JHPHELAN/stingray/README.md

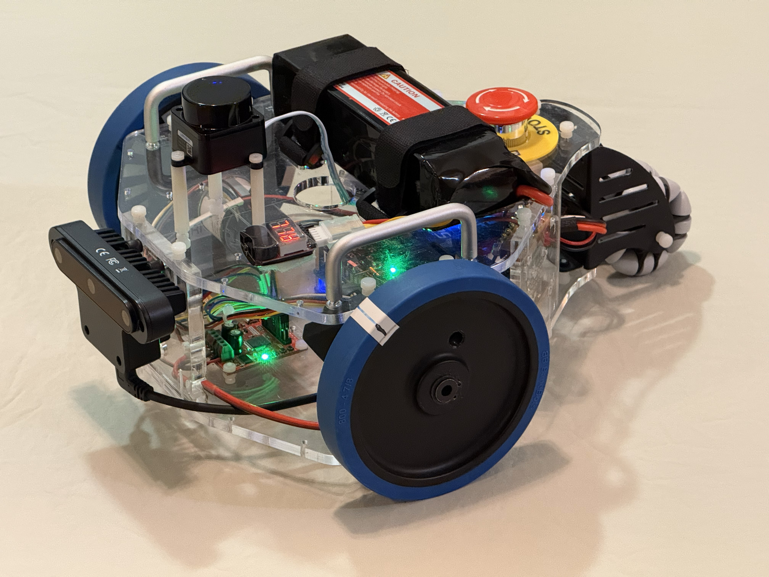
[picture p1: images/Stormy Portrait angle.jpg]


## Stormy full schematic (KiCad 10.0, 2026-10-14)

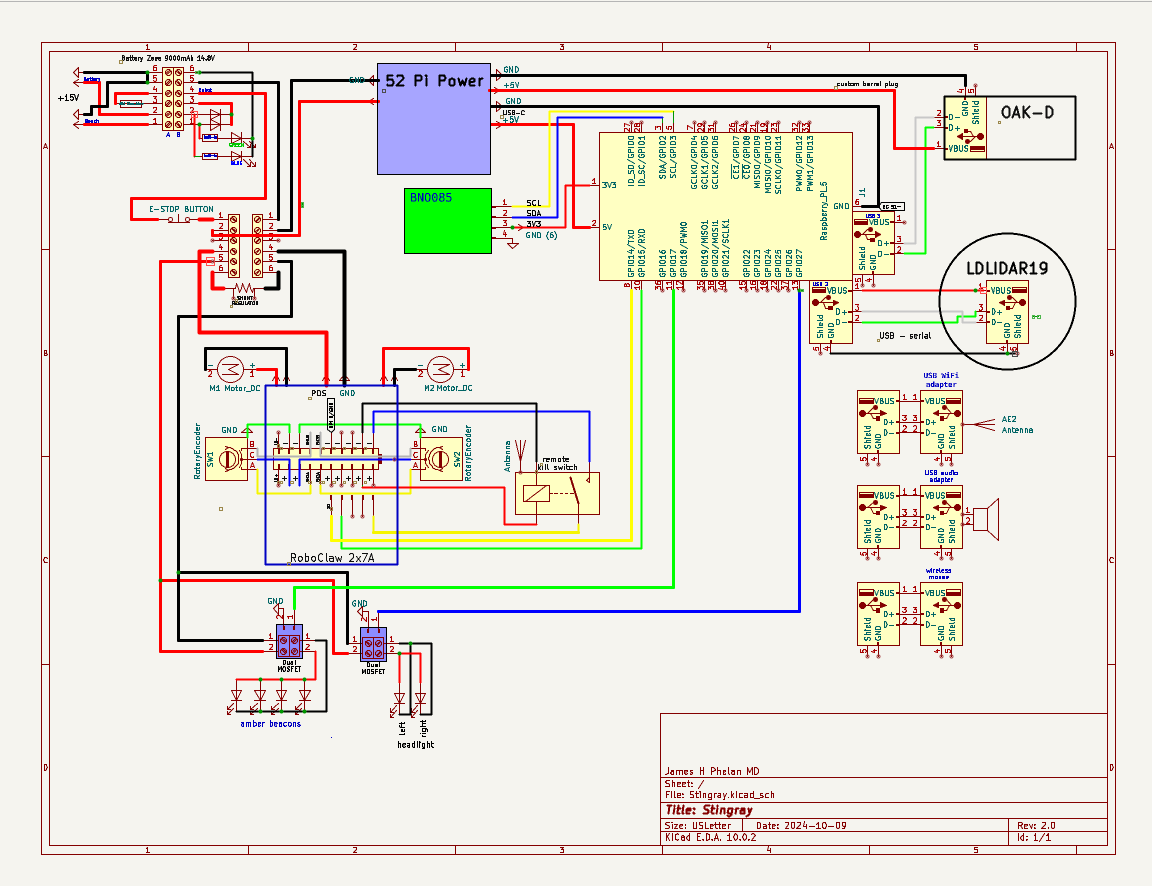
[picture p2: images/Schematic Full 20261026.png]


### Download the editable KiCad 10.0 project

[`CAD/KiCAD/`](CAD/KiCAD) — open [`Stingray.kicad_pro`](CAD/KiCAD/Stingray.kicad_pro) in KiCad 10.0. To grab the whole project, [download the repo as a ZIP](https://github.com/JHPHELAN/stingray/archive/refs/heads/main.zip) and open the `CAD/KiCAD/` folder.

<table>
<tr>
<td width="50%">
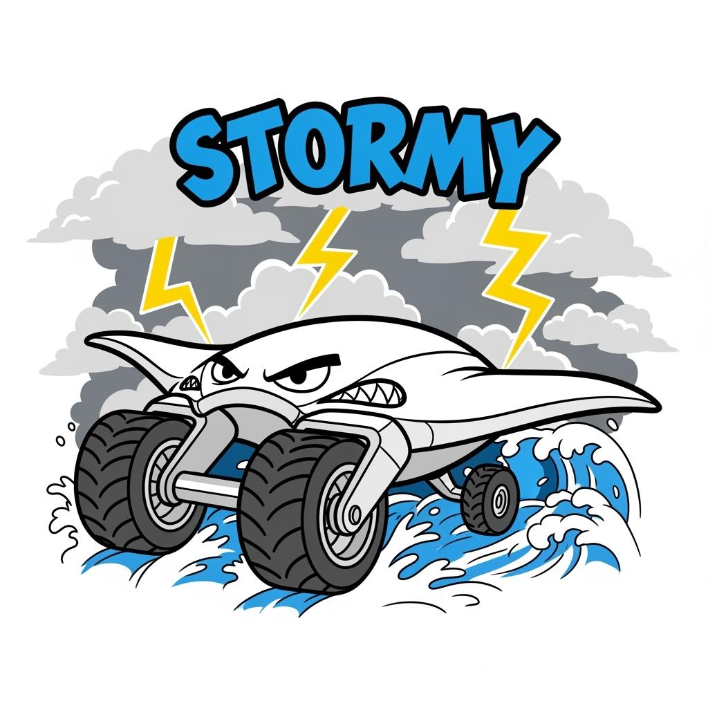
[picture p3: images/Stormy Logo.jpg]

Stormy logo created by LogoDesignGen
</td>
<td width="50%">
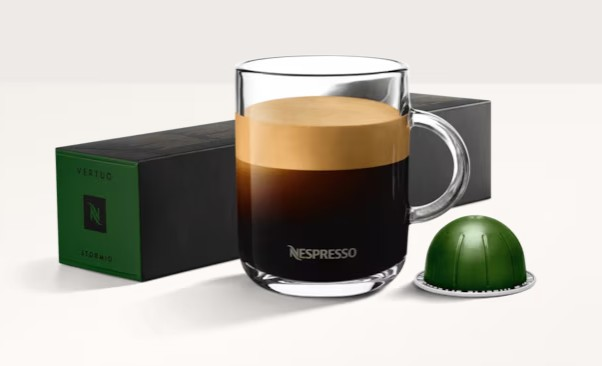
[picture p4: images/Nespresso Stormio.jpg]

Stormio the 'official' coffee of Stormy the Stingray Robot
<br>
<a href="https://www.nespresso.com/us/en/order/capsules/vertuo/stormio-vertuo-coffee-pods">Product Link (Nespresso)</a>
</td>
<tr>
<td width="50%">
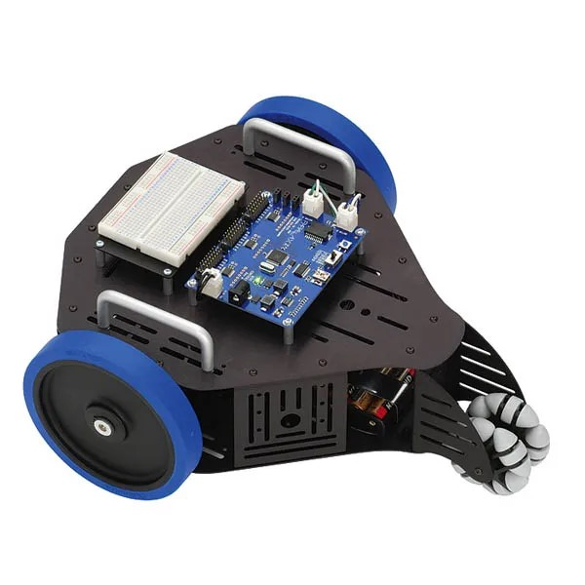
[picture p5: images/stingray3.jpg]

Original Parallax Stingray robot, no longer in production
</td>
<td width="50%">
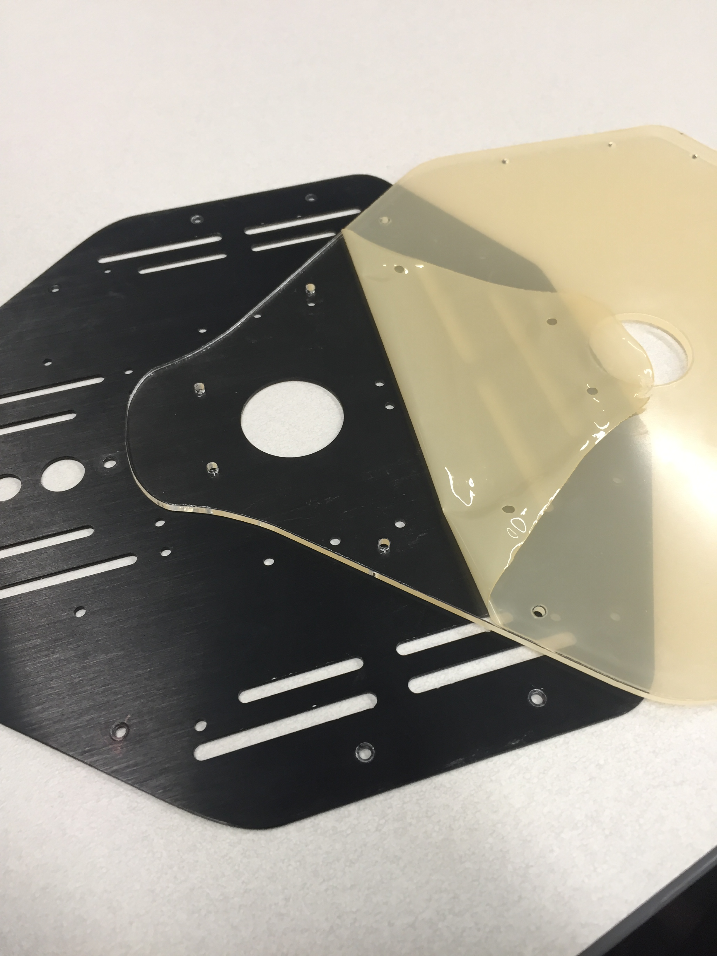
[picture p6: images/Original to Acrylic.JPG]

Recreating Stingray top/bottom plates in 1/4" acrylic
</td>
</tr>
</table>
**Assembled Stormy the Stingray robot**

<table>
<tr>
<td width="50%">
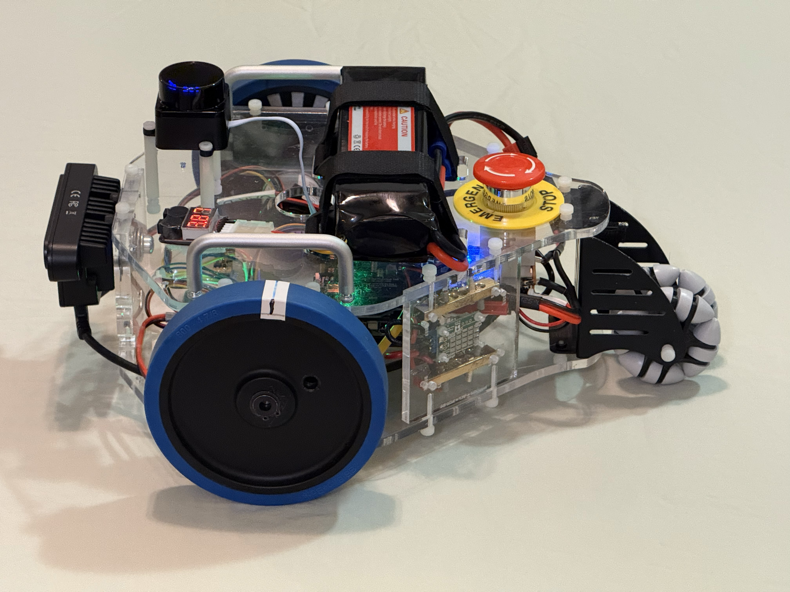
[picture p7: images/Stormy Portrait Left.jpg]

</td>
<td width="50%">
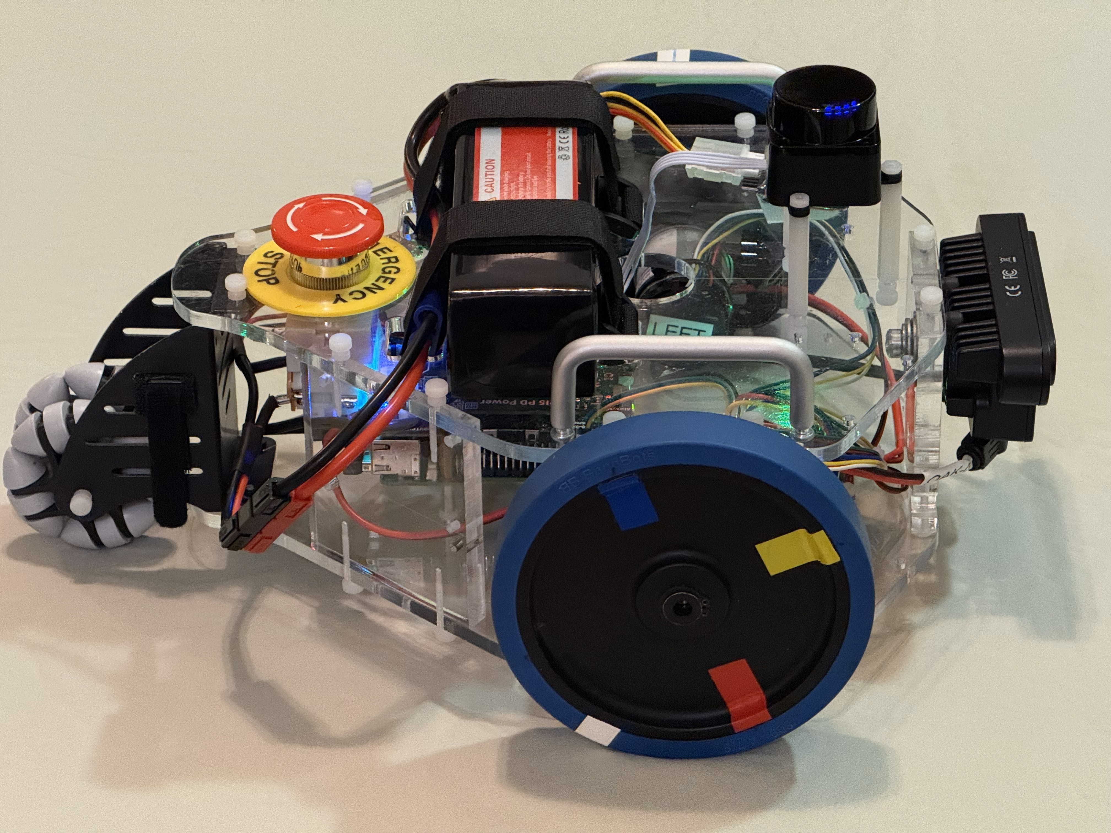
[picture p8: images/Stormy Portrait Right.jpg]

</td>
</tr>
<tr>
<td width="50%">
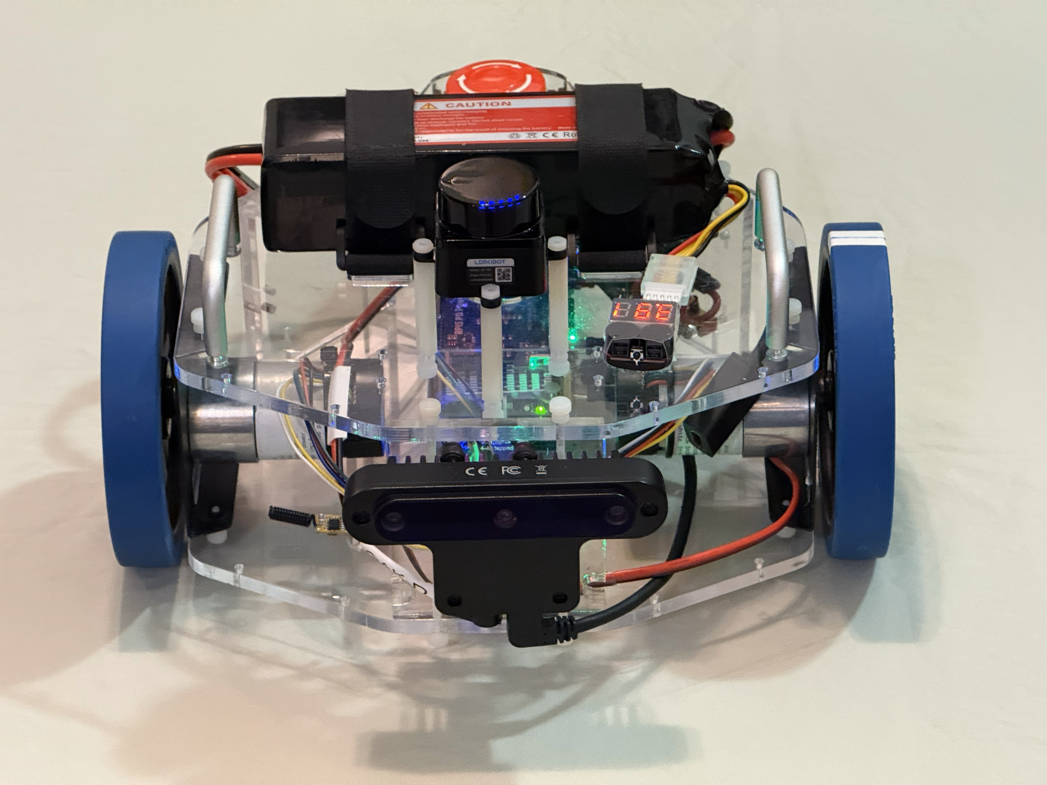
[picture p9: images/Stormy Portrait Front.jpg]

</td>
<td width="50%">
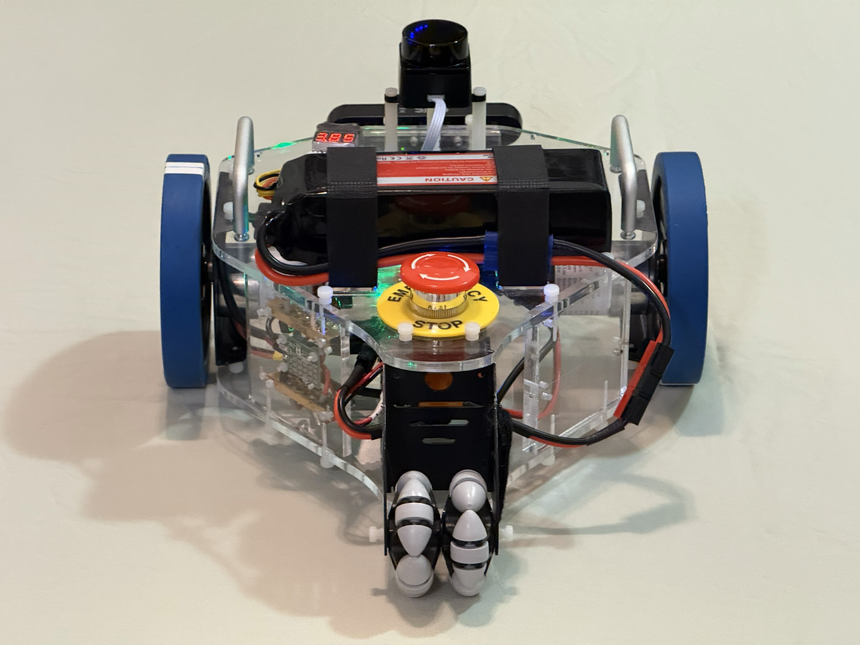
[picture p10: images/Stormy Portrait Rear.jpg]

</td>
</tr>
<tr>
<td width="50%">
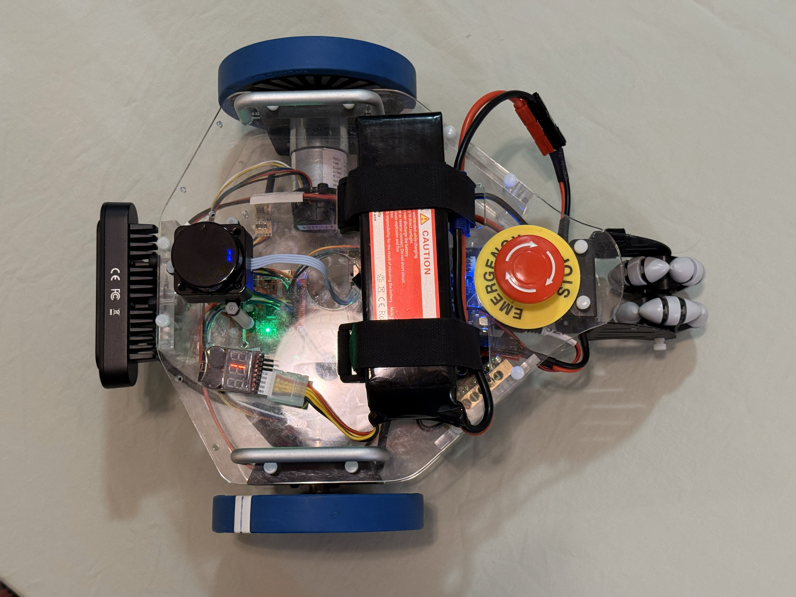
[picture p11: images/Stormy Portrait Top.jpg]

</td>
<td width="50%">

</td>
</tr>
</table>

## Documentation

Full build and rebuild procedures for Stormy - subsystem chapters,
wiring, RoboClaw configuration, ROS 2 setup, Nav2 / SLAM tuning, and
diagnostics - live in a separate companion repository:

- **[stingray-builders-manual](https://github.com/JHPHELAN/stingray-builders-manual)**
  (private) - contains the Builder's Manual (22 chapters + 7
  appendices, plain text), the Field Notes (103 numbered
  field-tested lessons), and the Curation Notes (stardated
  distillate of the source log).

This `README` is the hardware **photo + sourcing catalog** - "what does
it look like and where do I buy it".  The Manual is the build guide -
"how do I put it together, configure it, and rebuild it after
disaster".

**Software** (ROS 2 drivers, launch files, URDF, Nav2 params) lives in
a separate repo:

- https://github.com/JHPHELAN/articubot_one - branch `exploration` is
  the current work.

---

## HARDWARE

> [!WARNING]
> **Two Parallax originals no longer available**
>
> ---
>
> **1. Rear caster**
>
> The original Parallax omni-wheel rear caster and its bracket are
> both out of production and there is no drop-in substitute today.
> If you intend to build this robot, you will have to solve the rear-
> caster problem yourself: source or 3D-print a small omni-wheel and
> design a bracket that holds it at the correct height to keep the
> chassis level with the drive wheels.
>
> Closest similar omni on Amazon as of 2026-08 is
> [B0DDVJS42J](https://www.amazon.com/dp/B0DDVJS42J), but it will
> require a custom bracket.
>
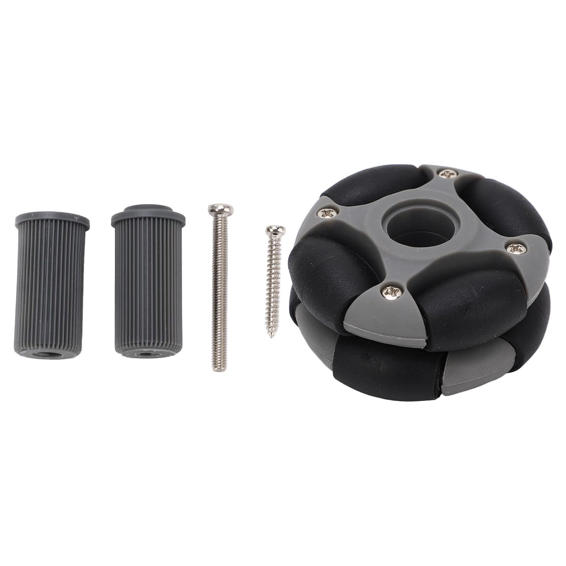
[picture p13: images/Omniwheel Caster replacement.jpg]
> 
>
> **Alternative under consideration — Pololu 3/4" metal ball caster**
>
> Mounted directly under the rear bottom plate.  Load rating ~10 lb
> (well within Stormy's measured 0.549 kg / 1.21 lb rear-caster load;
> total robot mass 3.269 kg).  Height 0.83" would tip the nose down;
> two candidate compensations:
>
> 1. **Rotate each drive motor 180°** so the asymmetric shaft sits at
>    the lower position, dropping the wheel ~1 cm, and lower the side-
>    plate motor hole to match.  With the existing ~1 cm clearance
>    below the motors that gives ~2 cm of adjustment to work with.
> 2. **Acrylic riser mount** — a short piece of laser-cut 1/4" acrylic
>    rounded to complement the caster, with spacers as needed, placed
>    on top of the lower plate to raise the ball caster to the correct
>    height without touching the drive wheels.
>
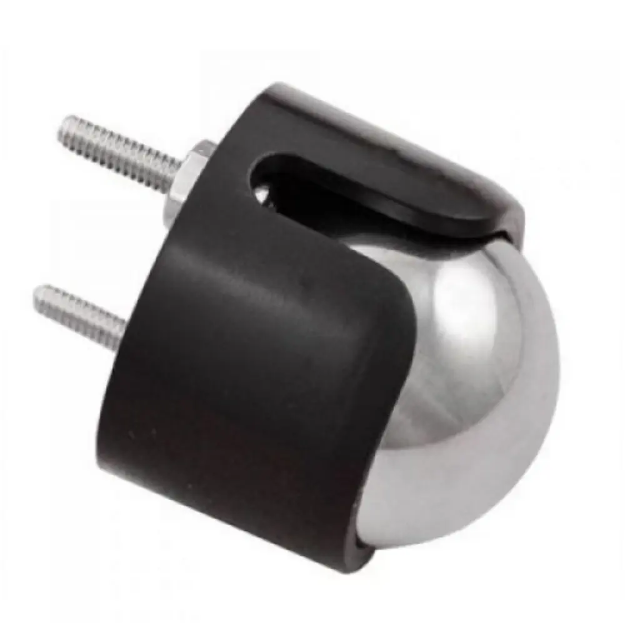
[picture p14: images/Pololu ball caster 3-4in.png]
> 
>
> [Product Link (Robotshop)](https://www.robotshop.com/products/pololu-ball-caster-3-4-in-metal-ball)
>
> Reference material for the bracket design:
>
> Original Parallax exploded diagram:
>
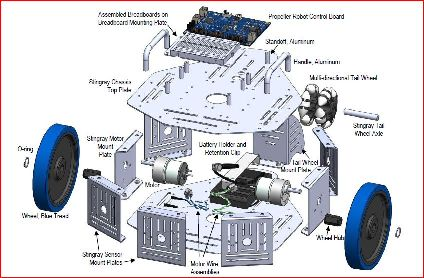
[picture p15: images/Parallax-StingRay-Robot-exploded.JPG]
> 
>
> Current Stormy bottom view:
>
> 
>
> Current bracket, measured with ruler:
>
> 
> 
> 
>
> ---
>
> **2. Motor / wheel side support brackets**
>
> The two side brackets that hold the drive-motor / wheel assemblies
> are also Parallax originals and out of production.  They are NOT
> reproducible in 1/4" cast acrylic - the tolerances are too tight -
> so they must be fabricated in sheet metal.  The originals have
> captive nuts pressed into the flap, which is very convenient;
> replacements with plain bolt-and-nut hardware work but are less
> handy.  A local maker space with a sheet-metal brake can probably
> make these to order.
>
> Dimensions (measured off the originals):
> - Side panel: 3" wide x 3" high, center-drilled for the 1/4"
>   motor output shaft.
> - Top and bottom right-angle flaps: 5/8" wide.
> - Inset captive nuts: 1 3/4" apart, 3/8" from the outer edge.
>
> *TODO: add photo of an original bracket + a dimensioned drawing.*

### Structural stock

Top plate, side plates, and bottom plate are all laser-cut from 1/4"
cast acrylic sheet.  One 12" x 12" sheet is enough for a full set.

<table>
<tr>
<td width="33%" align="center">
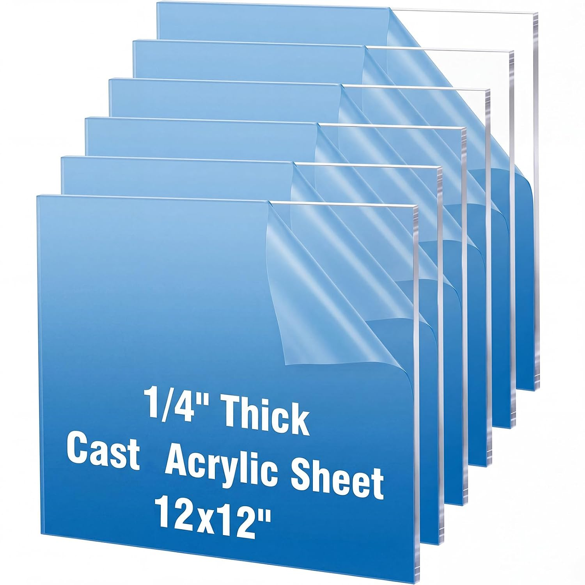
[picture p16: images/acrylic sheet 0.25x12x12 cast clear.png]

<br>
<b>Novabright clear cast acrylic, 1/4" x 12" x 12"</b>
<br>
<a href="https://www.amazon.com/dp/B0GSVXQC45">Product Link</a>
</td>
</tr>
</table>

#### CorelDRAW 2018 CAD drawings for laser cutting

<table>
<tr>
<td width="33%" align="center">
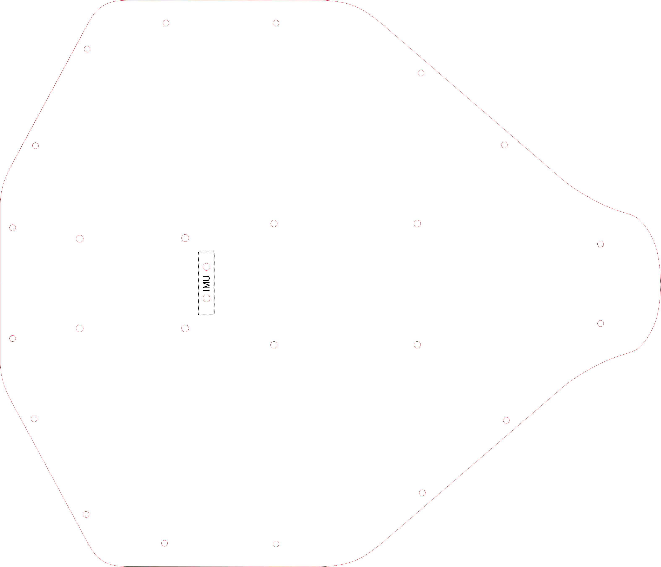
[picture p17: images/Stingray Bottom Plate.jpg]

<br>
<a href="CAD/CorelDraw/Stingray%20Bottom%20Plate.cdr">Bottom plate (.cdr)</a>
</td>
<td width="33%" align="center">
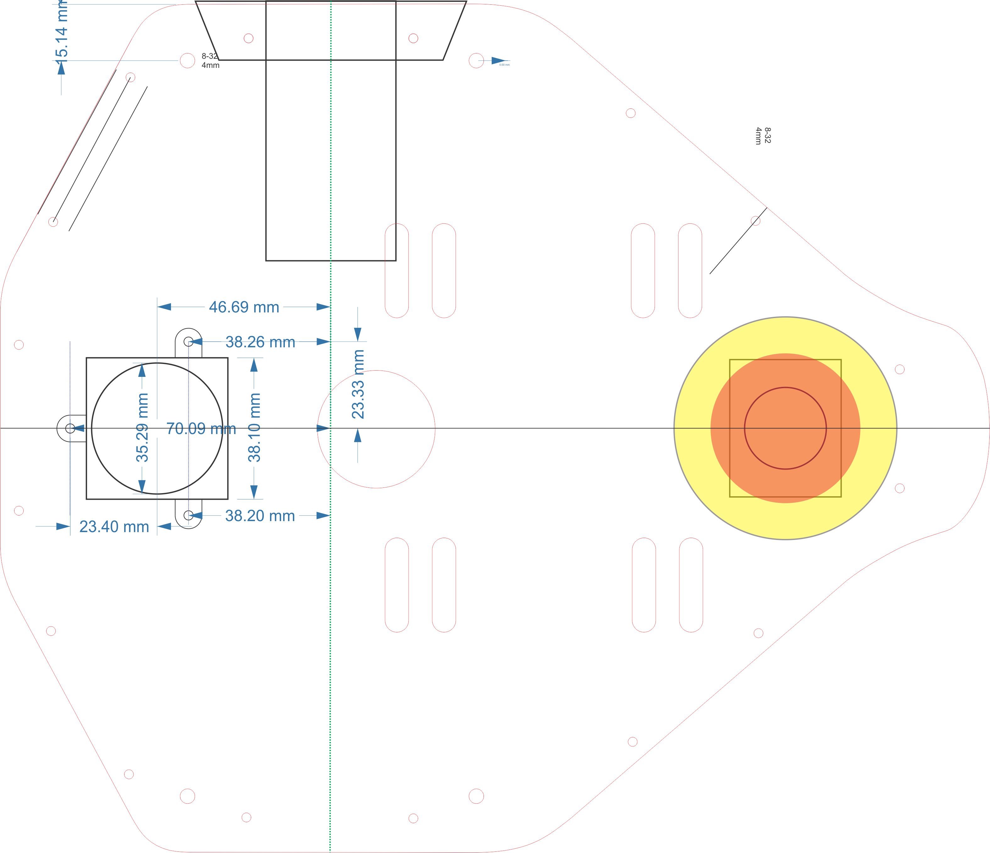
[picture p18: images/Stingray Top Plate.jpg]

<br>
<a href="CAD/CorelDraw/Stingray%20Top%20Plate.cdr">Top plate (.cdr)</a>
</td>
<td width="33%" align="center">
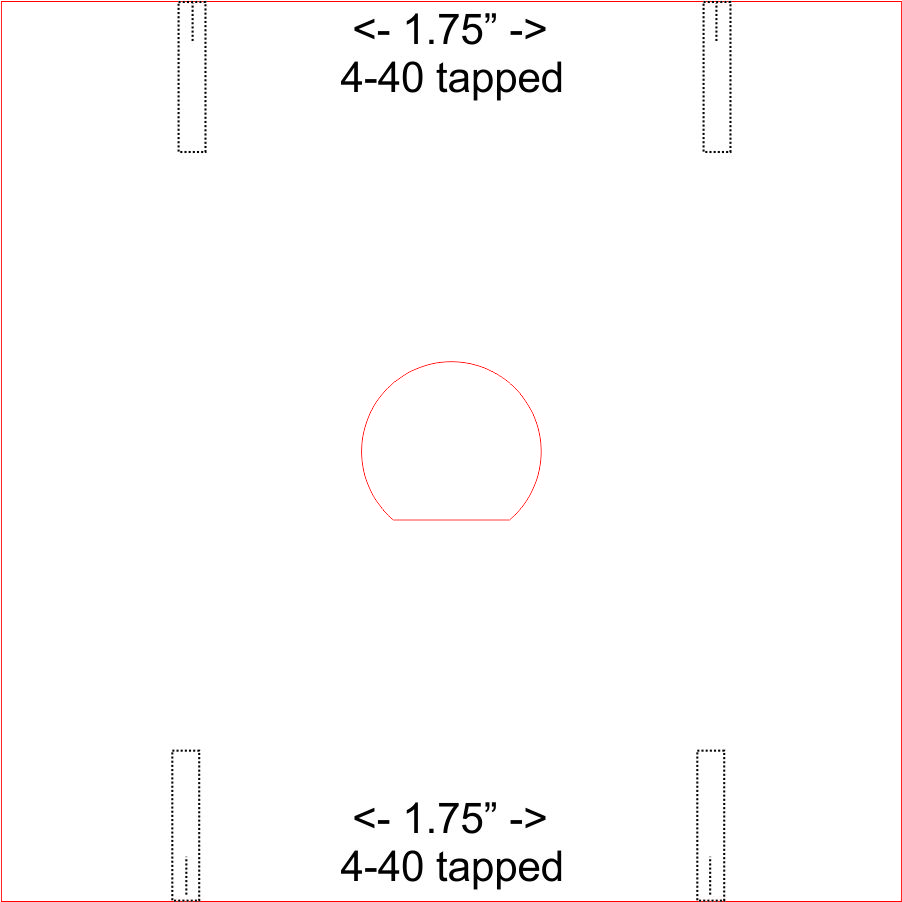
[picture p19: images/Stingray Side Panel Blank.jpg]

<br>
<a href="CAD/CorelDraw/Stingray%20Side%20Panel%20Blank.cdr">Side panel (.cdr)</a>
<br>
<i>Blank example showing the fuse-holder hole</i>
</td>
</tr>
</table>

<table>
<tr>
<td width="33%" align="center">
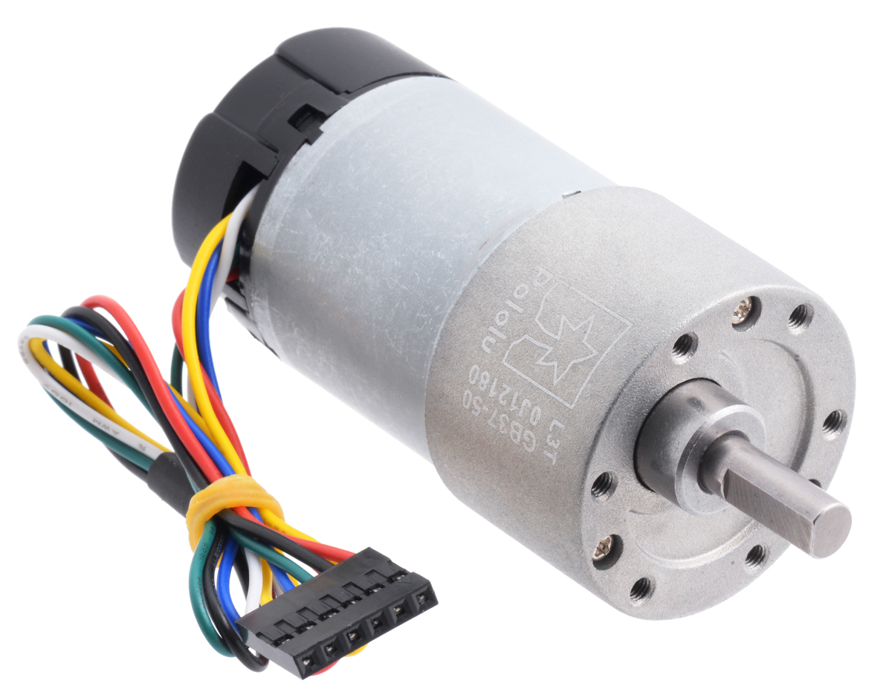
[picture p20: images/Pololu 37D 70mm 12V 50-1 64 CPR gearmotor.jpg]

<br>
2 motors: Pololu 50:1 37Dx70L mm 12V 64 CPR Encoder 6mm D output shaft
<br>
50 x 64 = 3200 counts / revolution
<br>
<a href="https://www.pololu.com/product/4753">Product Link</a>
</td>
<td width="33%" align="center">
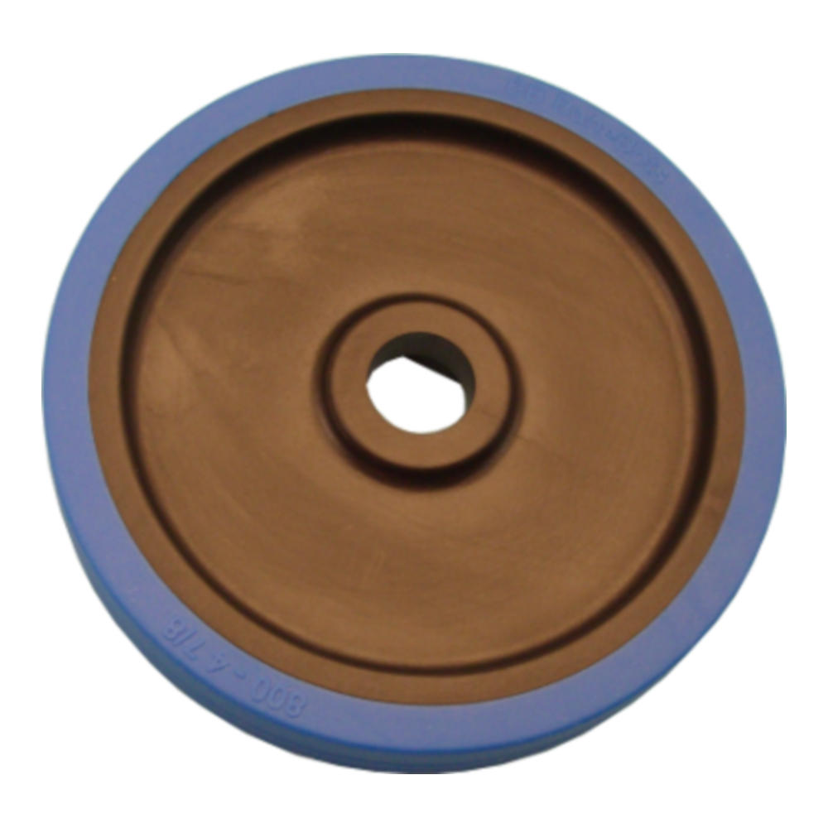
[picture p21: images/Stingray Wheel.jpg]

<br>
2 BaneBots 4 7/8" T81 hex hub wheels (no longer available from Parallax)
<br>
<a href="https://banebots.com/banebots-wheel-4-7-8-x-0-8-hub-mount-50a-blue/">Product Link</a>
</td>
<td width="33%" align="center">
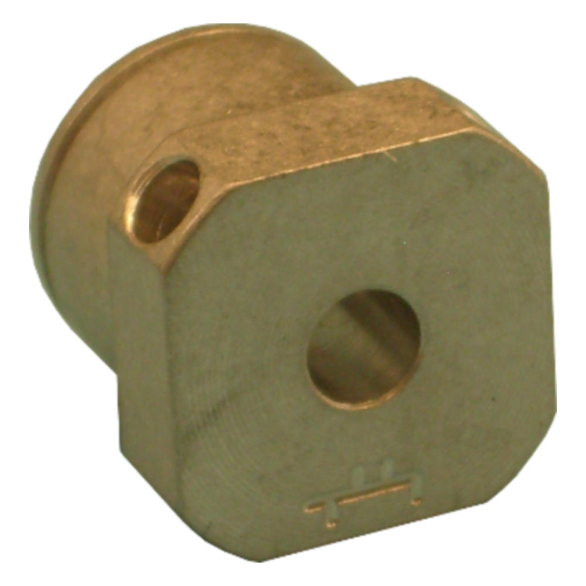
[picture p22: images/Stingray Wheel Hub Adapter.jpg]

<br>
6mm D to 12mm Hex snap ring hub adapter. 3D CAD file on source web site.
<br>
<a href="https://banebots.com/t81-hub-6mm-shaft/">Product Link</a>
</td>
</tr>
</table>

**Wheel Specifications:**

4 7/8" dia = 0.123825m dia

wheel radius = 0.123825m dia / 2 = 0.0619125 = 0.062m

wheel circumference = 0.123825m dia x Pi = 0.3890m circ = m/rev

confirmed by tape measurement of circumference

revolutions / meter = 1m / 0.39 m/R = 2.57 R/m

counts / meter = 2.57 R/m x 3200 C/R = 8226 C/m

## CPU

<table>
<tr>
<td width="50%" align="center">
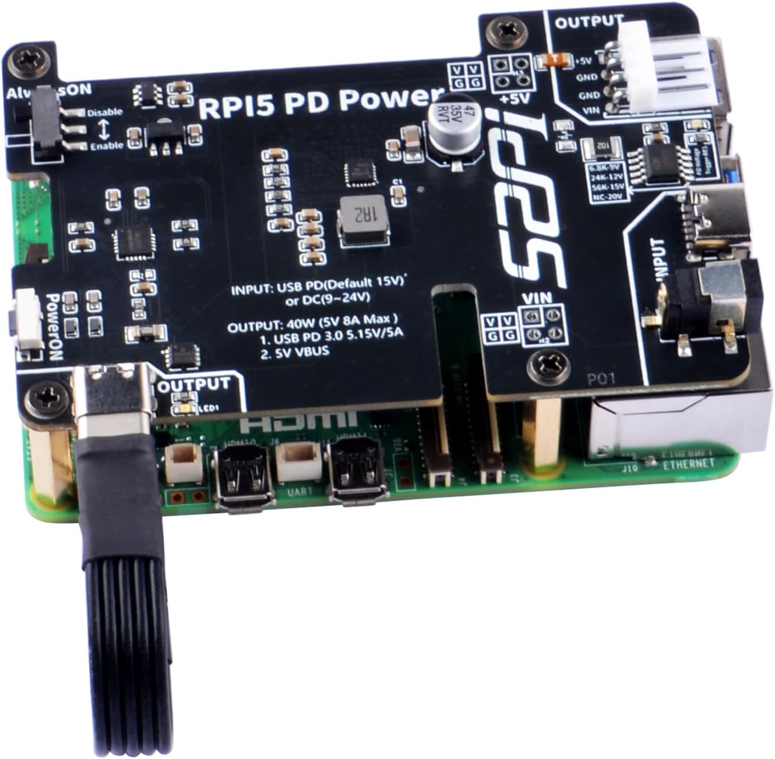
[picture p23: images/52Pi PD Power Expansion Board.jpg]

<br>
<b>GeeekPi PD Power Expansion Board</b>
<br>
<a href="https://52pi.com/collections/raspberry-pi-1/products/52pi-pd-power-extension-adapter-board-for-raspberry-pi-5">Product Link</a>
</td>
<td width="50%" align="center">
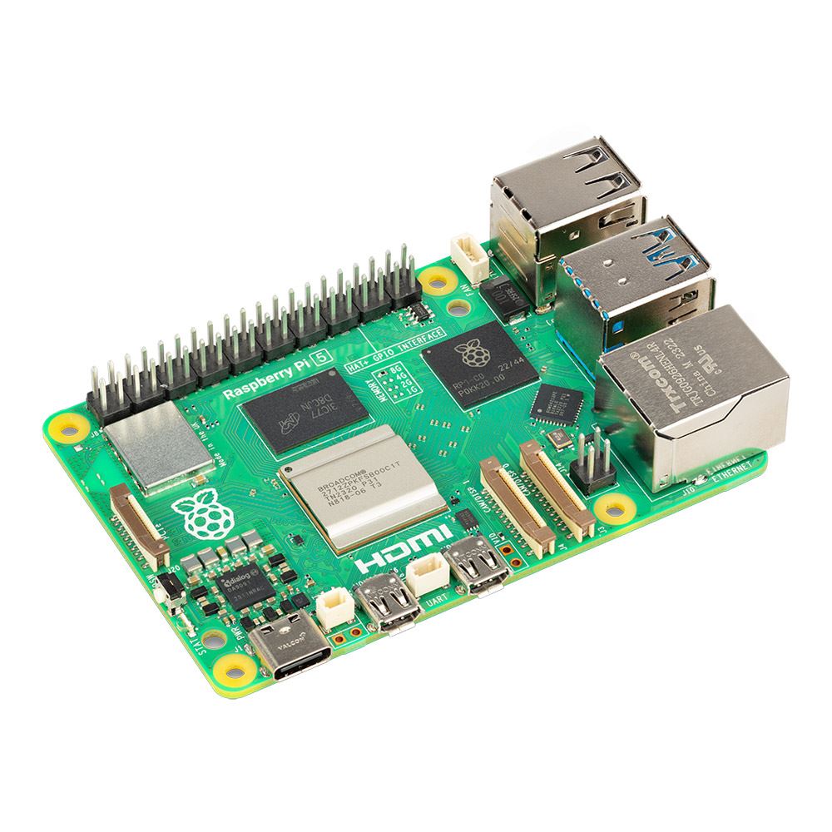
[picture p24: images/Raspberry Pi 5 8GB.jpg]

<br>
<b>Raspberry Pi 5 8GB</b>
<br>
<a href="https://www.raspberrypi.com/products/raspberry-pi-5/">Product Link</a>
</td>
</tr>
<tr>
<td width="50%" align="center">
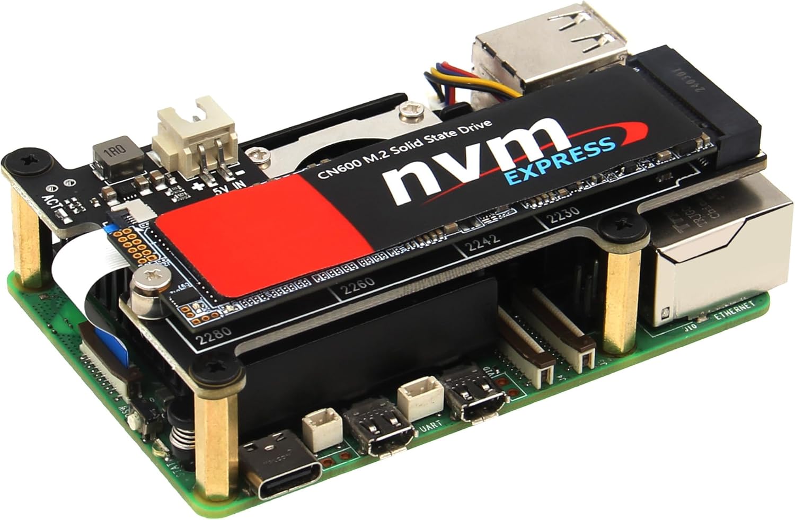
[picture p25: images/PCIe to NVME SSD memory hat.jpg]

<br>
<b>PCIe Hat</b>
<br>
<a href="https://www.amazon.com/dp/B0CPPGGDQT">Product Link</a>
</td>
<td width="50%" align="center">
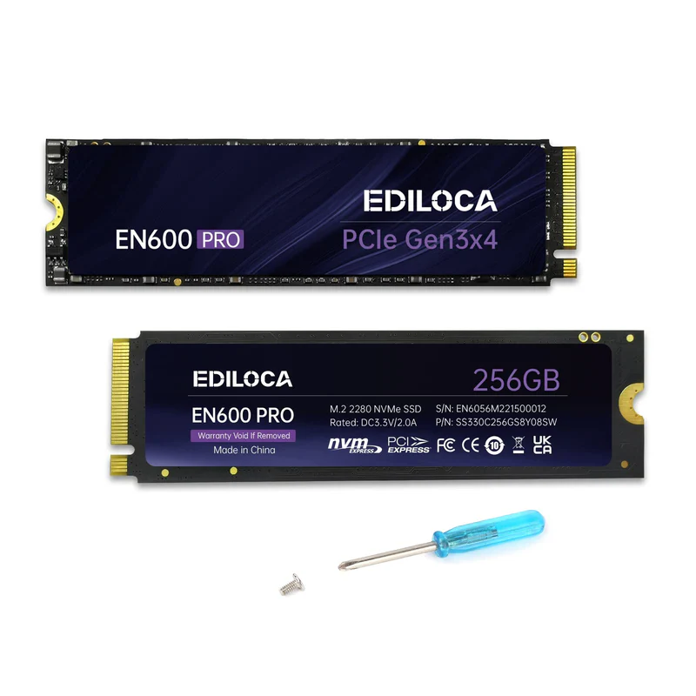
[picture p26: images/Ediloca EN600 PRO M.2 SSD PCle 3.0x4.png]

<br>
<b>PCIe Memory</b>
<br>
<a href="https://www.amazon.com/dp/B0C5D6C1YQ">Product Link</a>
</td>
</tr>
</table>

## Power

<table>
<tr>
<td width="33%" align="center">
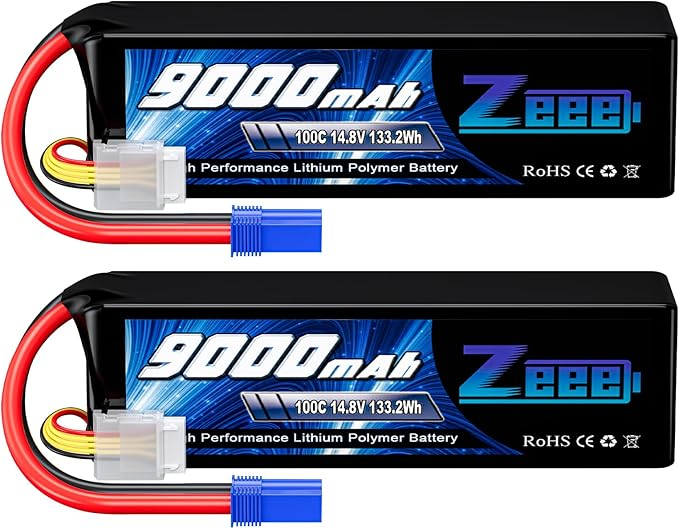
[picture p27: images/Zeee9000LiPoBattery.jpg]

<br>
<b>LiPo 14.8V 9000mAh 100C Zeee battery</b>
<br>
<a href="https://www.amazon.com/dp/B09NKCKWV3">Product Link</a>
</td>
<td width="33%" align="center">
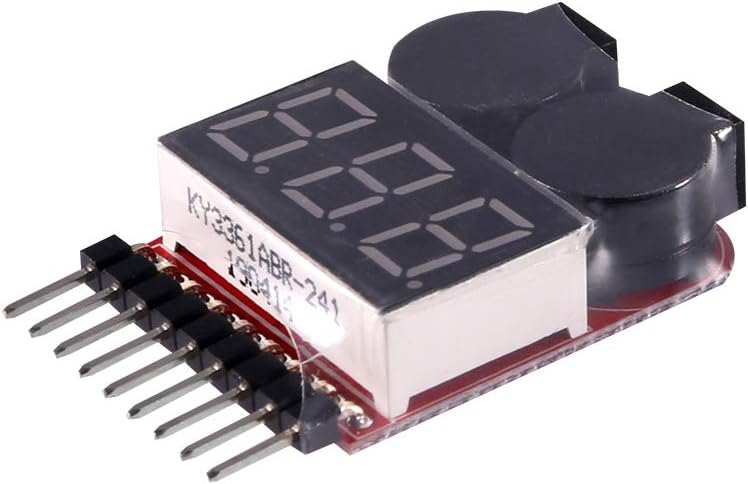
[picture p28: images/LiPo battery screamer.jpg]

<br>
<b>LiPo battery low voltage 'screamer'</b>
<br>
<a href="https://www.amazon.com/dp/B08YY5ZL93">Product Link</a>
</td>
<td width="33%" align="center">
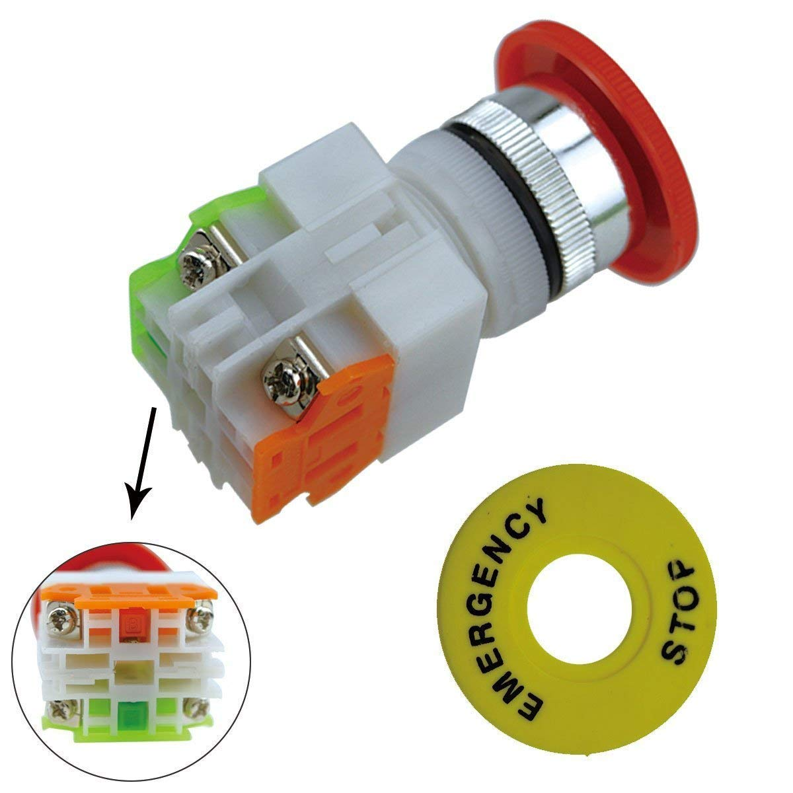
[picture p29: images/Emergency Stop Button.jpg]

<br>
<b>Emergency stop button</b>
<br>
<i>Breaks the LiPo &rarr; bus.<br>See Manual &sect;3.2.</i>
<br>
<a href="https://www.amazon.com/dp/B07BCY7HGN">Product Link</a>
</td>
</tr>
<tr>
<td width="33%" align="center">
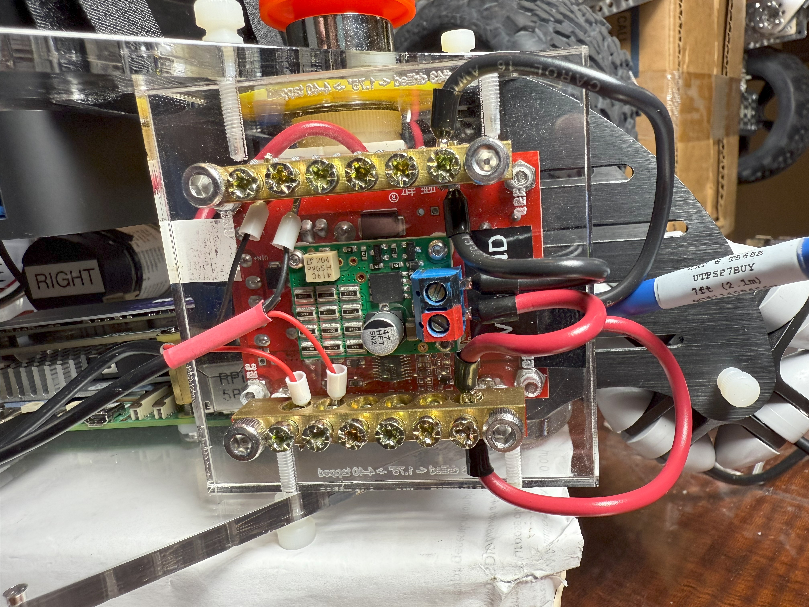
[picture p30: images/PowerBusShuntReg.jpg]

<br>
<b>12V power bus</b>
<br>
<a href="https://www.amazon.com/dp/B097R5J66D">Product Link (bus bar)</a>
<br>
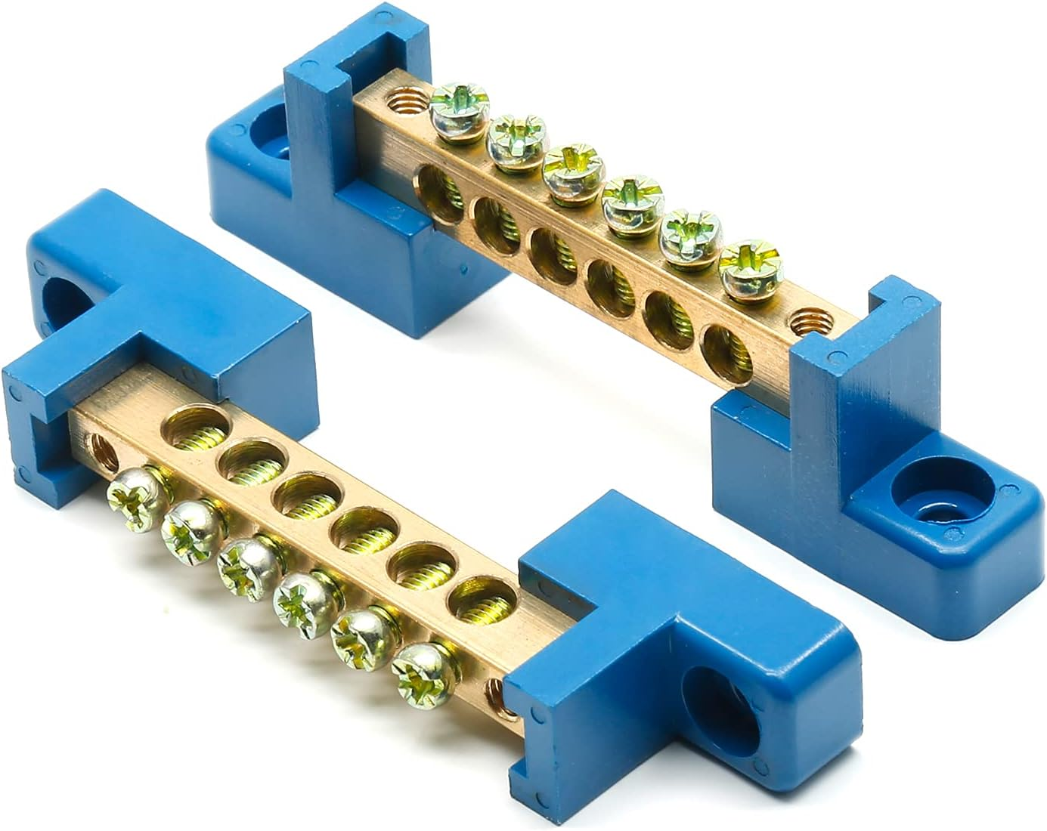
[picture p31: images/bus bar.png]

</td>
<td width="33%" align="center">
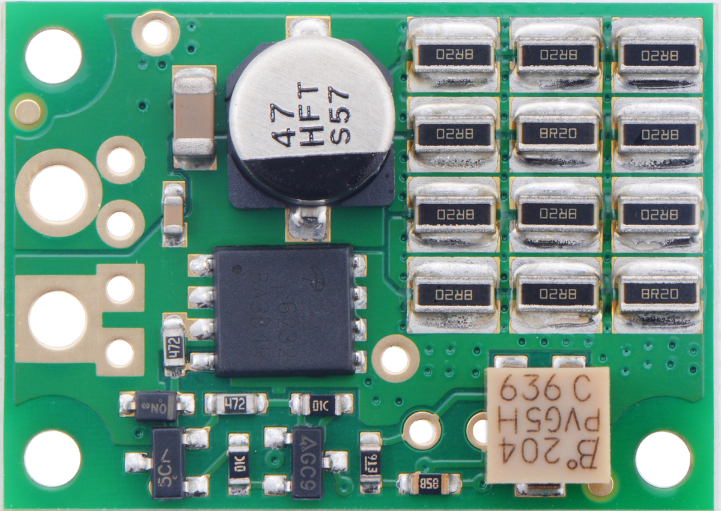
[picture p32: images/Pololu 3779 Shunt Regulator.jpg]

<br>
<b>Shunt Regulator</b>
<br>
<a href="https://www.pololu.com/product/3779">Product Link</a>
</td>
<td width="33%" align="center">
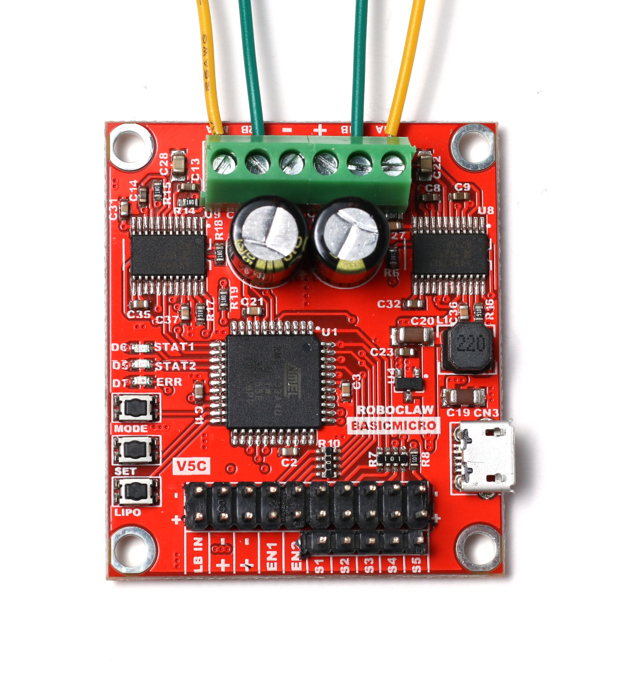
[picture p33: images/RoboClaw2x7A.jpg]

<br>
<b>Roboclaw 2x7A</b>
<br>
<a href="https://www.basicmicro.com/Roboclaw-2x7A-Motor-Controller_p_55.html">Product Link</a>
</td>
</tr>
<tr>
<td width="33%" align="center">
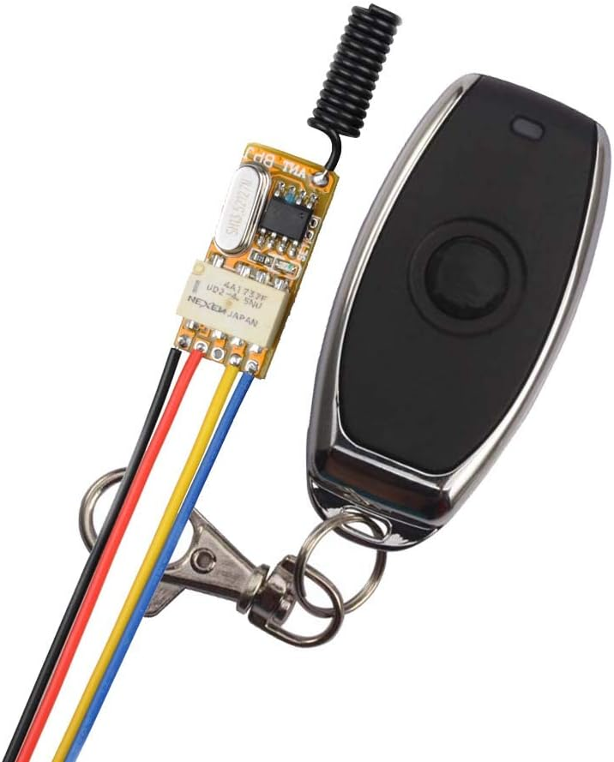
[picture p34: images/MiniRemoteRelay1.jpg]

<br>
<b>Remote kill switch</b>
<br>
<i>Kills RoboClaw power to motors only.<br>Bus remains live.<br>See Manual &sect;3.2.</i>
<br>
<a href="https://www.amazon.com/dp/B08D39XWS5">Product Link</a>
</td>
<td width="33%" align="center">
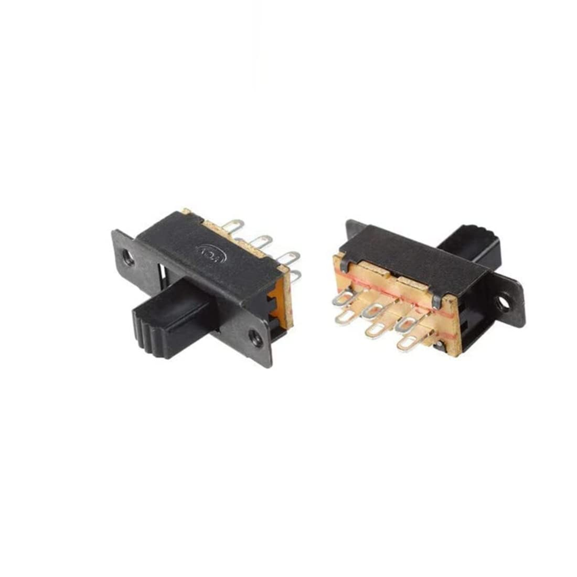
[picture p35: images/Switch DPDT slide panel mount.jpg]

<br>
<b>Slide switch DPDT to control headlights and RoboClaw reset</b>
<br>
<a href="https://www.amazon.com/dp/B09V77VCF7">Product Link</a>
</td>
<td width="33%" align="center"></td>
</tr>
</table>

### Power Input Panel permits crossover of power to/from Battery and Bench supplies

<table>
  <tr>
    <td width="33%" align="center">
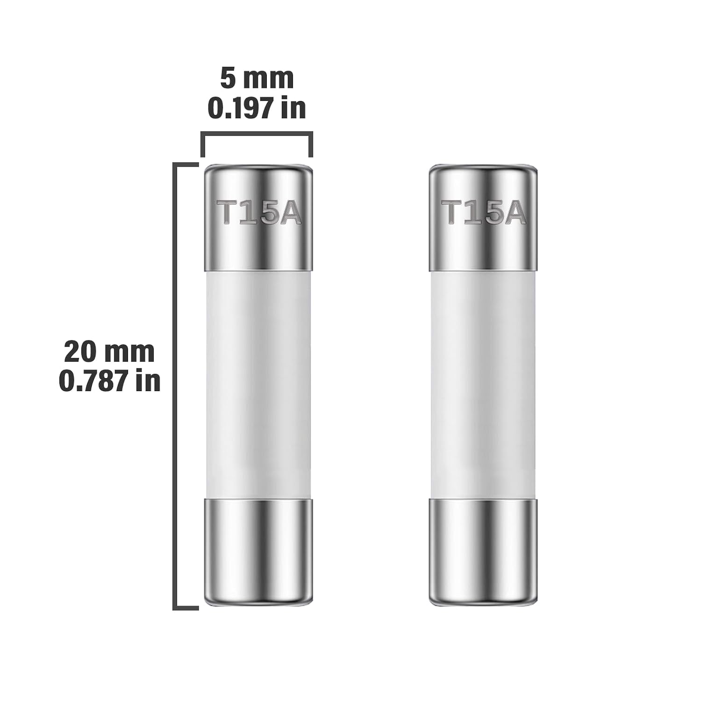
[picture p36: images/fuse 15A slow blow 5x20mm.png]
      
      <br>
      <b>15 A slow-blow 5x20 mm ceramic fuse</b>
      <br>    
      <a href="https://www.amazon.com/dp/B0CRVLV5LY">Product Link</a>
    </td>
    <td width="33%" align="center">
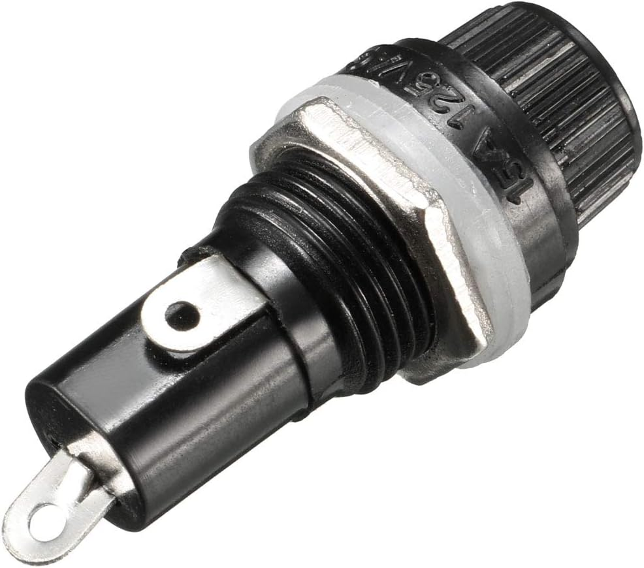
[picture p37: images/fuse holder.jpg]
      
      <br>
      <b>Panel-mount fuse holder, 5x20 mm</b>
      <br>
      <a href="https://www.jameco.com/webapp/wcs/stores/servlet/ProductDisplay?productId=18703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">Product Link (Jameco 18703)       </a>
    </td>
    <td width="33%" align="center">
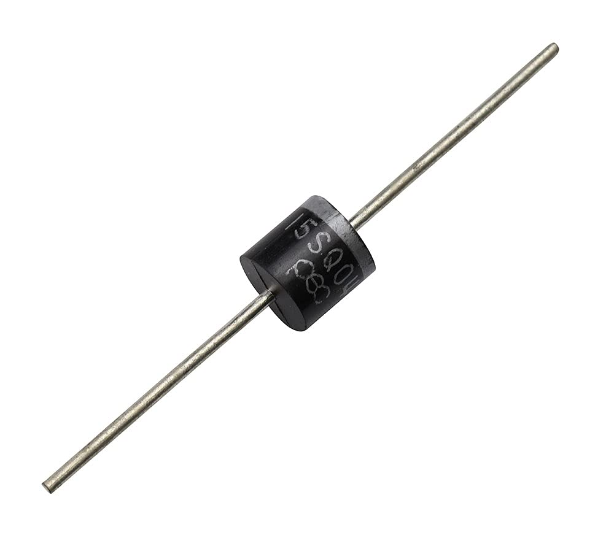
[picture p38: images/Schottky Diode 15SQ045.jpg]
      
      <br>
      <b>Schottky diode 15SQ045</b>
      <br>
      <i>ORing circuit blocks reverse current during power crossover</i>
      <br>
      <a href="https://www.amazon.com/dp/B0DQGSDM6K">Product Link (Amazon)</a>
    </td>
  </tr>
  <tr>
    <td width="33%" align="center">
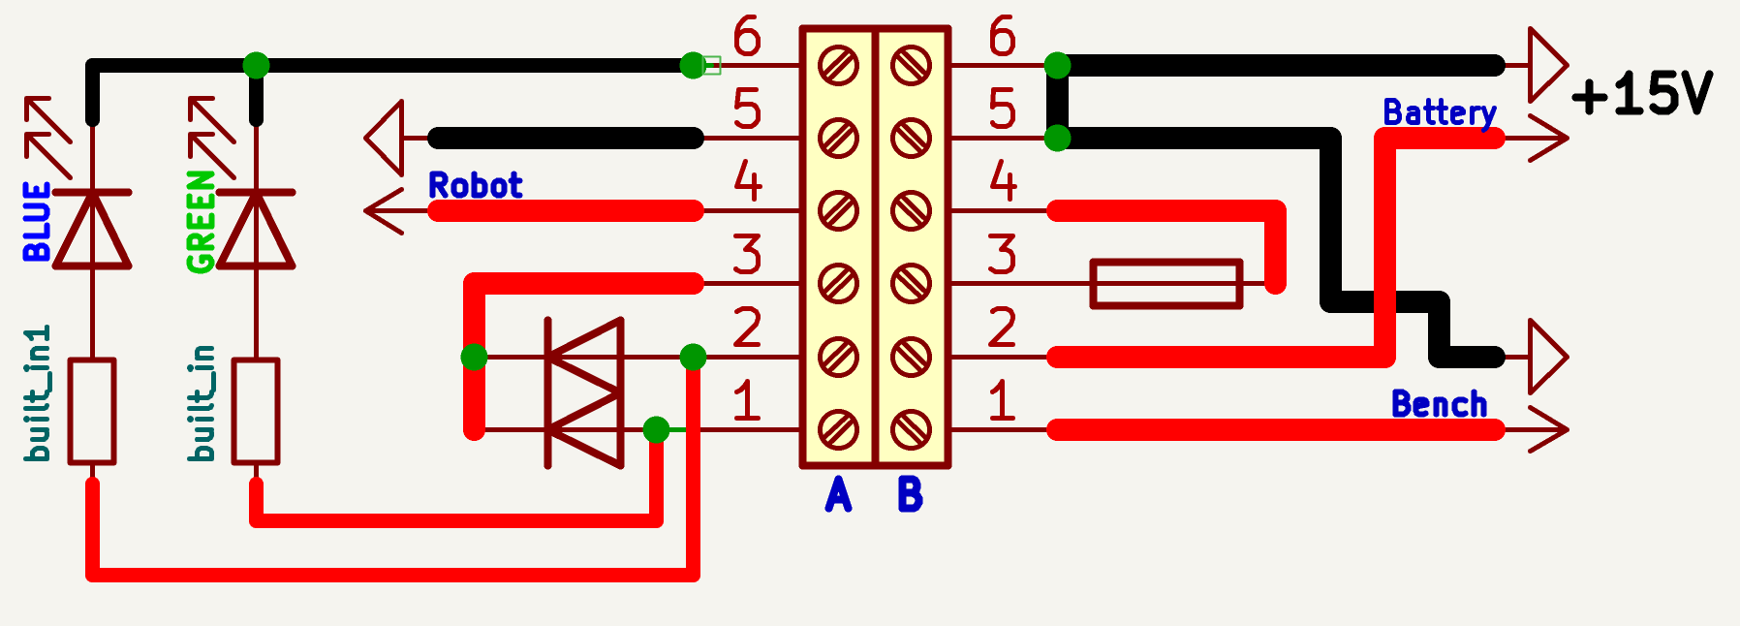
[picture p39: images/Power Input Panel 2 LEDs.png]
      
      <br>
    </td>
    <td width="33%" align="center">
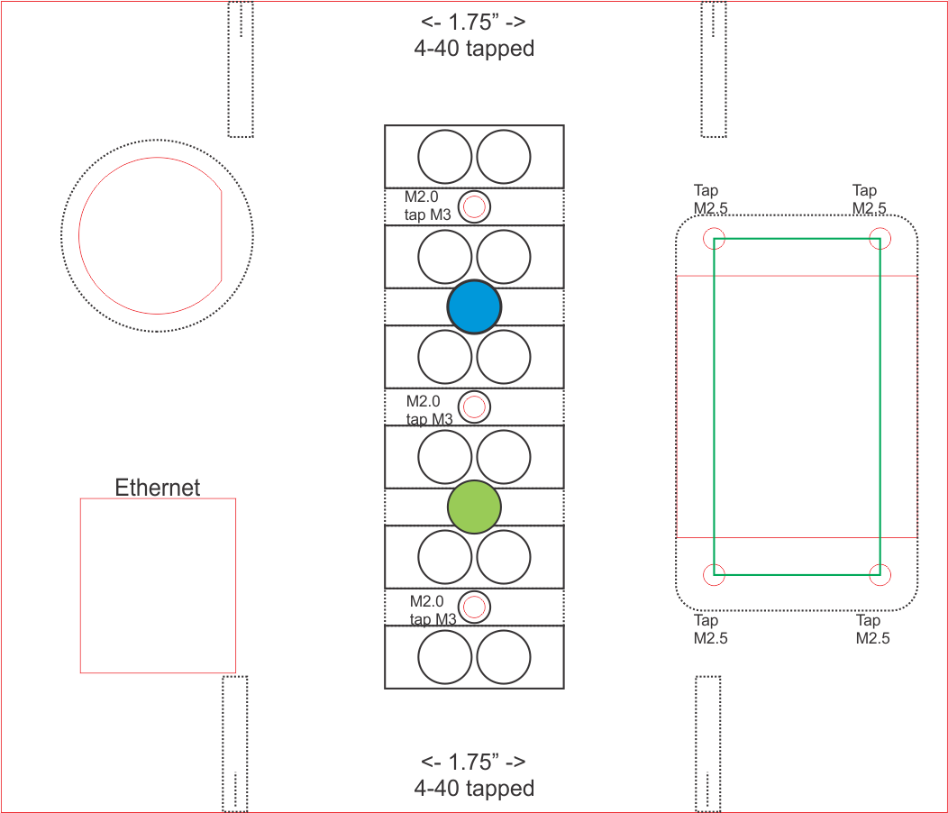
[picture p40: images/Side Panel Wide Right Rear Fuse PowerPole Terminal Ethernet 2 LEDs.png]
      
      <br>
    </td>
    <td width="33%" align="center">
    </td>
  </tr>
  <tr>
    <td width="33%" align="center">
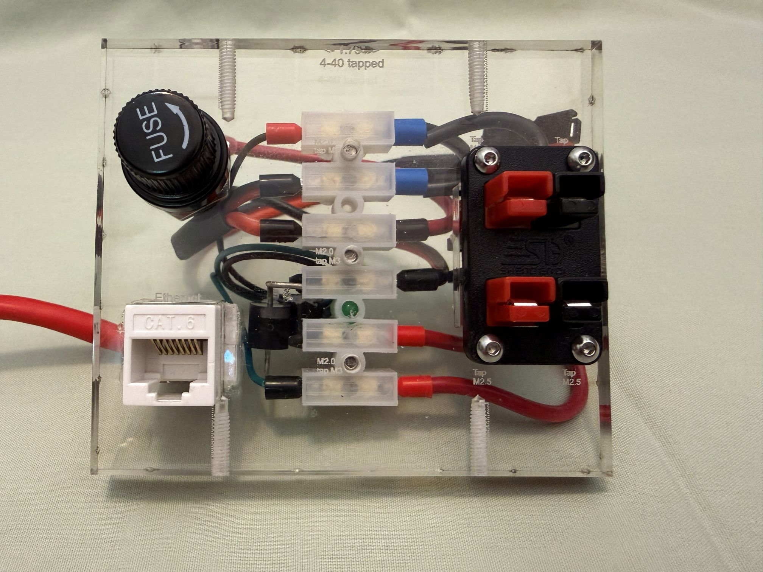
[picture p41: images/Power Input Panel LED front.jpg]
      
      <br>
    </td>
    <td width="33%" align="center">
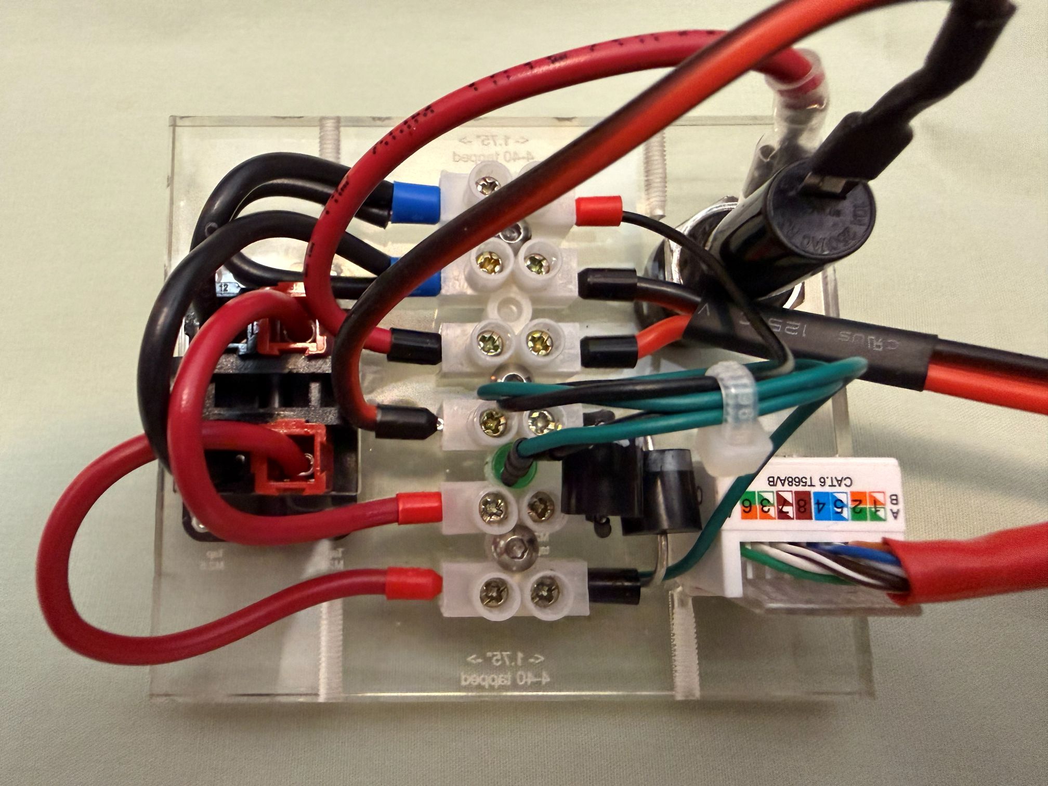
[picture p42: images/Power Input Panel LED back.jpg]
      
      <br>
    </td>
    <td width="33%" align="center">
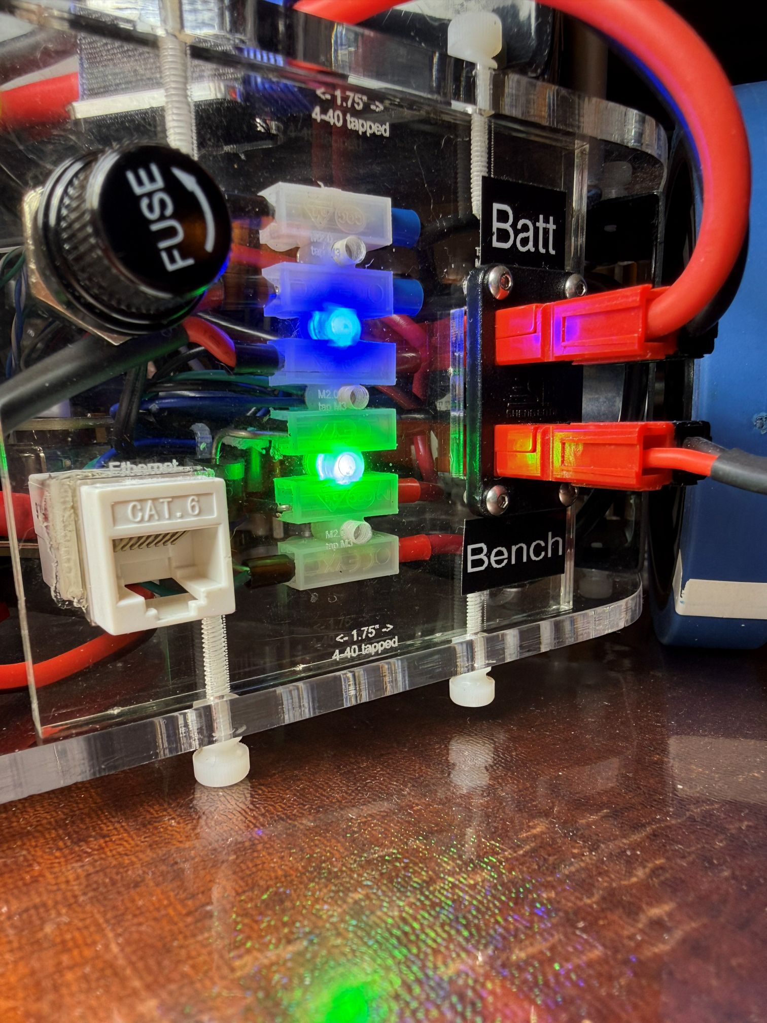
[picture p43: images/Power Input Panel Battery Blue LED 50pct.jpg]
      
      <br>
    </td>
  </tr>
  <tr>
    <td width="33%" align="center">
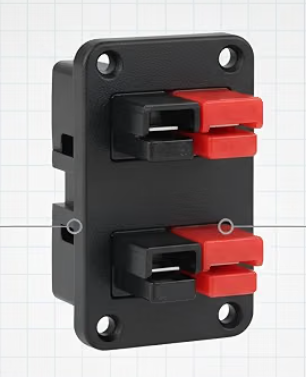
[picture p44: images/PowerPolePanelMount.png]
      
      <br>
      <a href="https://www.amazon.com/dp/B0CCXSY3KD">Product Link (Amazon)</a>
      <br>
    </td>
    <td width="33%" align="center">
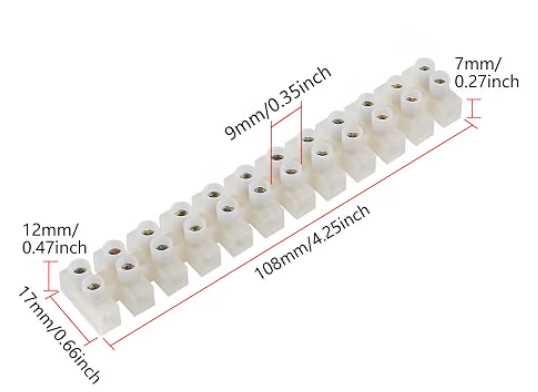
[picture p45: images/TerminalStrip12PosHoriz.png]
      
      <br>
      <a href="https://www.amazon.com/dp/B0D4DFFWBF">Product Link (Amazon)</a>
      <br>
    </td>
    <td width="33%" align="center">
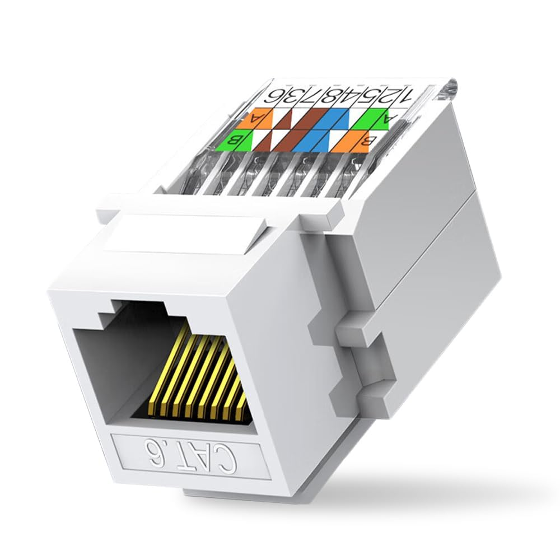
[picture p46: images/RJ45 Keystone Jack.png]
      
      <br>
      <a href="https://www.amazon.com/dp/B0CLV27V79">Product Link (Amazon)</a>
      <br>
    </td>
  </tr>
</table>

### Battery maintenance

<table>
<tr>
<td width="33%" align="center">
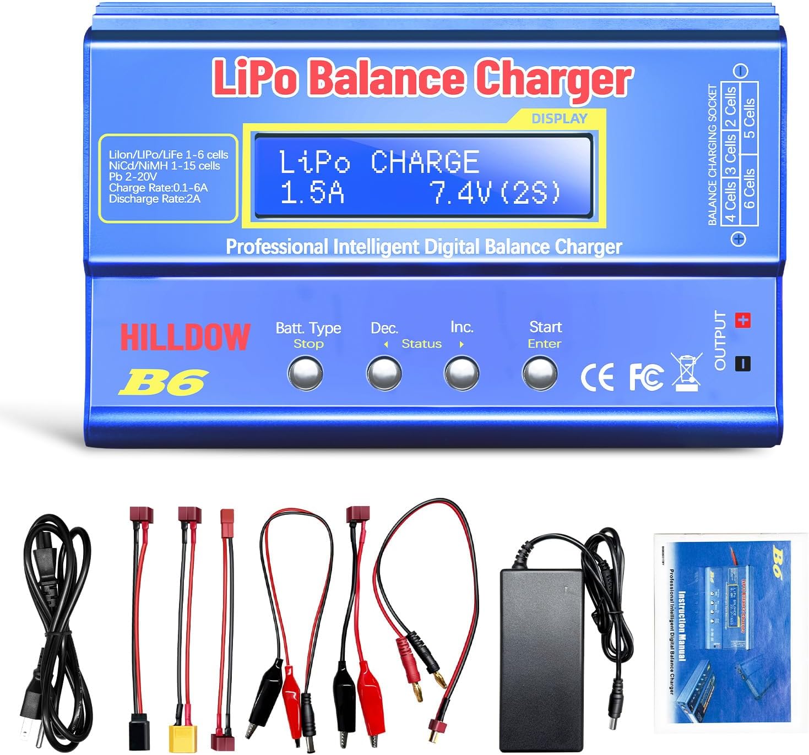
[picture p47: images/LiPo balance charger.jpg]

<br>
<b>LiPo balance charger / discharger</b>
<br>
<a href="https://www.amazon.com/dp/B0GSKJYK1B">Product Link</a>
</td>
</tr>
</table>

**FHL-LD19 LIDAR** - replaced the belt-driven YDLIDAR X2.  See Manual
Chapter 7 for the udev symlink rule, the ldlidar_ros2 driver build fix
(pthread include), and the SLAM Toolbox tuning that goes with it.

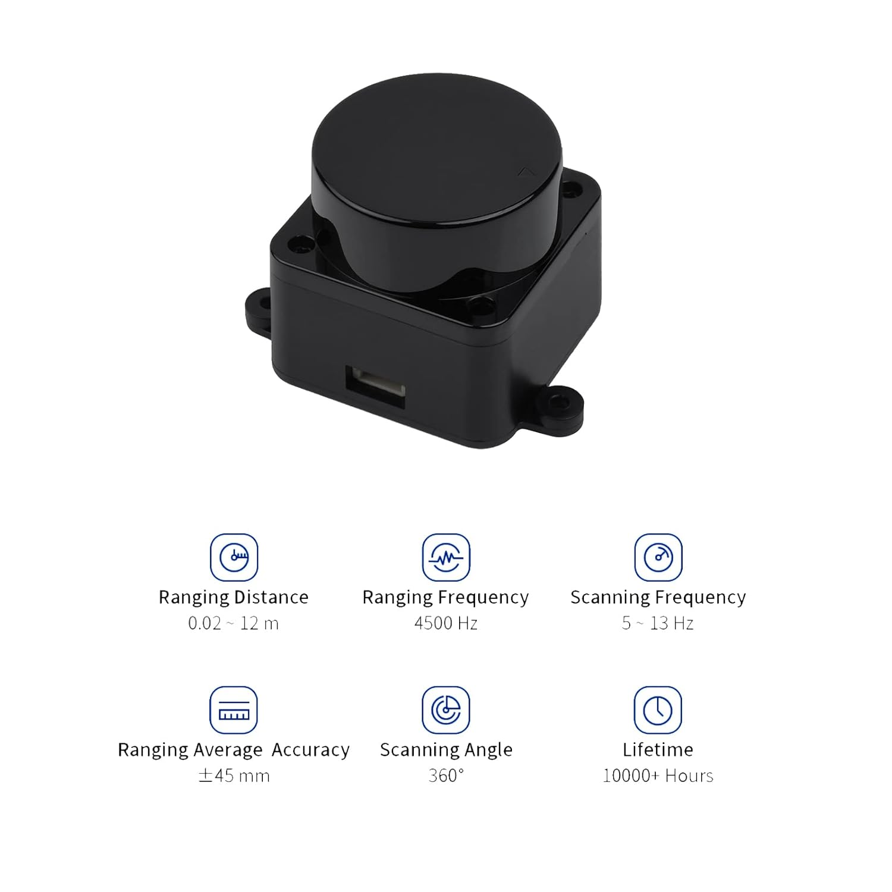
[picture p48: images/FHL-LD19 Lidar youyeetoo.jpg]


Amazon: https://www.amazon.com/dp/B0B1QCV4XR

Youyeetoo direct: https://www.youyeetoo.com

## IMU

Adafruit BNO085 breakout, mounted at base_link, wired to the Pi's
I2C bus 1 at address 0x4A.  Uses game-rotation-vector mode
(magnetometer disabled) for indoor stability.  See Manual Chapter 6
for the driver, EKF integration, and verification recipes.

<table>
<tr>
<td width="33%" align="center">
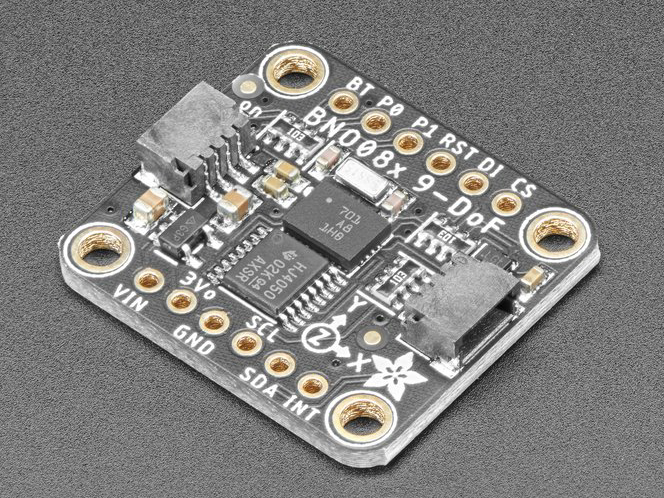
[picture p49: images/BNO085 Adafruit breakout.png]

<br>
<b>BNO085 STEMMA QT breakout</b>
<br>
<a href="https://www.adafruit.com/product/4754">Product Link (Adafruit)</a>
</td>
<td width="33%" align="center">
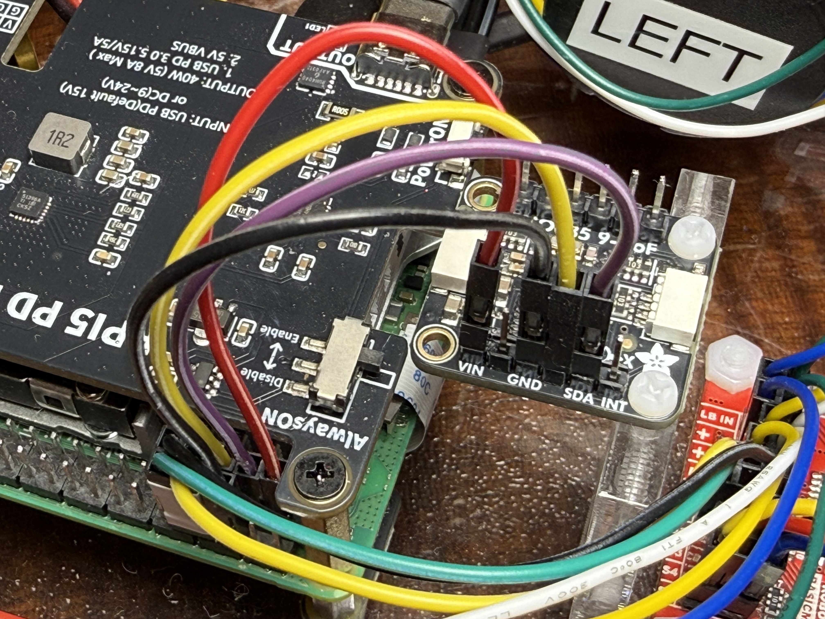
[picture p50: images/BNO085 wiring.jpg]

<br>
<b>Wiring</b>
<br>
<i>Pi pin 3 SDA (blue), pin 5 SCL (yellow), pin 4 3V3 (red), pin 6 GND (black).  If i2cdetect shows nothing, try swapping SDA / SCL - some breakouts' silk-screens are reversed.</i>
</td>
<td width="33%" align="center">
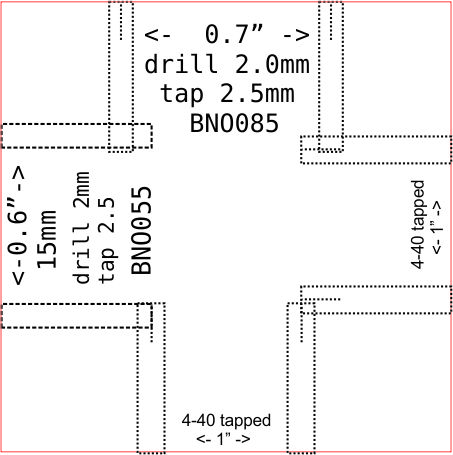
[picture p51: images/IMU mount.jpg]

<br>
<b>IMU mount</b>
<br>
<i>1/4" cast acrylic sheet, laser-cut to size with markers and text laser-etched, edges drill-pressed and hand-tapped.  Front (+x) edge of the breakout attached with M2.5 nylon screws.  Mount fastened to the bottom plate with nylon thumbscrews to place the IMU at base_link.</i>
</td>
</tr>
</table>

## Camera

Currently installed on Stormy: **OAK-D**.  The fisheye and Intel
RealSense D455 shown below are historical alternates evaluated during
development and left in this README for reference.

<table>
<tr>
<td width="33%" align="center">
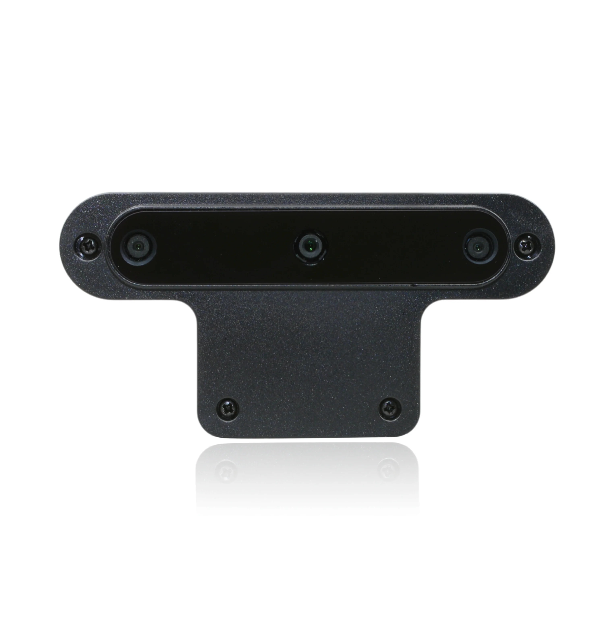
[picture p52: images/OAK-D.jpg]

<br>
OAK-D (currently installed)
<br>
<a href="https://shop.luxonis.com/products/oak-d">Product Link</a>
</td>
<td width="33%" align="center">
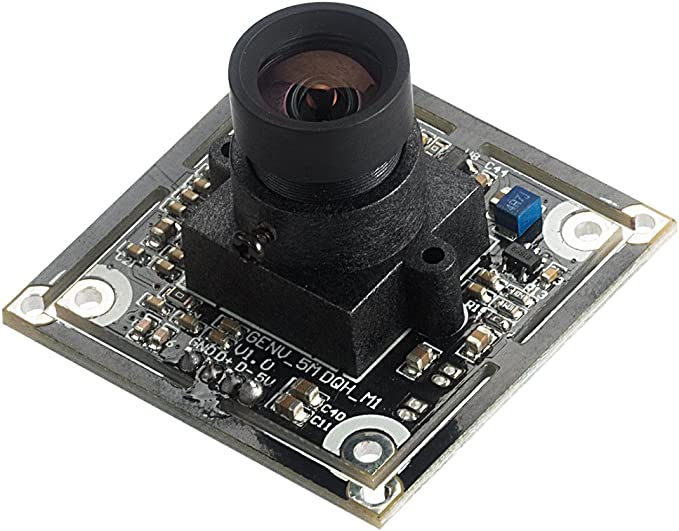
[picture p53: images/Spinel USB WDR 5MP camera.jpg]

<br>
Fisheye camera (historical alternate)
<br>
<a href="https://www.spinelelectronics.com/product/uc50mpb/">Product Link</a>
</td>
<td width="33%" align="center">
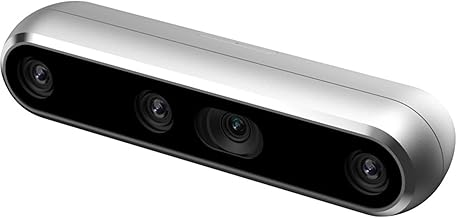
[picture p54: images/Intel_RealSense_D455_Amazon.jpg]

<br>
Intel RealSense 455 (historical alternate)
<br>
<a href="https://www.amazon.com/dp/B08KJCRCGG">Product Link</a>
</td>
</tr>
</table>

### OAK-D mount — flat (a 25° tilt wedge was tried, then removed)

The OAK-D is bolted **flat** to the chassis front plate.  Before settling
on that, a 3D-printed 25° tilt wedge was built and tested: the idea was to
lift the lower edge of the stereo-depth vertical FOV off the floor (wedge
angle = ½ the ~50° depth V-FOV) to cut ground clutter.  It cut the clutter
but over-tilted the camera — the RGB stream's bottom edge ended up ~14°
*above* horizontal, so the camera could no longer see the near floor,
losing the low obstacles and floor landmarks the depth camera was added to
catch.

The flat mount turned out to already be the sweet spot.  The OAK-D depth
can't range closer than ~0.20 m, and with the 50° depth V-FOV its bottom
edge sits 25° below the (now level) optical axis; 0.20·sin 25° ≈ 8.5 cm of
drop ≈ the 9 cm lens height, so the floor falls right at the camera's
minimum range with no wedge at all.  The wedge was removed from the robot
and from the URDF on 2026-11-01.

<table>
<tr>
<td width="50%" align="center">
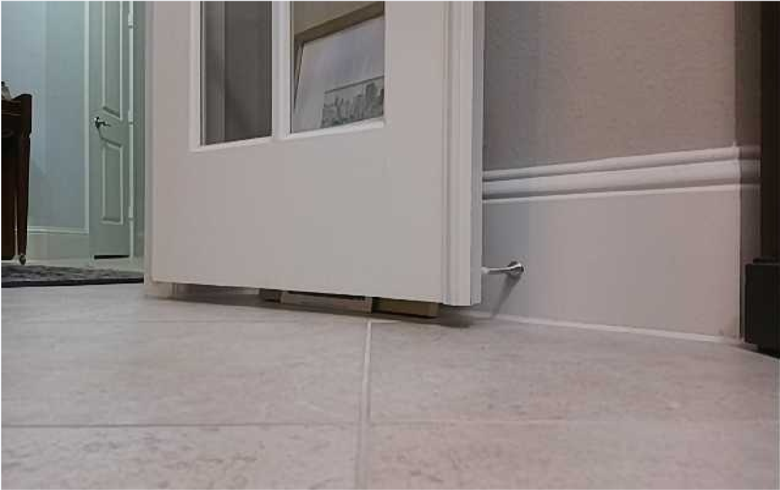
[picture p55: images/OAK-D view from dock straight.png]

<br>
Floor view from the dock — OAK-D flat (final mount)
</td>
<td width="50%" align="center">
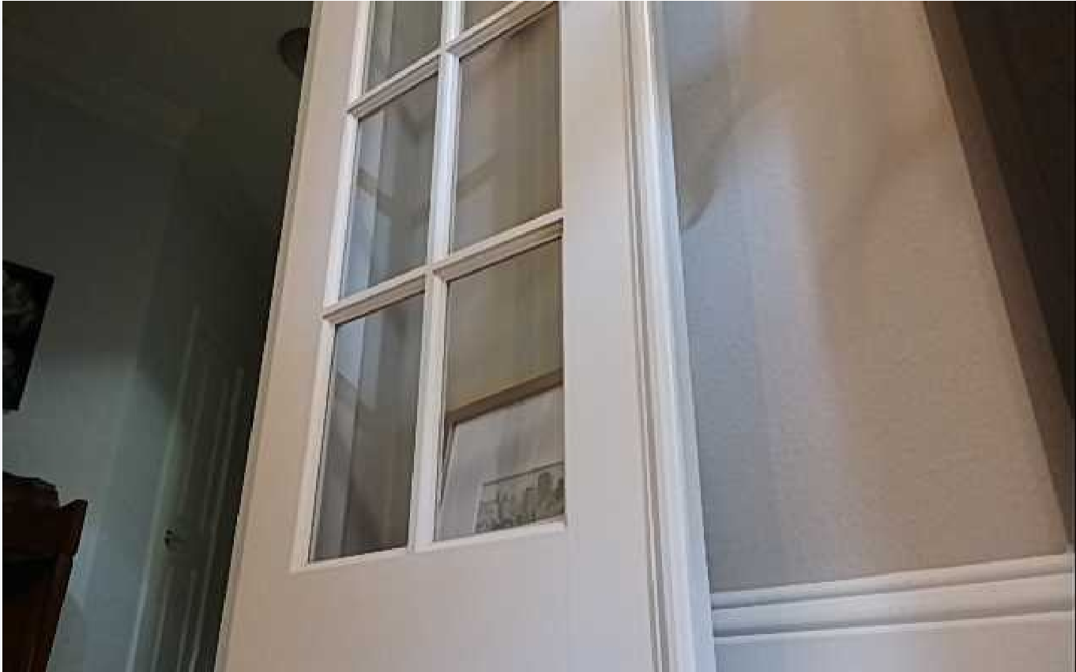
[picture p56: images/OAK-D view from dock wedged.png]

<br>
Floor view from the dock — OAK-D on the 25° wedge (abandoned)
</td>
</tr>
</table>

## Indicators

Headlights, amber-LED beacon, and USB-audio speaker for WAV alerts,
all driven from Pi GPIO through a custom PCB.  See Manual Chapter 16
for the ROS 2 node behaviour, joystick button mapping, and Nav2
alert logic.

### Parts

<table>
<tr>
<td width="50%" align="center">
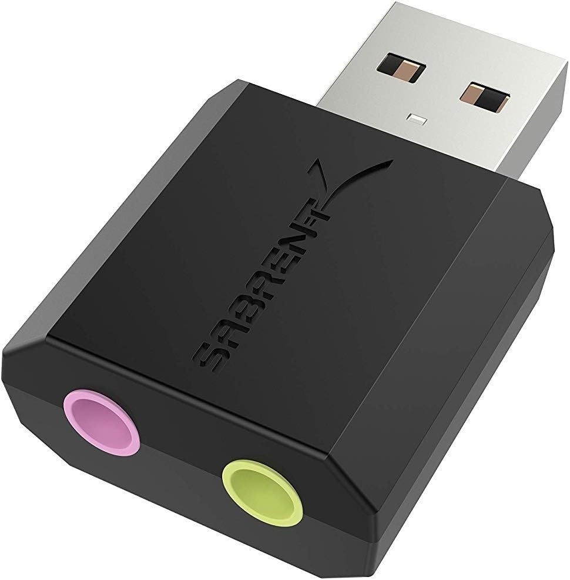
[picture p57: images/USB Audio Adapter Sabrent.png]

<br>
<b>Sabrent USB audio DAC</b>
<br>
<a href="https://www.amazon.com/dp/B00IRVQ0F8">Product Link</a>
</td>
<td width="50%" align="center">
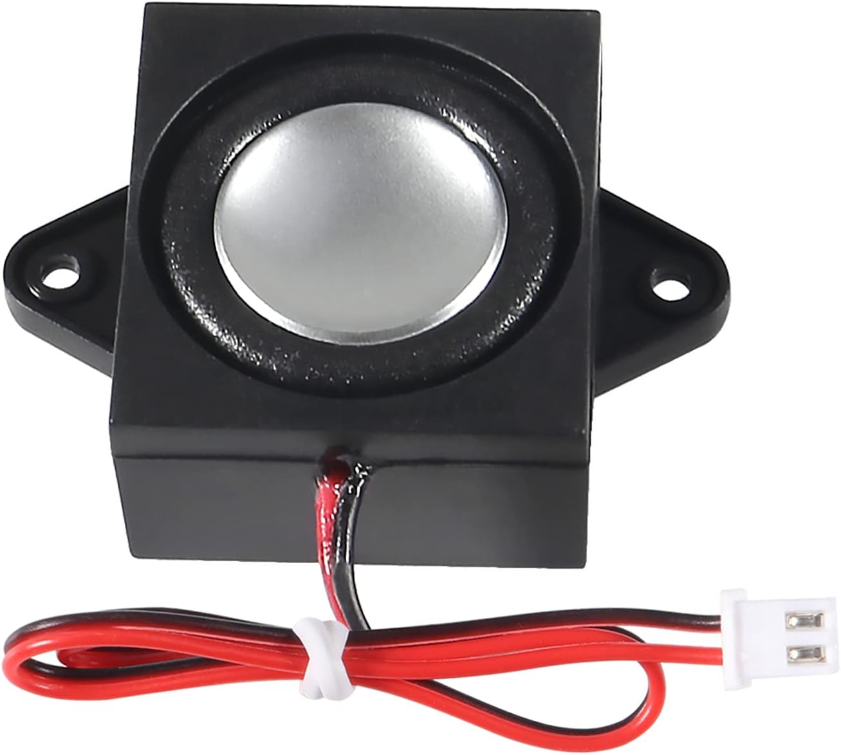
[picture p58: images/Speaker mini 8ohm.png]

<br>
<b>Mini 8-ohm speaker (4-pack)</b>
<br>
<a href="https://www.amazon.com/dp/B0B4D1BN4F">Product Link</a>
</td>
</tr>
<tr>
<td width="50%" align="center">
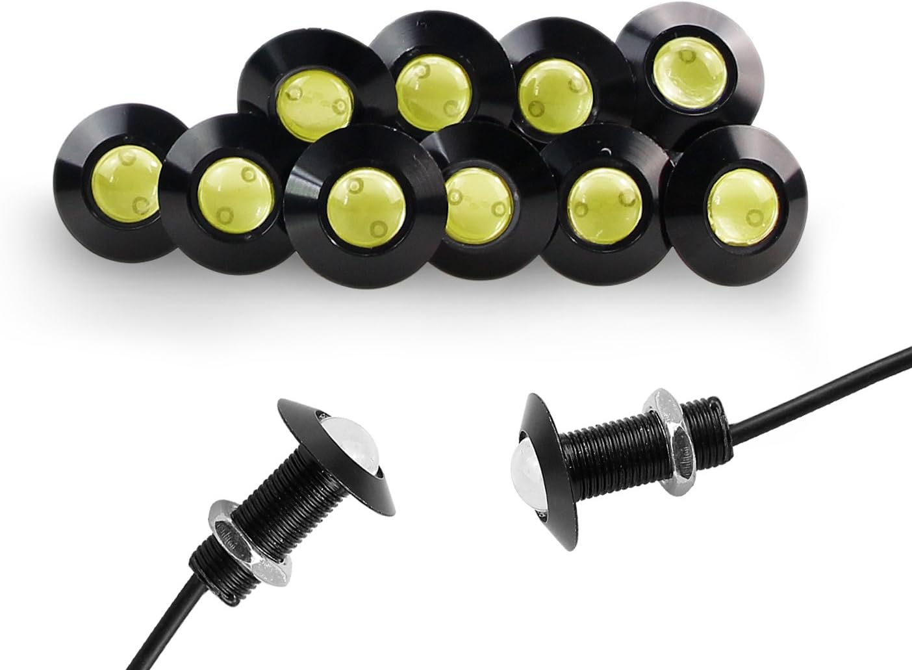
[picture p59: images/Carlits LED Headlight.jpg]

<br>
<b>Headlights</b>
<br>
<i>Eagle-Eye style, 9W 12V, 12mm - sold in 10-packs.  Two used on Stormy.</i>
<br>
<a href="https://www.amazon.com/dp/B06ZYKWQZC">Product Link</a>
</td>
<td width="50%" align="center">
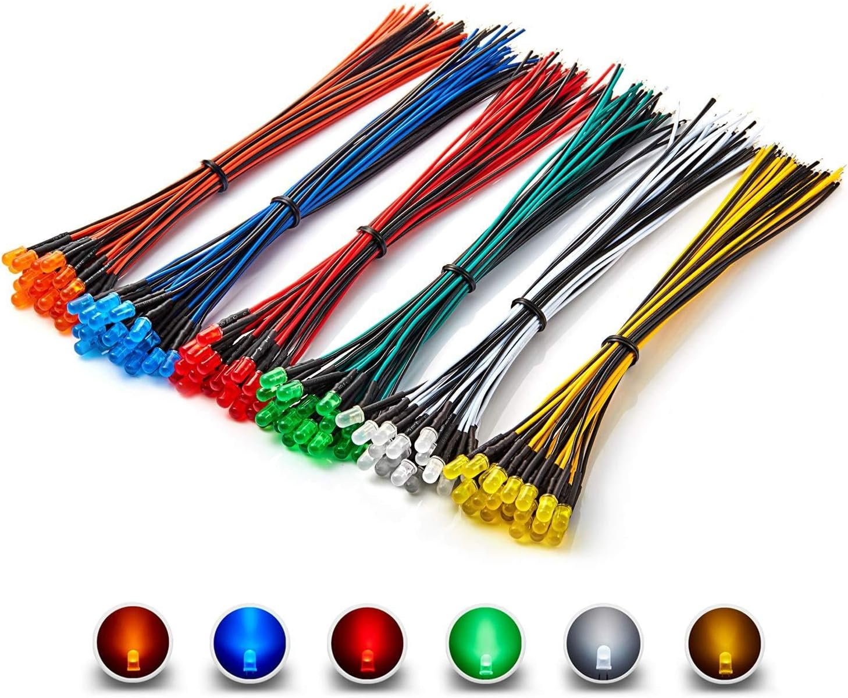
[picture p60: images/LEDs Multicolor CHANZON.png]

<br>
<b>CHANZON multicolor 5&nbsp;mm LED assortment</b>
<br>
<a href="https://www.amazon.com/dp/B08G4XCQSW">Product Link</a>
</td>
</tr>
</table>

*TODO: add remaining indicators BoM items with photos and links:
IRLZ44N MOSFET (Amazon B0CBKH4XGL), and the custom JLCPCB PCB
fabrication.*

### Design journey

The entire fiasco need not have happened had I known then what I know now.
A pair of off-the-shelf Dual MOSFET switched replaced the whole thing.

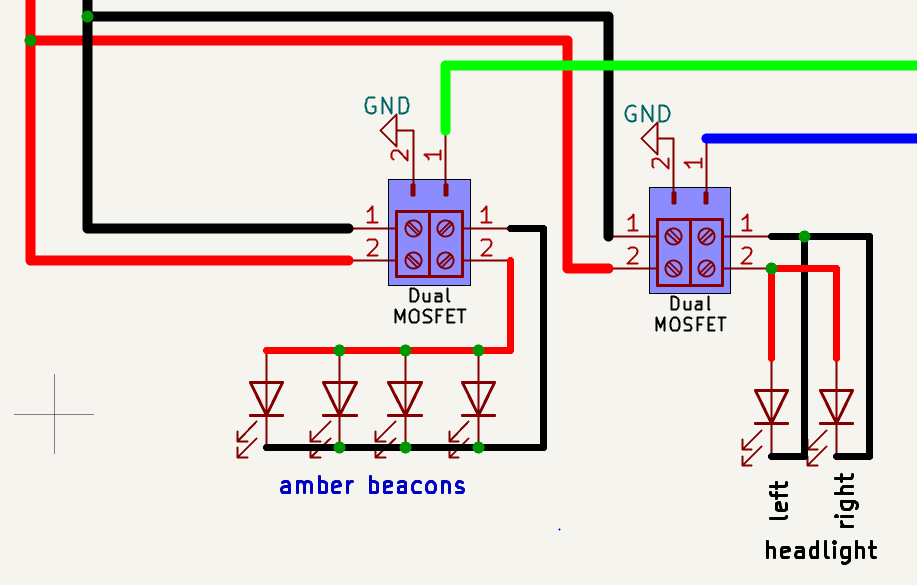
[picture p61: images/Dual MOSFET Switches.png]


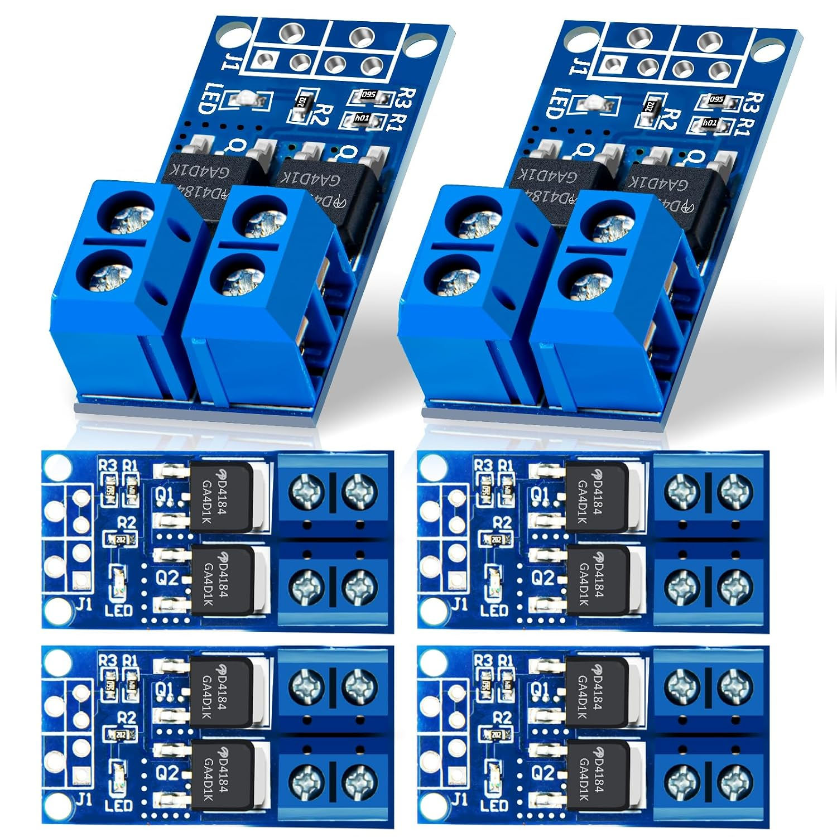
[picture p62: images/MOSFET Dual High Power.png]


<a href="https://www.amazon.com/High-Power-Adjustment-Electronic-Controller-Brightness/dp/B0FMJH3DML/">6 PCS Dual High-Power MOSFET Trigger Switch Drive Module</a>

The prior PCB was Rev 3 - two IRLZ44N logic-level MOSFETs driven
directly from Pi GPIO, no NPN inverter stage.  Two earlier revisions
and a Flux.ai adventure preceded it.

**Original schematic** (before the piezo beeper was dropped).  Both
amber-LED lines are on the same GPIO circuit; the second line is
unused on the current PCB.

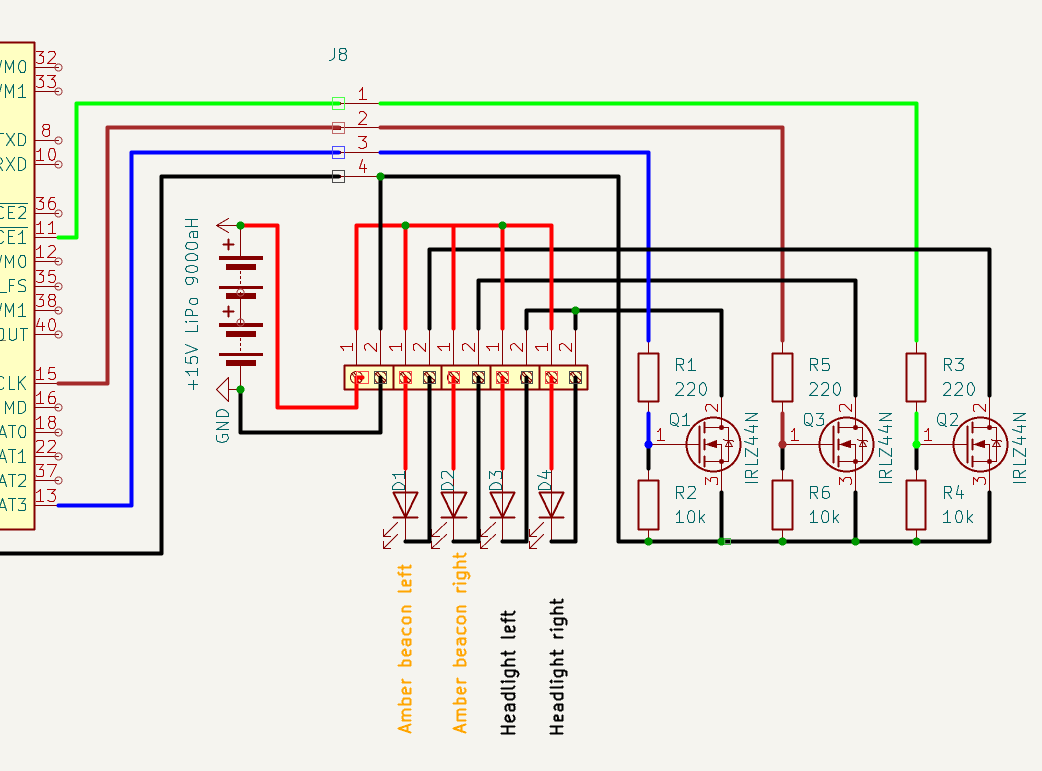
[picture p63: images/indicators schematic pre-beeper-drop.png]


**Unsuccessful protoboard attempt.**



**Flux.ai PCB layout.**

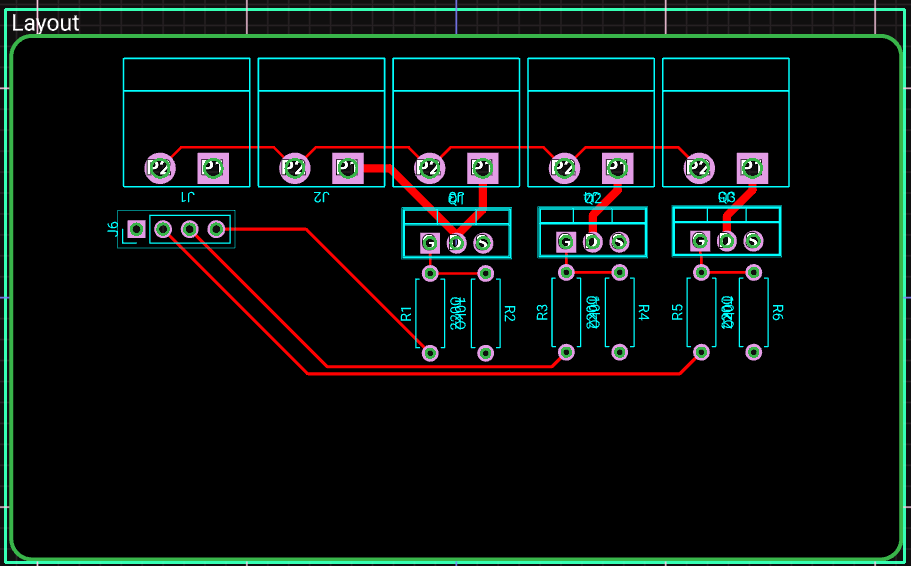
[picture p64: images/indicators PCB layout.png]


**Completed PCB** (JLCPCB).



**Populated PCB installed inside the upper plate** (view from below).



**Indicators in action:** headlights on, amber LEDs illuminated,
speaker between the LiDAR supports (later moved to the rear caster
bracket).



**Lesson learned.**  I spent way too much time and money nudging
Flux.ai as it obsessed and dithered over a simple circuit.  Would
have been better off designing by hand or with one of the free online
tools from the PCB makers (EasyEDA at JLCPCB, KiCad).  A second
protoboard attempt would likely have succeeded.

## Networking

<table>
<tr>
<td width="33%" align="center">
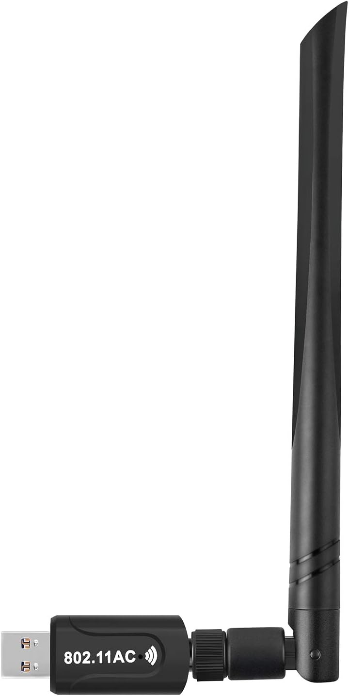
[picture p65: images/USB WiFi antenna.png]

<br>
<b>USB WiFi dongle - Realtek RTL8812BU with 5 dBi antenna</b>
<br>
<i>Stormy uses this dongle in preference to the Pi 5's internal wlan0, which is broken by design at 2.4 GHz.  See Manual Chapter 9.</i>
<br>
<a href="https://www.amazon.com/dp/B078NSSM7W">Product Link</a>
</td>
<td width="33%" align="center">
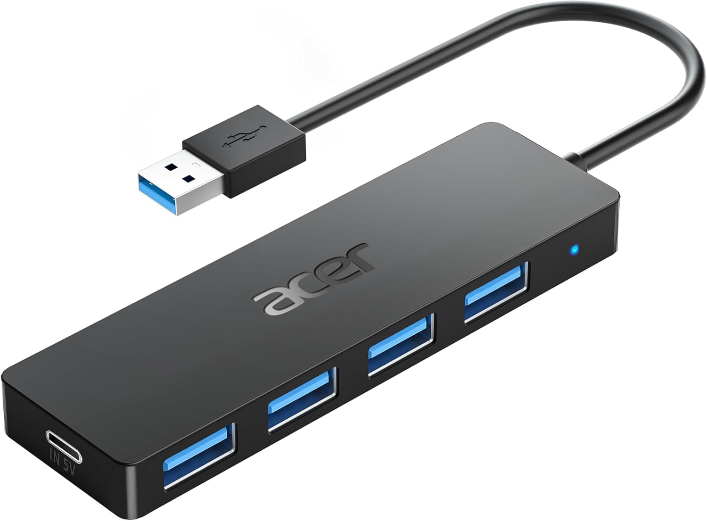
[picture p66: images/Acer USB hub.jpg]

<br>
<b>Powered USB 3.0 hub, 4-port (Acer)</b>
<br>
<i>Feeds the USB WiFi dongle, LD19 LiDAR, USB audio DAC, and drydock keyboard/mouse.  Power-capable but currently running bus-powered from the Pi; powering it from the LiPo bus is an open question.  See Manual &sect;3.1.</i>
<br>
<a href="https://www.amazon.com/dp/B0CPSSD43L">Product Link</a>
</td>
</tr>
</table>

## Accessories and tools

_A running list of the smaller parts and the tools that shape them.
Everything here is used in the current build; sources and photos are
being filled in over time._

### Connectors

- **PowerPole housings + contacts** (Anderson Powerpole, sold by
  Powerwerx) - main bus, battery, and subsystem connections
  throughout the robot.
  <br><a href="https://powerwerx.com/150-piece-anderson-powerpole-connector-case">Product Link (150-piece assortment case)</a>
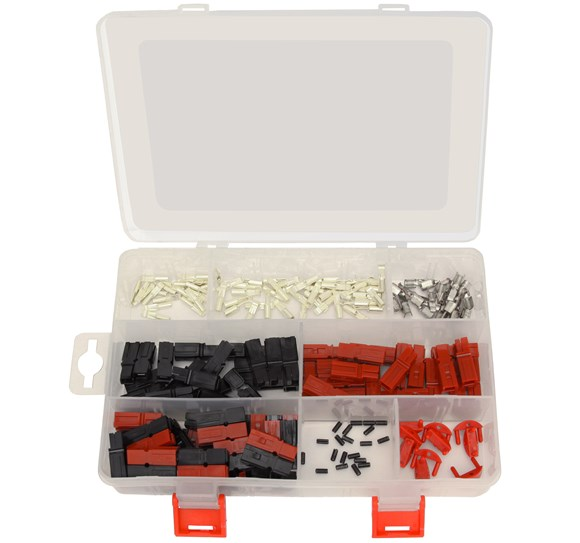
[picture p67: images/Powerpole connector assortment.png]
  <br>
- **PowerPole crimper** (Powerwerx TriCrimp - MUST BUY, no
  substitutes).
  <br><a href="https://powerwerx.com/tricrimp-powerpole-connector-crimping-tool">Product Link (TriCrimp)</a>
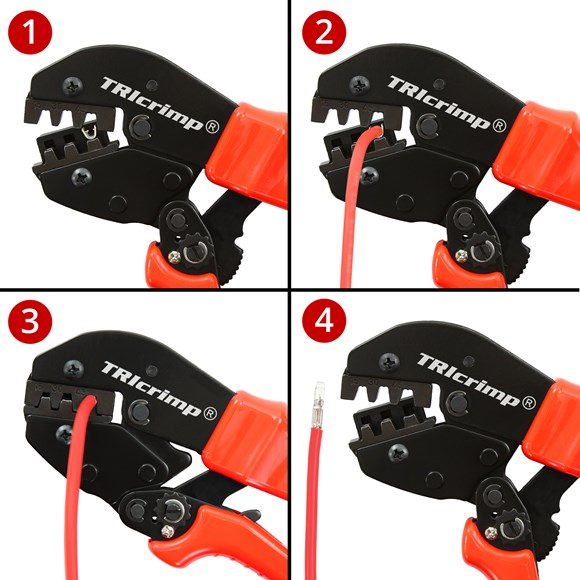
[picture p68: images/powerpole-crimping-tool.png]
  <br>
- **PowerPole insertion / removal / extraction tool** - very useful
  for reworking existing bundles without cutting them apart.
  <br><a href="https://powerwerx.com/powerpole-insertion-removal-extraction-tool">Product Link</a>
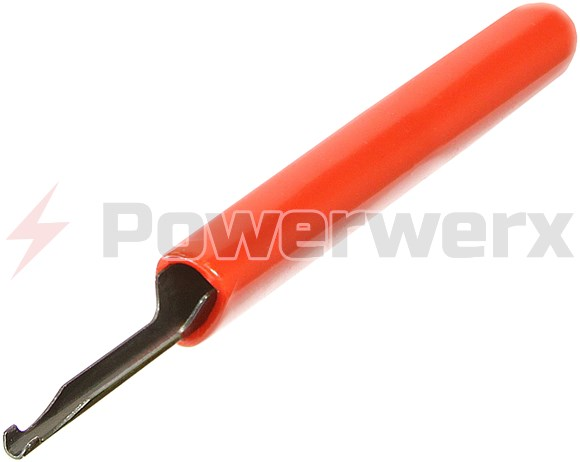
[picture p69: images/powerwerx-powerpole-insertion-removal-extraction-tool.png]
  <br>
- **LiPo battery connectors, EC5 male / female** - battery-side
  plug pair.  The Zeee LiPo ships with EC5 pigtails; a matching pair
  on the bus side lets the battery come off cleanly for balance
  charging.
  <br><a href="https://www.amazon.com/dp/B08M3WND19">Product Link</a>
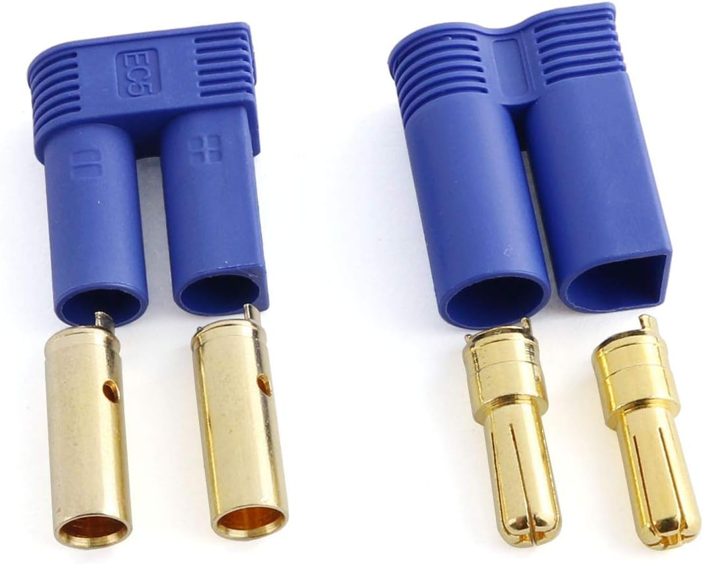
[picture p70: images/EC5 Battery Connectors.png]
  <br>
- **Ferrule crimper + assorted-color ferrule kit** -
  <a href="https://www.amazon.com/dp/B0G1TSPZ93">Product Link</a>
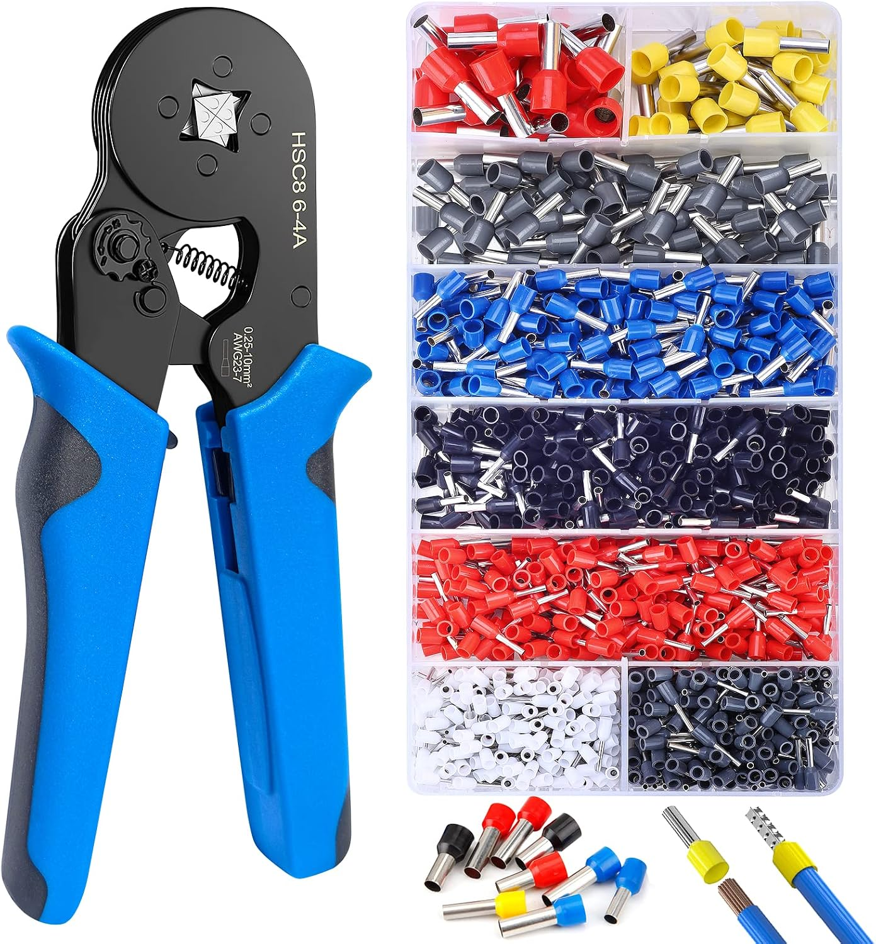
[picture p71: images/Ferrule crimping kit.png]
  <br>
- **DuPont jumper connectors + crimper** (0.1" pitch) - GPIO
  connections to RoboClaw, BNO085 IMU, Indicators PCB.
  <br><a href="https://www.amazon.com/dp/B0B11RLGDZ">Product Link (Taiss ratcheting crimper + connector kit)</a>
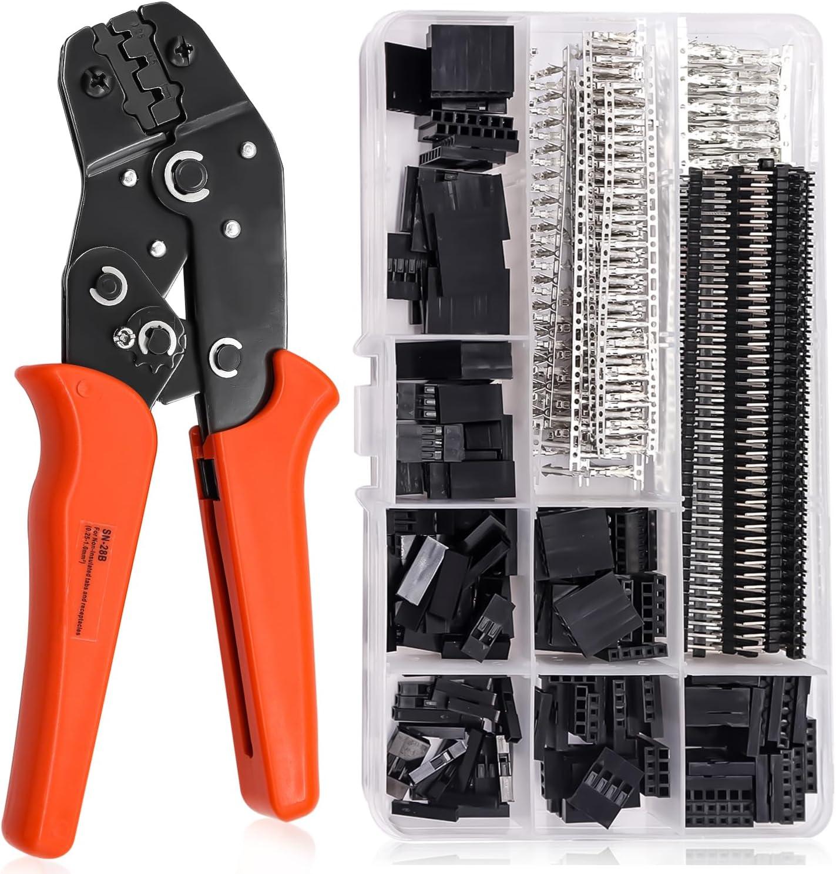
[picture p72: images/DuPont Connector Kit.png]
  <br>
- **Spade connectors, 22-10 AWG assortment + crimper** - fuse
  holder, DPDT switch, and legacy pigtails.
  <br><a href="https://www.amazon.com/dp/B0CNRP9MT6">Product Link (Twidec insulated spade assortment)</a>
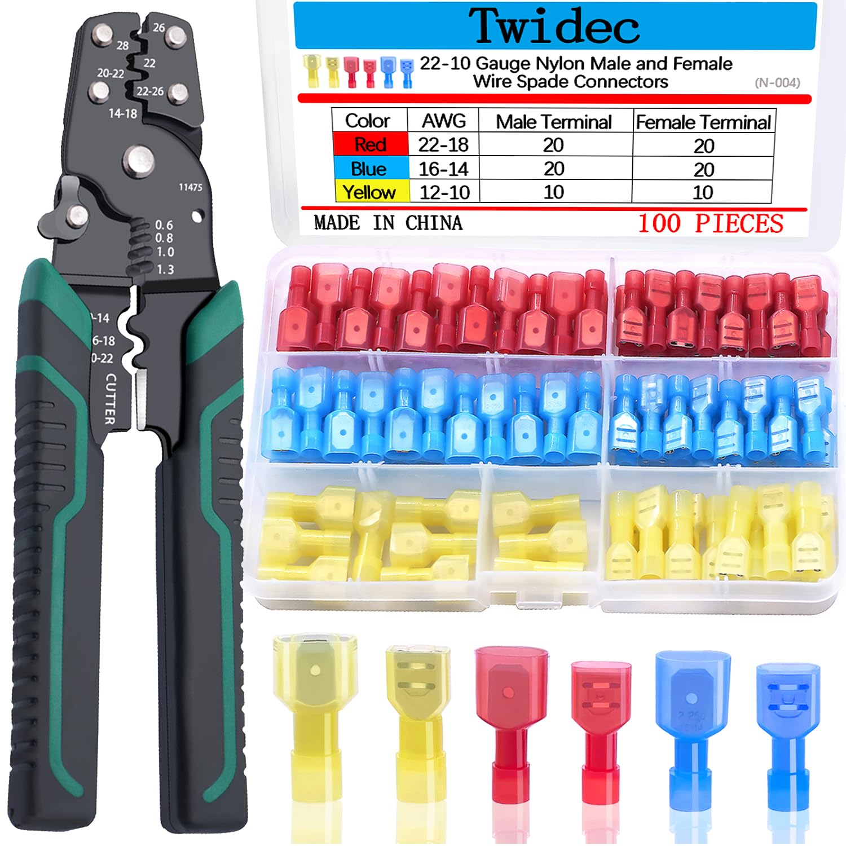
[picture p73: images/Spade Terminals and Crimper.png]
  <br>
- **DC power plugs** - inline barrel plug pigtails for:
    - the LiPo bus &rarr; 52Pi PD board 12-24V input
    - 52Pi 5V output &rarr; OAK-D aux power feed
  <br><a href="https://www.amazon.com/dp/B01G6EB99E">Product Link</a>
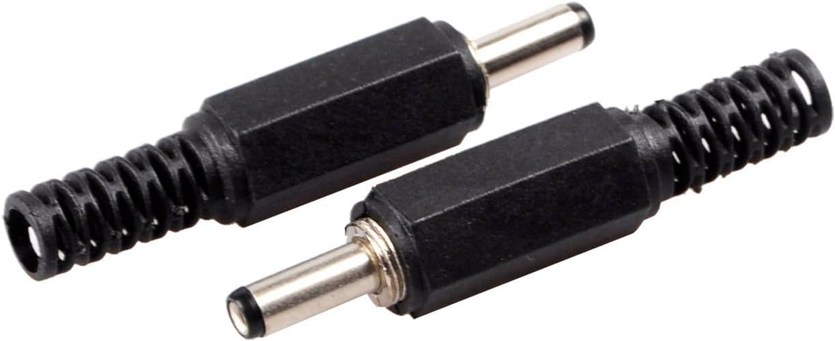
[picture p74: images/power plug.png]
  <br>

### Wire

- **Silicone parallel wire, assorted gauges** - multiple sizes used
  across the build.
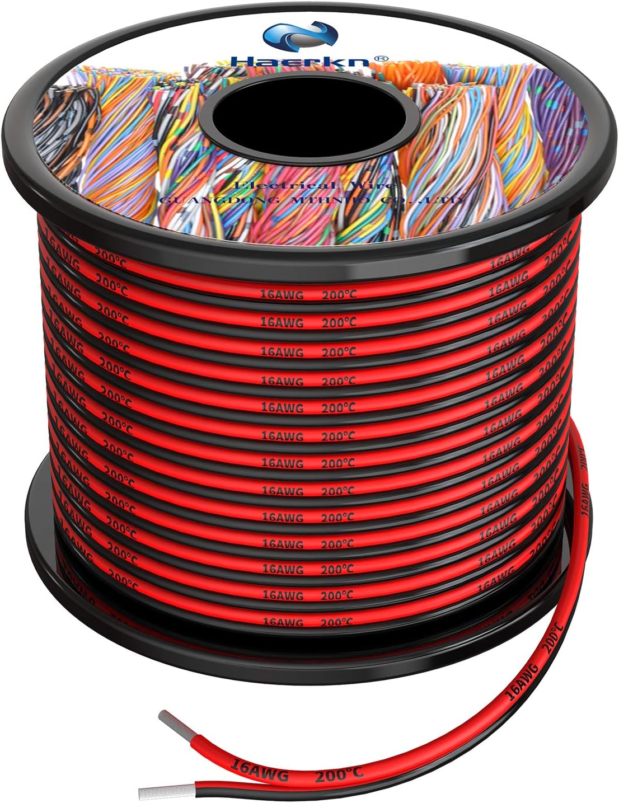
[picture p75: images/16AWG silicone power wire.jpg]
  <br>
  <br>Representative sources (2-conductor silicone parallel):
  <br><a href="https://www.amazon.com/dp/B07RSRBZZD">14 AWG</a>
  <br><a href="https://www.amazon.com/dp/B07FMLVF84">16 AWG</a>
  <br><a href="https://www.amazon.com/dp/B07RVMHSK4">18 AWG</a>
  <br><a href="https://www.amazon.com/dp/B07K9JKXM9">20 AWG</a>

### Fasteners

- **M2.5 x 18mm + 6mm brass hex standoffs, male-female** - stack the
  52Pi PD power extension board above the Pi 5.  Use included shorter
  standoffs for clearance for the PCIe HAT below.
  <br><a href="https://www.amazon.com/dp/B0FP2QGTD4">Product Link</a>
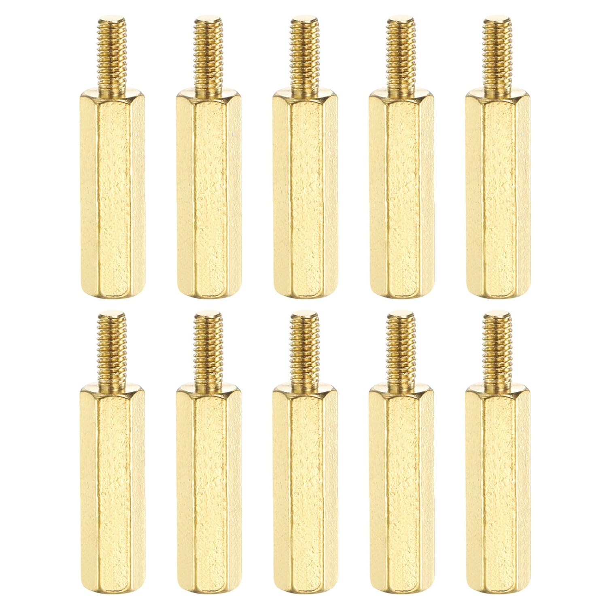
[picture p76: images/standoffs male female M2.5 18mm.jpg]
  <br>
- **Nylon standoffs, 1.5" x 1/4" round, female-female, 4-40** -
  LiDAR triangle mount on the top plate (see Manual Chapter 7.1).
  <br><a href="https://www.mcmaster.com/products/nylon-spacers/standoffs-2~/standoffs-2~shape~hex/thread-size~4-40/length~1-500/length~1-1-2/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">Product Link (McMaster-Carr)</a>
  <br>
- **Nylon thumbscrews** - tool-free access panels.
  <br><a href="https://www.digikey.com/en/products/detail/essentra-components/090440037T/10243363">Product Link (DigiKey / Essentra 090440037T)</a>
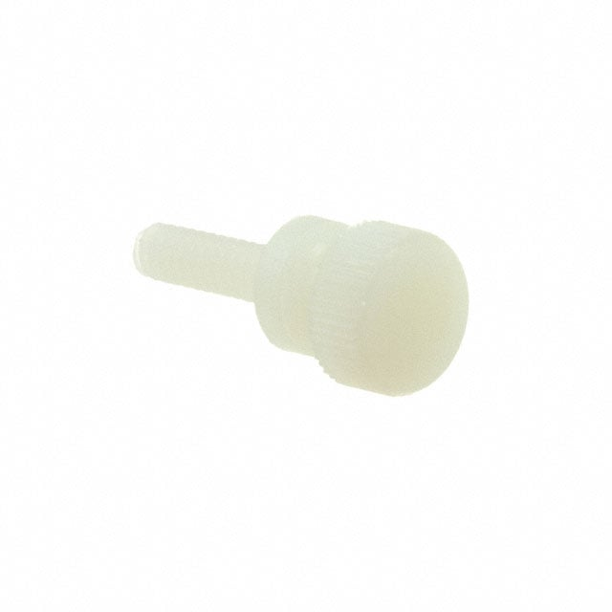
[picture p77: images/Thumbscrew nylon.png]
  <br>
- **Drill bits and taps, assorted metric and imperial** - for the
  top plate LiDAR mounts, indicator PCB mounting, and any hole that
  needs threads.  Stormy uses both metric (M2.5, M3) and SAE (4-40)
  threads, so you need both tap families on the bench.
  <br><a href="https://www.amazon.com/dp/B0CX87WR49">uxcell titanium tapping / threading kit (metric)</a>
  <br><a href="https://www.amazon.com/dp/B0G845TP6Y">Century Drill &amp; Tool 13-piece tap set</a>
  <br><a href="https://www.lowes.com/pd/IRWIN-All-Purpose-SAE-13-Pack-Tap-and-Drill-Set/1003019164">IRWIN Hanson 13-pack SAE tap &amp; drill set (Lowes)</a>
  <br>
  <table>
  <tr>
  <td width="50%" align="center">
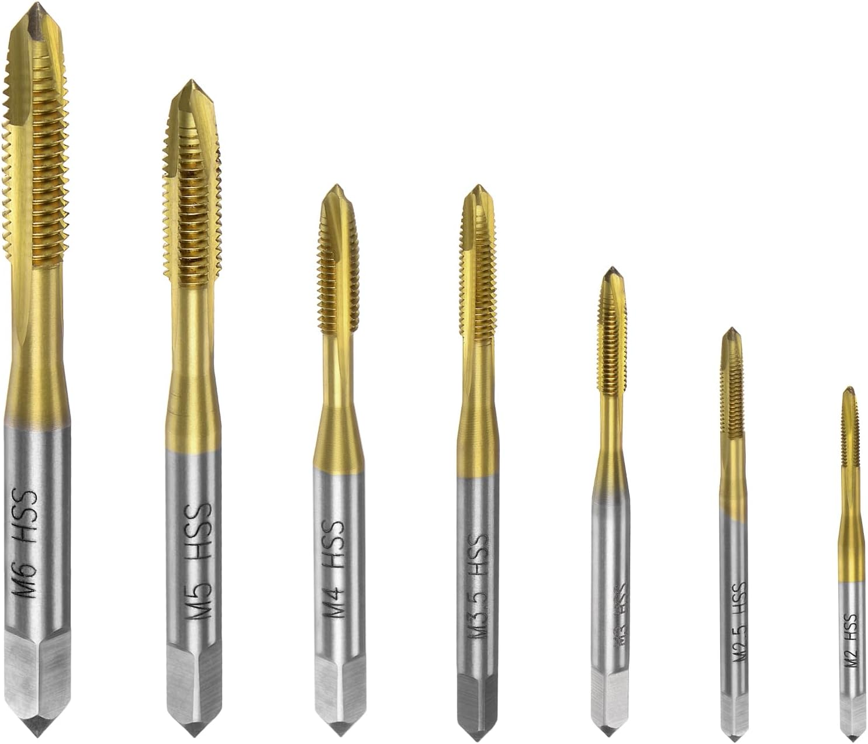
[picture p78: images/Taps metric.png]
  
  <br>Metric taps
  </td>
  <td width="50%" align="center">
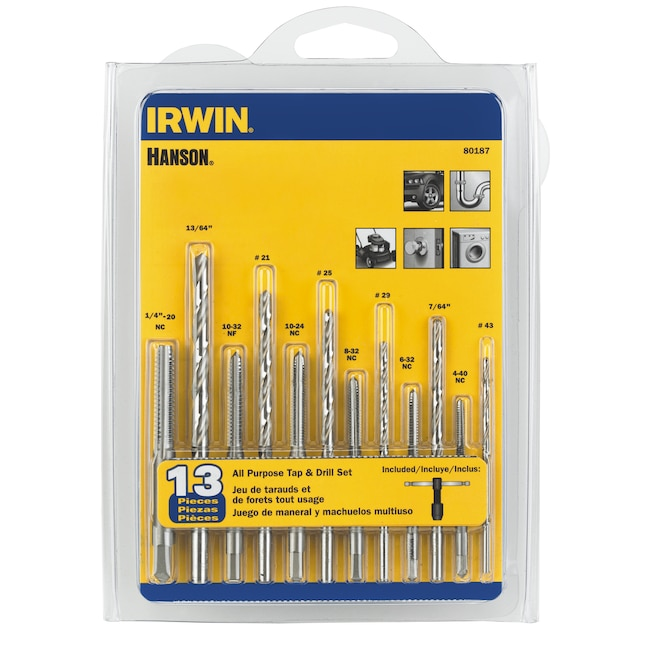
[picture p79: images/Tap and drill SAE Irwin.png]
  
  <br>SAE taps &amp; drill bits
  </td>
  </tr>
  </table>
- **Snap-ring pliers** - the drive wheels are retained on the T81
  hex hub adapters by snap rings.  Without proper pliers this is
  nearly impossible and outright dangerous - a slipping snap ring
  can fly at high speed.  **Wear safety glasses.**  This inexpensive
  set is adequate.
  <br><a href="https://www.amazon.com/dp/B09LVCV93Q">Product Link</a>
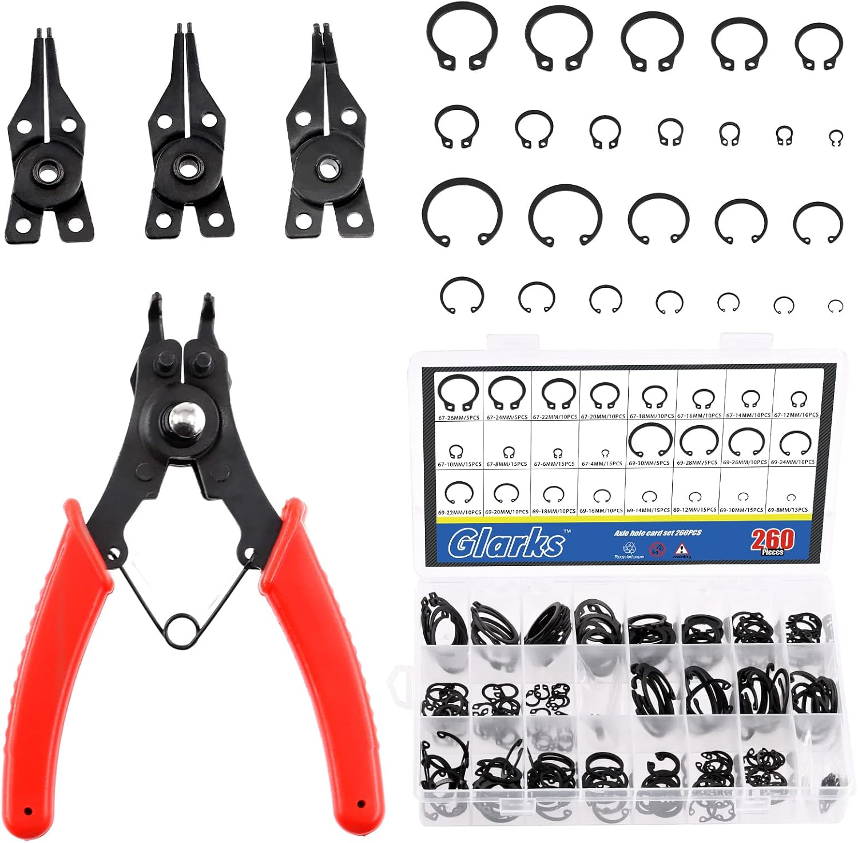
[picture p80: images/snap ring pliers.png]
  <br>

### Mounting adhesives and straps

- **Foam tape** - mounts the fuse-holder proto-board to the rear side
  panel; general-purpose vibration-damped mounting.
  <br><a href="https://www.amazon.com/dp/B007Y7ITMS">Product Link</a>
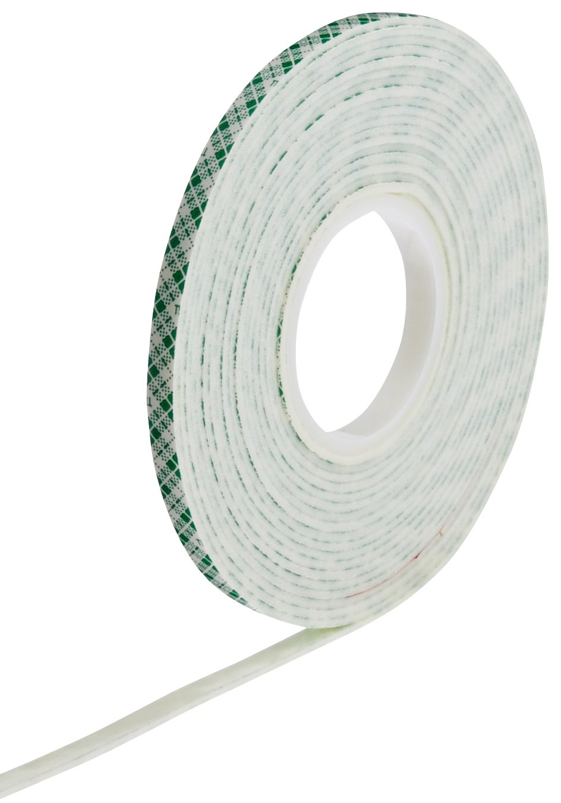
[picture p81: images/foam tape.png]
  <br>
- **Velcro straps** - battery hold-down and cable management.
  <br><a href="https://www.amazon.com/dp/B071DGMNMX">Product Link</a>
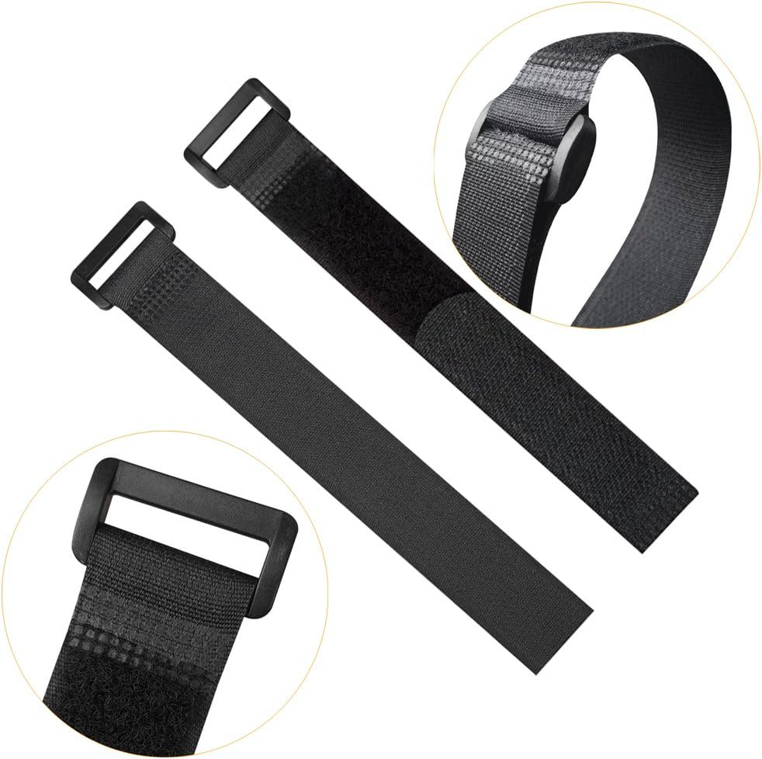
[picture p82: images/velcro straps.jpg]
  <br>
- **Velcro fasteners** (adhesive-back hook-and-loop mounting squares)
  - reversible mounting for mini speaker, LIDAR USB adapter, LiPo
  screamer.
  <br><a href="https://www.amazon.com/dp/B09S163TNK">Product Link</a>
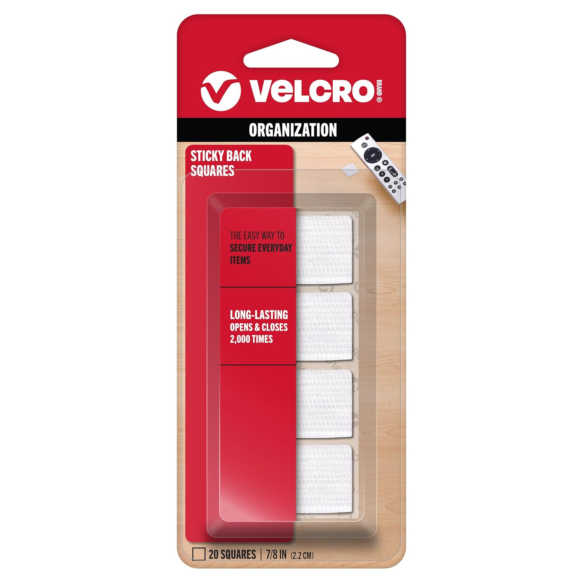
[picture p83: images/Velcro mounting squares.png]
  <br>

### Labeling

- **Heat-shrink tubing, assorted sizes** - insulation, strain
  relief, polarity, or identification on connections.
  <br><a href="https://www.amazon.com/dp/B00VDVT7IG">Product Link (Swordfish 61190 assorted-color heat-shrink kit)</a>
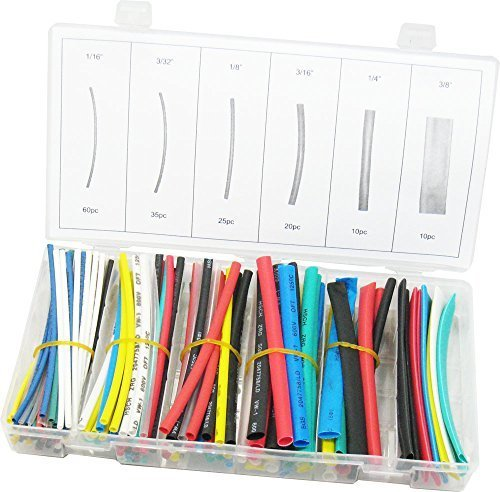
[picture p84: images/heat shrink assortment.png]
  <br>
- **Heat gun** (with reflector nozzle) - shrinks the tubing above and
  the DYMO label tubing below.  The reflector nozzle protects nearby
  wires from the direct blast.
  <br><a href="https://www.amazon.com/dp/B08VFY8THD">Product Link (SEEKONE 350W mini, 2 temp settings)</a>
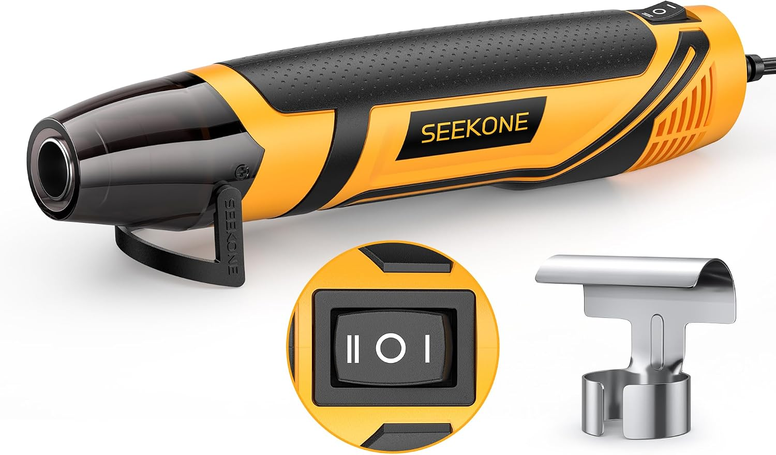
[picture p85: images/heat gun.png]
  <br>
- **Heat-shrink label maker + label tubing** - wire and connector
  identification.  Compatible heat-shrink label tubing is available
  through the DYMO ecosystem linked below.
  <br><a href="https://www.amazon.com/dp/B005MR516Y">DYMO Industrial label maker</a>
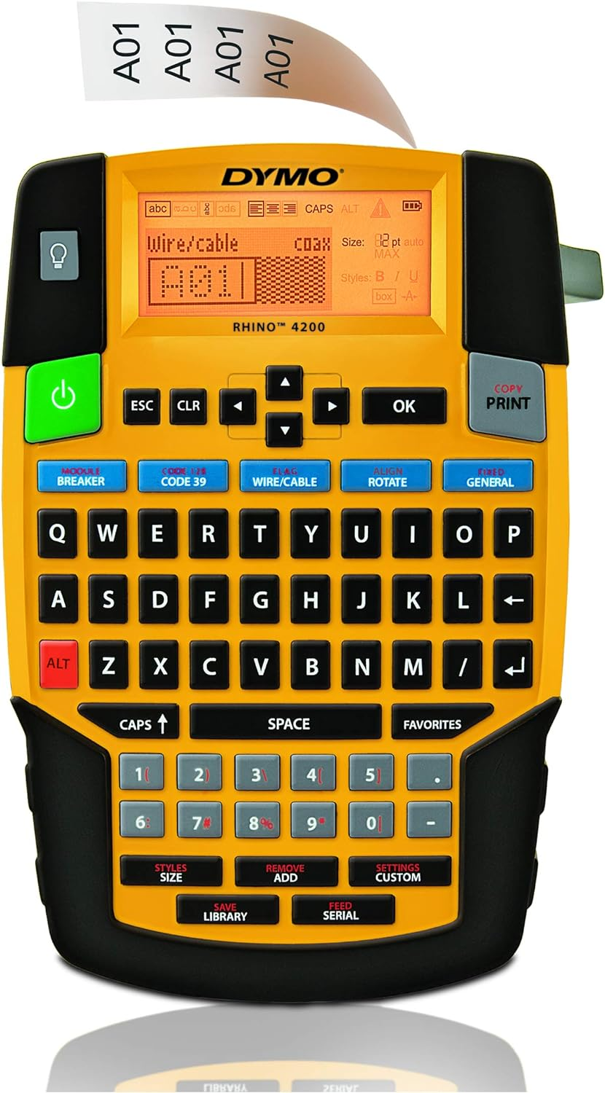
[picture p86: images/DYMO heat shrink tubing label maker.png]
  <br>

_*TODO*: add anything else that belongs on this list - if you buy it,
reach for it, or crimp with it while working on Stormy, add it here._

---

## Bill of materials

Rough cost to buy every part and tool listed above from scratch, as
of **2026-08-02**: **approximately $1,890.**

### Split by type

The CSV is organized into three sections via the `Type` column, so a
reader can tell at a glance what fraction of the cost is one-time
tooling vs. actual parts on the robot:

| Type | Items | Subtotal | What it is |
|---|---:|---:|---|
| **Components** | 29 | $1,265.31 | Actual parts installed on Stormy - one of each per robot |
| **Supplies** | 17 | $256.69 | Consumables: raw acrylic stock, wire, connector assortments, fastener packs, tape, heat-shrink |
| **Tools** | 12 | $368.45 | One-time bench purchases: crimpers, tap sets, snap-ring pliers, heat gun, DYMO, LiPo balance charger |
| **Grand total** | 58 | **$1,890.45** | |

### Split by subsystem

Individual line items, unit prices, and quantities live in the
companion worksheet [`BOM_pricing_worksheet.csv`](BOM_pricing_worksheet.csv)
in this repo (sorted with Components first, Supplies second, Tools
last) - restart from that file when you reprice, and update this
table to match.

| Subsystem | Subtotal |
|---|---:|
| Structural (acrylic sheet stock) | $48.99 |
| Rear caster (aspirational - see WARNING) | $12.21 |
| Drivetrain (motors, wheels, hubs) | $140.90 |
| CPU (Pi 5, 52Pi, PCIe HAT, SSD) | $261.82 |
| Power (LiPo, e-stop, RoboClaw, shunt, indicators front-end) | $305.33 |
| Bus protection (fuse, fuse holder, Schottky) | $10.40 |
| Battery maintenance (balance charger) | $31.99 |
| LIDAR (LD19) | $71.90 |
| IMU (BNO085 breakout) | $24.95 |
| Camera (OAK-D only; historical alternates excluded) | $329.00 |
| Indicators (DAC, speaker, MOSFETs, LEDs, PCB) | $96.81 |
| Networking (USB WiFi dongle, powered USB hub) | $34.97 |
| Connectors (PowerPole, EC5, DuPont, spade, ferrule, DC plugs, tools) | $169.92 |
| Wire (14/16/18/20 AWG silicone) | $70.82 |
| Fasteners (standoffs, thumbscrews, tap/drill kits, snap-ring pliers) | $102.56 |
| Mounting (foam tape, Velcro straps, Velcro squares) | $20.60 |
| Labeling (heat-shrink, heat gun, DYMO label maker) | $157.28 |
| **Grand total (from `BOM_pricing_worksheet.csv`)** | **$1,890.45** |

Caveats:

- **Pack-size accounting.**  Prices reflect the full pack you have
  to buy even when Stormy only uses a fraction of it - the
  headlights are a 10-pack, the DPDT switches a 20-pack, and so on.
  If you build a second robot, most consumable subtotals go to zero.
- **Alternates included.**  The Fasteners rows list three
  tap-and-drill kits (uxcell, Century, IRWIN); pick one to save
  ~$44.  The Indicators PCB row assumes JLCPCB's five-board
  minimum + shipping + duty.
- **Tools vs. parts.**  Concretely:
    - If you already own the tools listed in the Tools section
      (crimpers, tap sets, heat gun, DYMO, snap-ring pliers, LiPo
      balance charger), the components + supplies come to
      **$1,522.00**.
    - If your bench is also already stocked with wire, connector
      assortments, ferrules, heat-shrink, standoff assortments,
      Velcro, tape, and cast acrylic sheet stock, the pure
      component-only cost drops to **$1,265.31**.
- **Historical camera alternates** (Spinel fisheye, Intel RealSense
  D455) are excluded from the total; Stormy runs on the OAK-D.

Prices last checked: **2026-08-02**.  Amazon prices drift; expect
double-digit-percent swings on any given item.  When repricing,
restart from the CSV, not from this table.

---

# SOFTWARE

<table>
<tr>
<td width="50%" align="center">
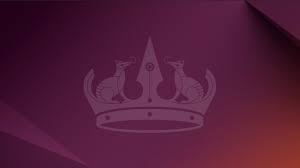
[picture p87: images/Ubuntu2404NobleNumbat.jpg]

<br>
<b>Ubuntu 24.04 Noble Numbat</b>
<br>
<a href="https://releases.ubuntu.com/noble/">Product Link</a>
</td>
<td width="50%" align="center">
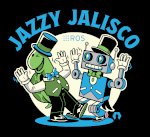
[picture p88: images/ROS2_Jazzy.png]

<br>
<b>ROS2 Jazzy</b>
<br>
<a href="https://docs.ros.org/en/jazzy/index.html">Product Link</a>
</td>
</tr>
<tr>
<td width="50%" align="center">
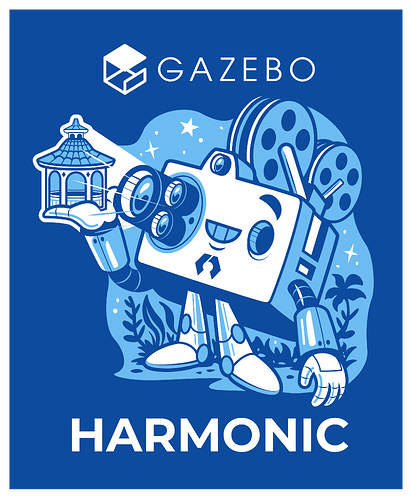
[picture p89: images/Gazebo Harmonic.png]

<br>
<b>Gazebo Harmonic</b>
<br>
<a href="https://gazebosim.org/docs/harmonic/getstarted/">Product Link</a>
</td>
<td width="50%" align="center">
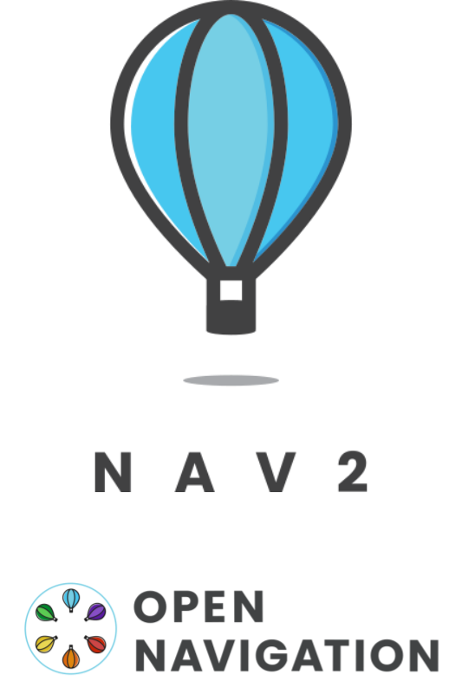
[picture p90: images/nav2_logo.png]

<br>
<b>ROS2 Navigation2</b>
<br>
<a href="https://github.com/ros-navigation/navigation2">Product Link</a>
</td>
</tr>
</table>

## MISSIONS

**Autonomous house exploration & mapping with WiFi signal strength**

See Floorbot Challenge with extra features

https://youtu.be/wo1sceOkqcI

**Floorbot Challenge I Using Nav2 Goal Pose**

View the Mission: Rviz2 screencast of the path plan

https://www.youtube.com/watch?v=YAfdKwbhIpI

View the Video: iPhone piggyback ride on Stormy 

(between the battery and the emergency stop button) 

https://www.youtube.com/watch?v=Kj8ijCCRR4o

**Floorbot Challenge II Using Waypoints**

View the Mission: RViz2 screencast of the path plan

https://www.youtube.com/watch?v=tqyFS87C4XA

View the Video: RViz2 screencast of the path plan

https://www.youtube.com/watch?v=uny75an7diY

**DISCONTINUED PARTS**

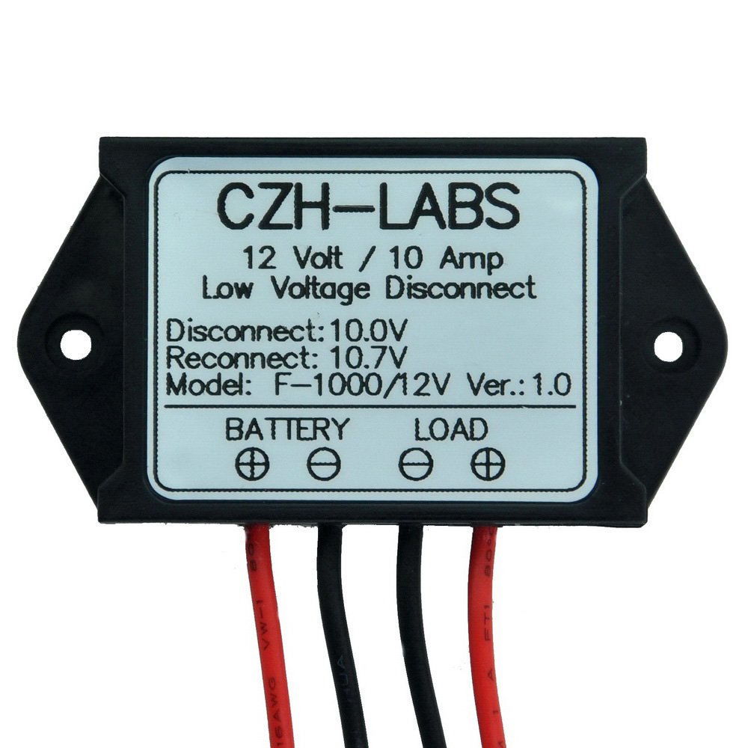
[picture p91: images/CZH-LABS low voltage disconnect photo.jpg]


**Low Voltage Disconnect (not in use)**

(https://www.amazon.com/dp/B019F3BEIO)

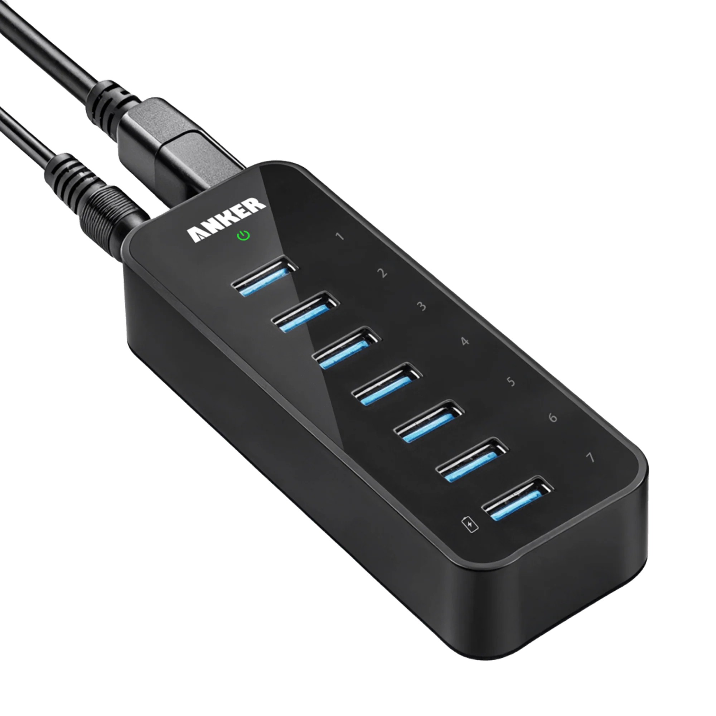
[picture p92: images/AnkerPoweredUSBHub.jpg]


**Powered USB hub NOT IN USE - NOT UP TO THE TASK!**

to power Raspberry Pi and provide peripheral input to Pi (2 separate ports)

(https://www.amazon.com/dp/B014ZQ07NE)

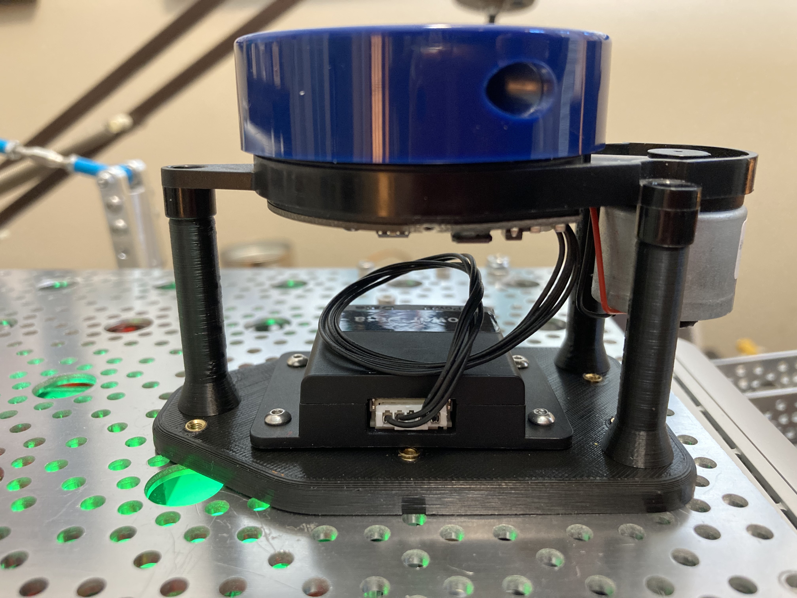
[picture p93: images/YDLIDAR.JPG]


**YDLIDAR X2 drive belt deteriorated after years with no easy replacement.  See LD19 (or LD27 replacement)**

(https://www.amazon.com/dp/B07W613C1K)

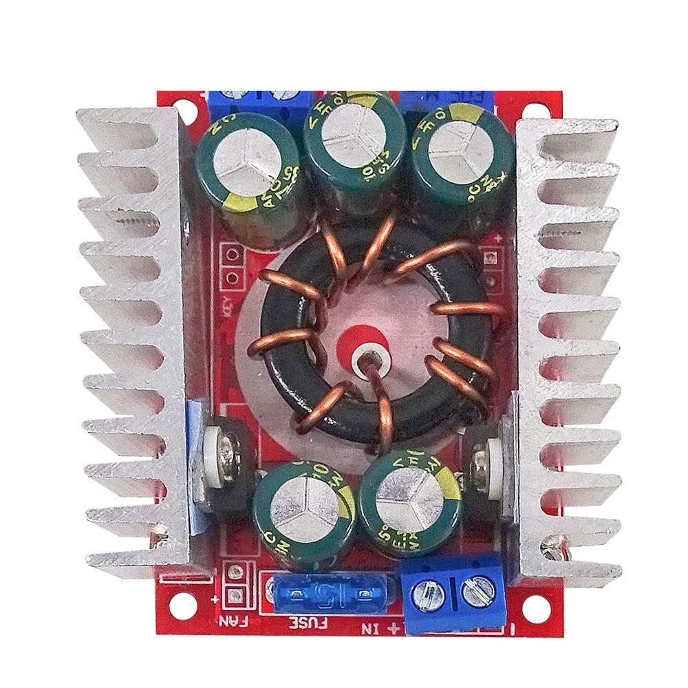
[picture p94: images/Buck Converter 15A DC 4-32V to 12V like Ali Express.jpg]


**Buck voltage converter** Replaced by 52Pi power hat

(https://www.aliexpress.com/item/32881619997.html)
