JHPHELAN/stingray/images/OAK-D Wedge CAD.png

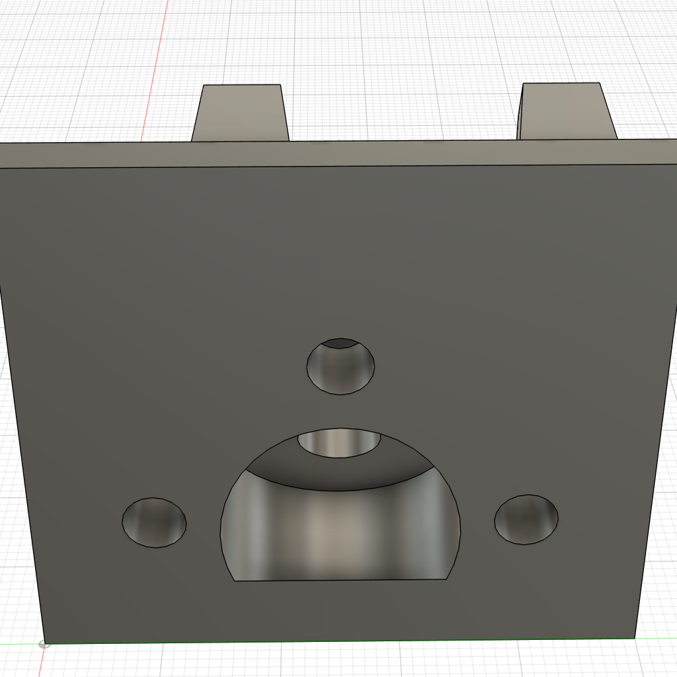
images/OAK-D Wedge CAD.png
