JHPHELAN/stingray/images/Schematic Full 2026-10-14.png

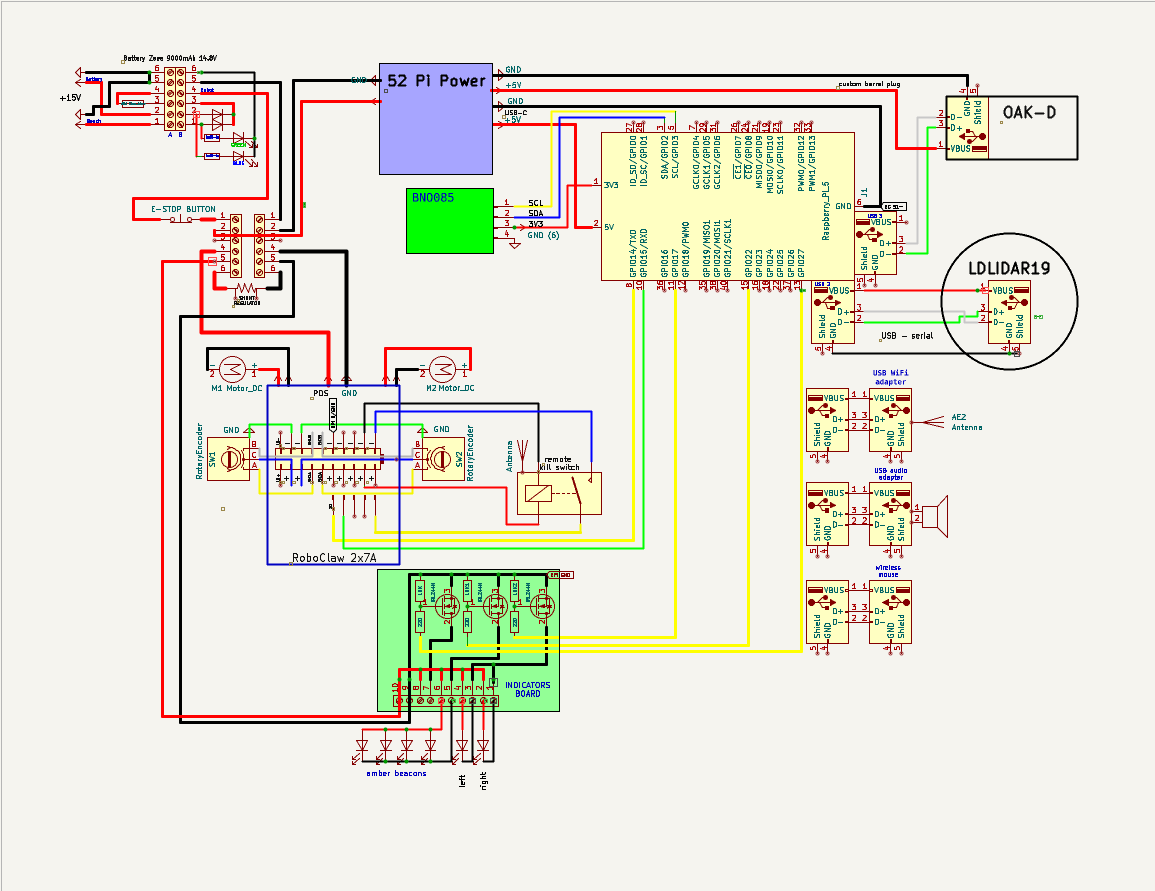
images/Schematic Full 2026-10-14.png
