JHPHELAN/stingray/images/Schematic Power Input 2 LEDs.png

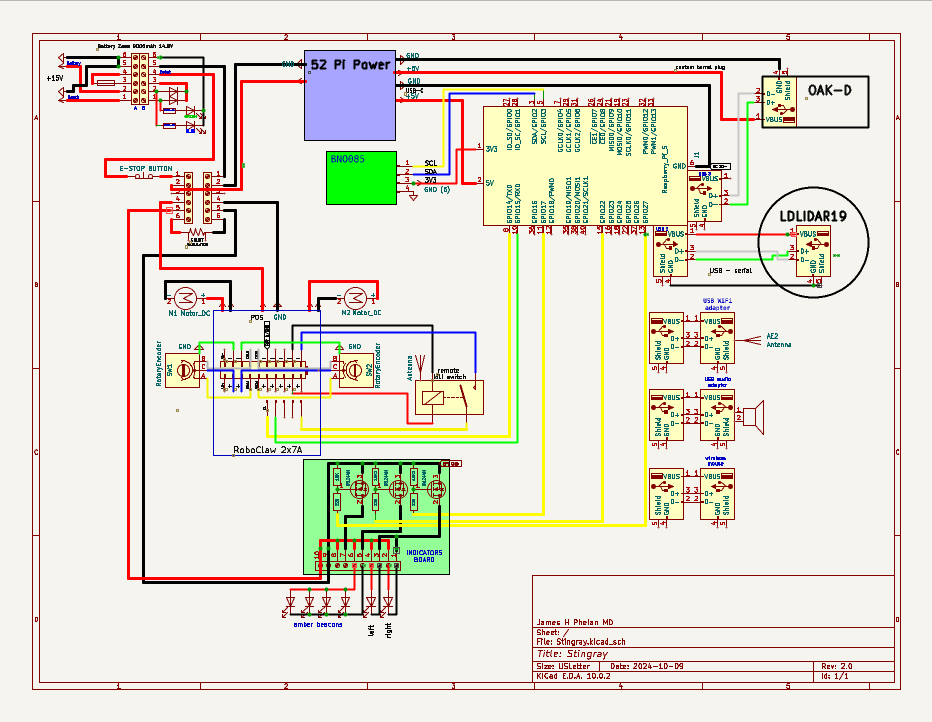
images/Schematic Power Input 2 LEDs.png
