JHPHELAN/stingray/images/USB 3.1 2ft right USB-C straight USB-A.png

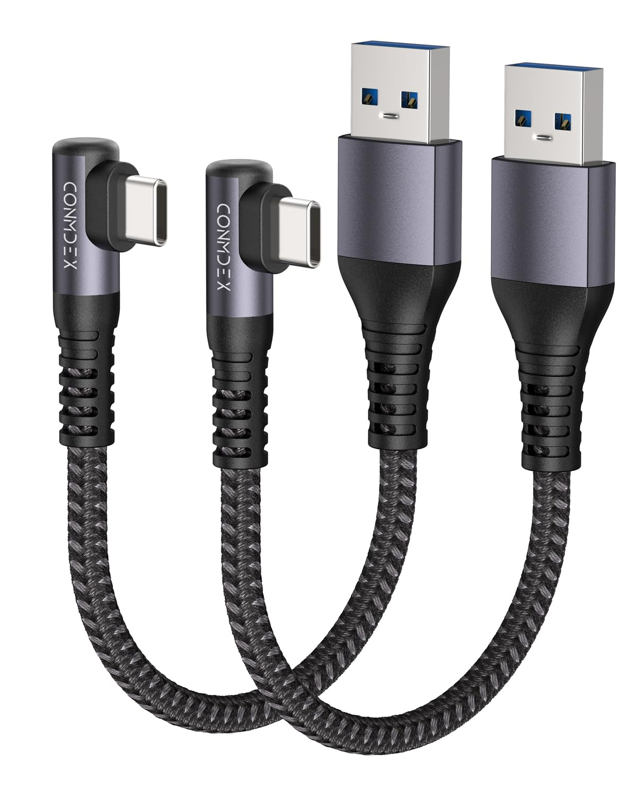
images/USB 3.1 2ft right USB-C straight USB-A.png
