JHPHELAN/stingray/CAD/3D Print/oakd_tilt_wedge_25deg.step

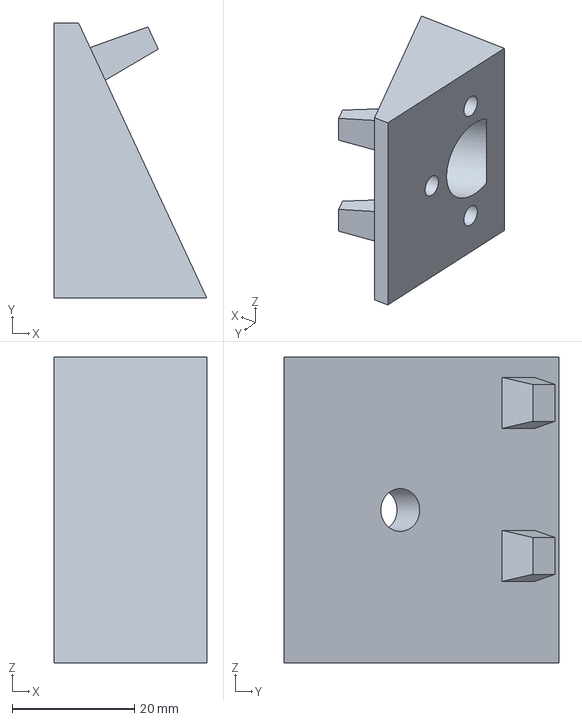
[picture p101: CAD file, 2026-10-31]
CAD/3D Print/oakd_tilt_wedge_25deg.step
25.0 x 45.0 x 50.0 mm
