JHPHELAN/stingray/images/OAK-D wedge on printer.png

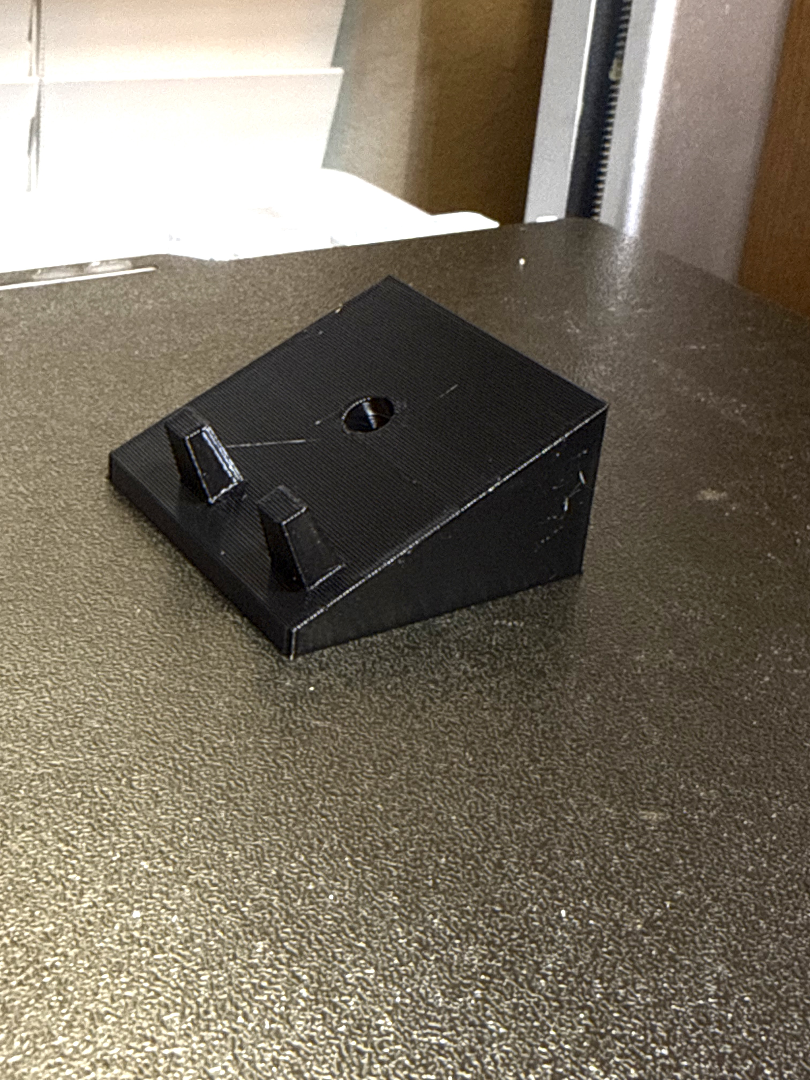
images/OAK-D wedge on printer.png
