JHPHELAN/stingray/kicad/Stingray.kicad_sch

## KiCad design kicad/Stingray.kicad_sch (2026-10-15)

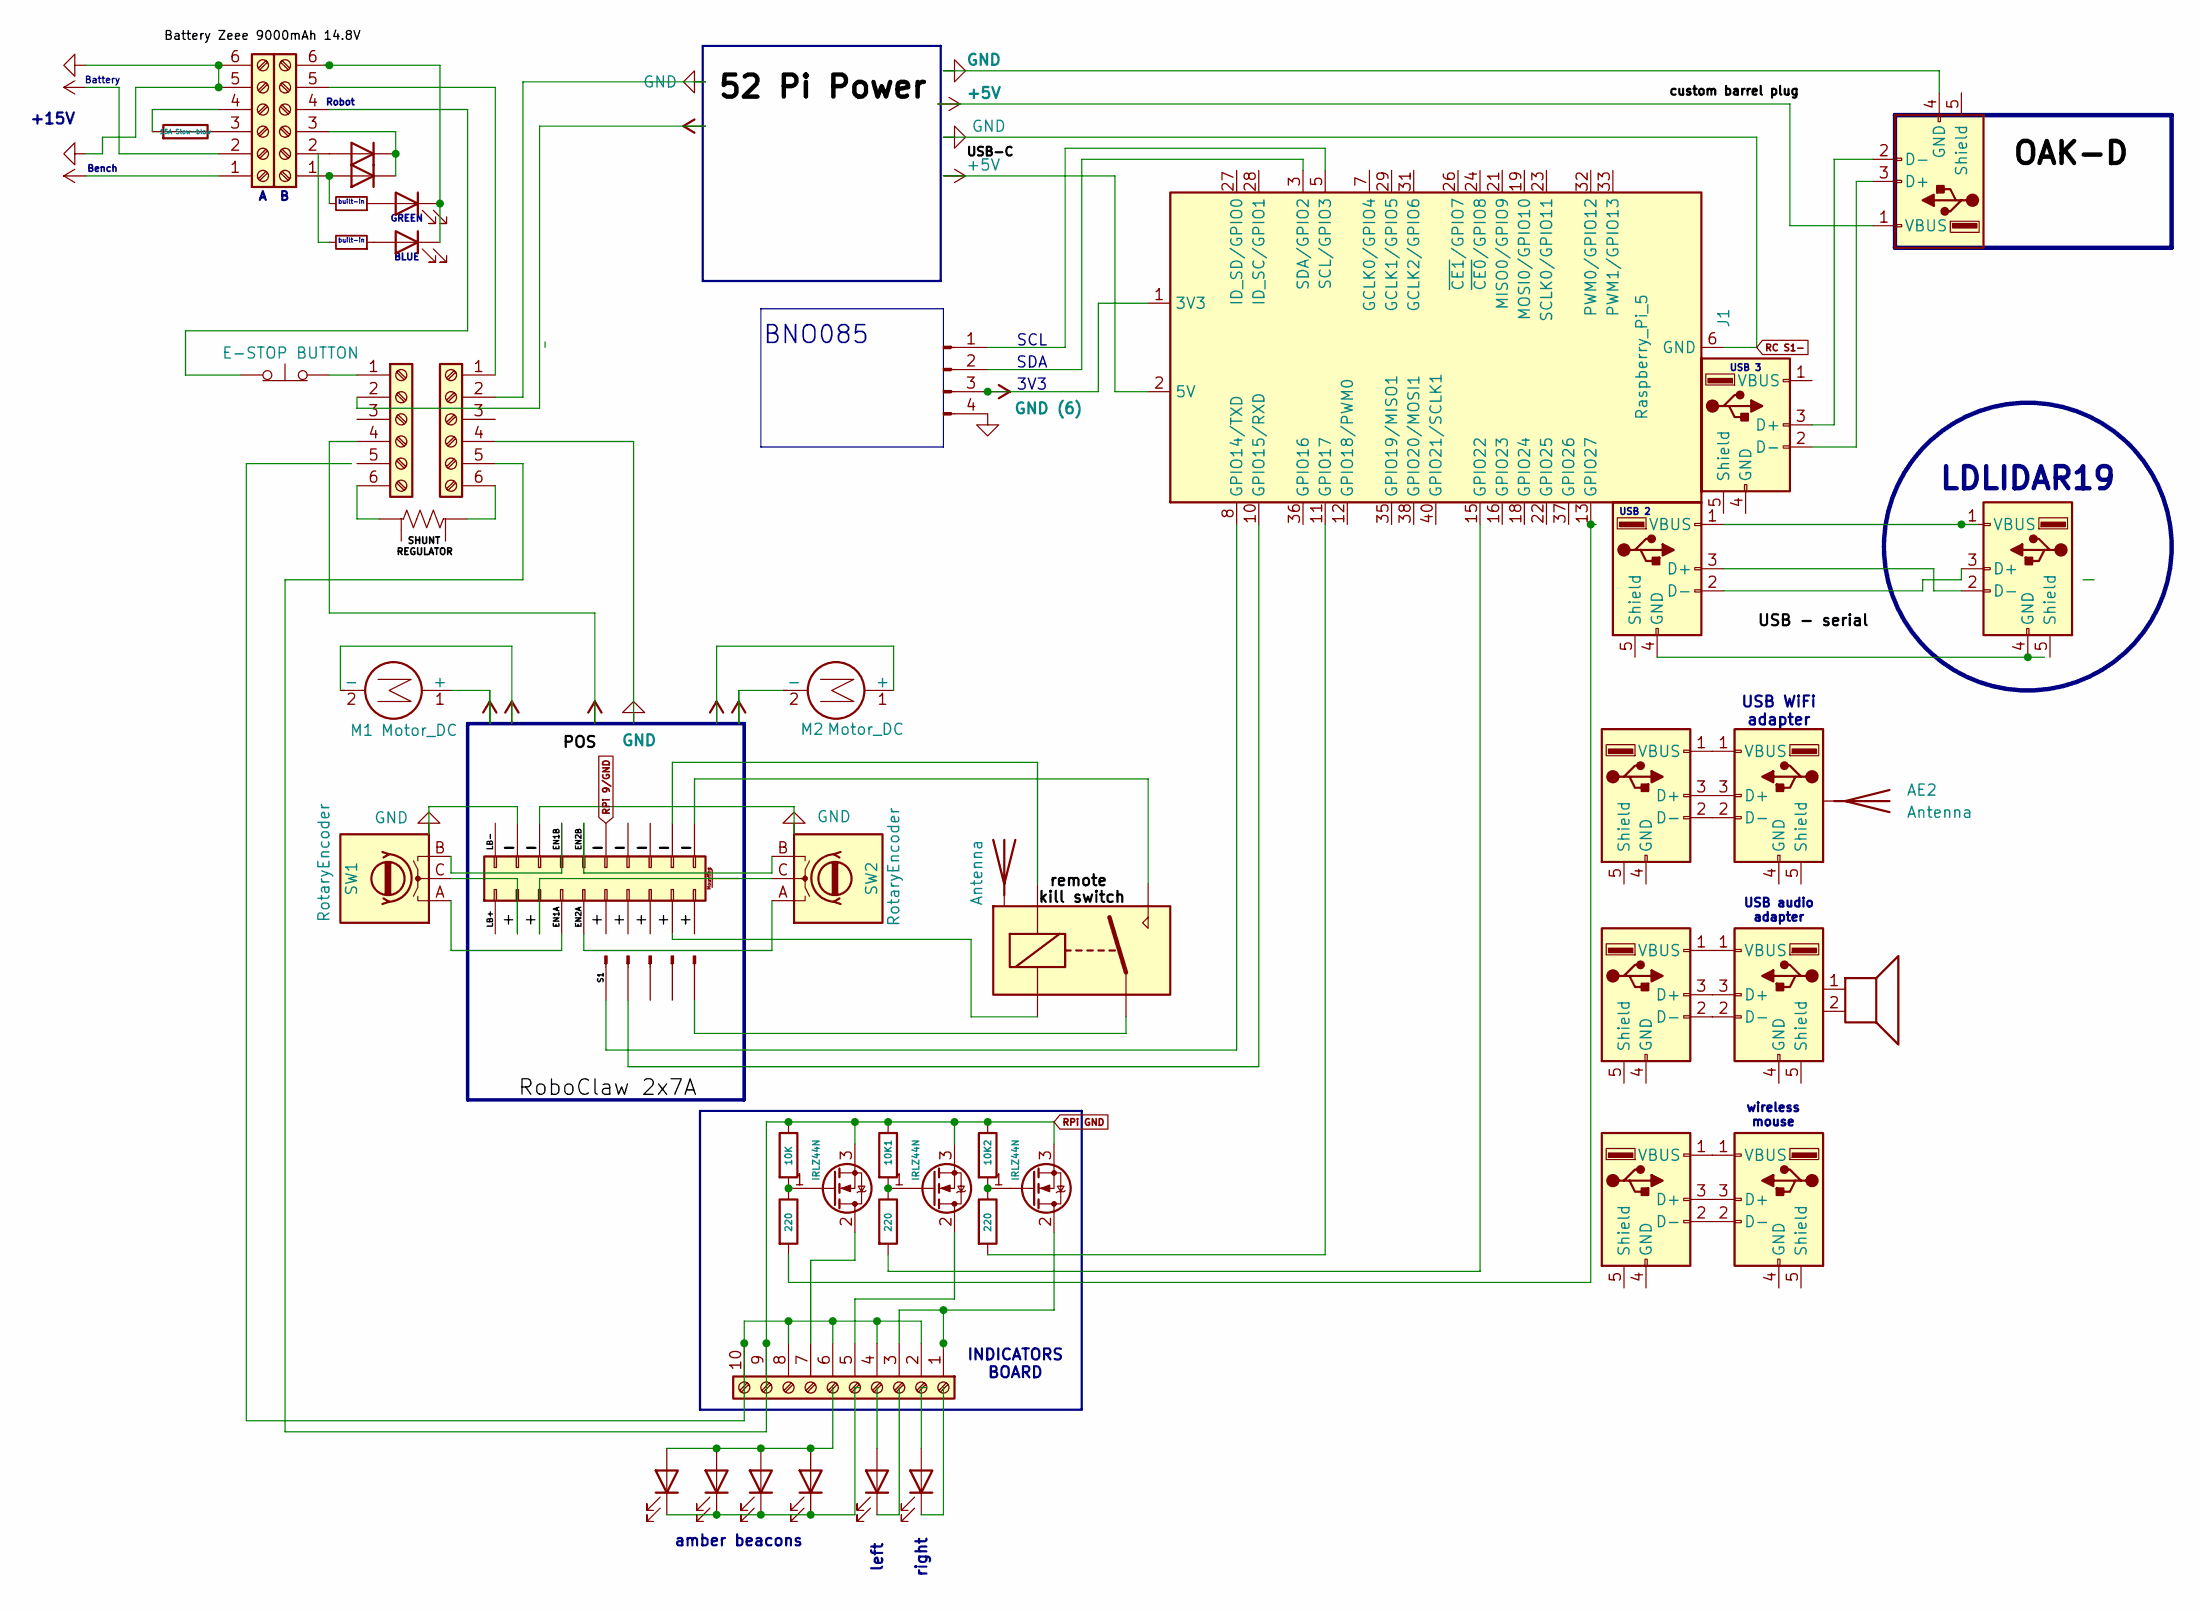
[picture p104: schematic Stingray.kicad_sch]

Parts:
10K, 10K1, 10K2: R
AE1, AE2: Antenna
D1, D2, D3, D4, D5, D6, D7, D8: LED
D10, D11: STPS10L25D; D_DO-35_SOD27_P7.62mm_Horizontal
F5: 15A Slow-blow
J1: Raspberry_Pi_5
J2, J5, J19, J20: Screw_Terminal_01x06
J3: Conn_01x05_Pin
J4, J6, J7, J8, J9, J10, J15, J16, J17, J18: USB_A
J11: Screw_Terminal_01x10
J14: Conn_01x04_Pin
K2: Fujitsu_FTR-LYAA005x; Relay_SPST-NO_Fujitsu_FTR-LYAA005x_FormA_Vertical
LS1: Speaker
M1, M2: Motor_DC
Q1, Q2, Q3: IRLZ44N; TO-220-3_Vertical
R1: (no value)
R2, R3, R4: 220
RoboClaw: RoboClaw
SW1, SW2: RotaryEncoder
SW3: E-STOP BUTTON
built_in, built_in1: R_Small

Connections:
+5V: J1.2 (5V), J1.4 (5V), J6.1 (VBUS)
+15V: J20.1, J20.2
EN1B: RoboClaw.b4, SW1.B
EN2B: RoboClaw.b5, SW2.B
GND: J1.6 (GND), J1.9 (GND), J1.14 (GND), J1.20 (GND), J1.25 (GND), J1.30 (GND), J1.34 (GND), J1.39 (GND), J5.2, J5.4, J6.4 (GND), J20.5, J20.6, RoboClaw.b2, RoboClaw.b3
GND (6): J14.4
unnamed: 10K1.2, Q2.1 (G), R2.1
unnamed: 10K2.2, Q3.1 (G), R4.1
unnamed: 10K.2, Q1.1 (G), R3.1
unnamed: D3.1 (K), D8.1 (K), J19.6
unnamed: D3.2 (A), built_in.1
unnamed: D4.1 (K), D5.1 (K), D6.1 (K), D7.1 (K)
unnamed: D4.2 (A), D5.2 (A), D6.2 (A), D7.2 (A)
unnamed: D8.2 (A), built_in1.1
unnamed: D10.1 (K), D11.1 (K), J19.3
unnamed: D10.2 (A), J19.2
unnamed: D11.2 (A), J19.1, built_in.2
unnamed: F5.1, J20.3
unnamed: F5.2, J20.4
unnamed: J1.1 (3V3), J1.17 (3V3), J2.2, J2.4, J14.3, M1.1 (+), M1.2 (-), M2.1 (+), M2.2 (-)
unnamed: J1.3 (SDA/GPIO2), J14.2
unnamed: J1.5 (SCL/GPIO3), J14.1
unnamed: J1.8 (GPIO14/TXD), J3.1
unnamed: J1.10 (GPIO15/RXD), J3.2
unnamed: J1.11 (GPIO17), R4.2
unnamed: J1.13 (GPIO27), R3.2
unnamed: J1.15 (GPIO22), R2.2
unnamed: J2.1, SW3.2 (B)
unnamed: J2.6, R1.4
unnamed: J3.5, K2.13
unnamed: J4.2 (D-), J6.3 (D+)
unnamed: J4.3 (D+), J6.2 (D-)
unnamed: J5.6, R1.1
unnamed: J7.1 (VBUS), J8.1 (VBUS)
unnamed: J7.2 (D-), J8.3 (D+)
unnamed: J7.3 (D+), J8.2 (D-)
unnamed: J7.4 (GND), J8.4 (GND)
unnamed: J9.1 (VBUS), J10.1 (VBUS)
unnamed: J9.2 (D-), J10.2 (D-)
unnamed: J9.3 (D+), J10.3 (D+)
unnamed: J11.1, J11.3, Q3.2 (D)
unnamed: J11.5, Q2.2 (D)
unnamed: J11.7, Q1.2 (D)
unnamed: J11.2, J11.4, J11.6, J11.8, J11.10
unnamed: J15.1 (VBUS), J16.1 (VBUS)
unnamed: J15.2 (D-), J16.2 (D-)
unnamed: J15.3 (D+), J16.3 (D+)
unnamed: J17.1 (VBUS), J18.1 (VBUS)
unnamed: J17.2 (D-), J18.2 (D-)
unnamed: J17.3 (D+), J18.3 (D+)
unnamed: J19.4, SW3.1 (A)
unnamed: J5.1, J19.5
unnamed: K2.14, RoboClaw.b10
unnamed: K2.A1, RoboClaw.b9
unnamed: K2.A2, RoboClaw.a9
unnamed: RoboClaw.a2, SW1.C
unnamed: RoboClaw.a3, SW2.C
unnamed: RoboClaw.a4, SW1.A
unnamed: RoboClaw.a5, SW2.A
RPi 9/GND: RoboClaw.b6
RPi GND: 10K.1, 10K1.1, 10K2.1, J5.5, J11.9, Q1.3 (S), Q2.3 (S), Q3.3 (S)

Notes on the sheet:
USB 2
A B
Battery
USB audio adapter
USB WiFi adapter
LDLIDAR19
BNO085
SCL
USB 3
INDICATORS BOARD
amber beacons
Robot
right
BLUE
3V3
built-in
SDA
left
wireless mouse
+15V
GREEN
Bench
