JHPHELAN/stingray/kicad/Dual Power Input/Dual Power Input.kicad_sch

## KiCad design kicad/Dual Power Input/Dual Power Input.kicad_sch (2026-10-15)

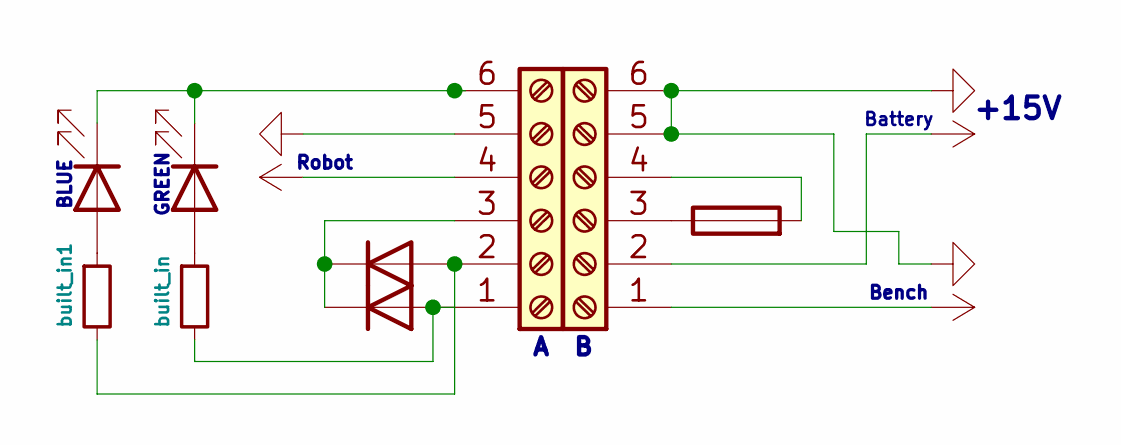
[picture p105: schematic Dual Power Input.kicad_sch]

Parts:
D1, D2: LED
D9, D10: STPS10L25D; D_DO-35_SOD27_P7.62mm_Horizontal
F5: Fuse
J7, J8: Screw_Terminal_01x06
built_in, built_in1: R_Small

Connections:
+15V: J7.4, J8.1, J8.2
GND: J7.5, J8.5, J8.6
unnamed: D1.1 (K), D2.1 (K), J7.6
unnamed: D1.2 (A), built_in.1
unnamed: D2.2 (A), built_in1.1
unnamed: D9.2 (A), J7.2, built_in1.2
unnamed: D9.1 (K), D10.1 (K), J7.3
unnamed: D10.2 (A), J7.1, built_in.2
unnamed: F5.1, J8.3
unnamed: F5.2, J8.4

Notes on the sheet:
+15V
A B
BLUE
Battery
GREEN
Bench
Robot
