JHPHELAN/stingray/(commit log)

2024-12-14 update w/ Mike Wimble
    [robot_core.xacro, robot_gazebo.xacro]
2025-08-15 add low voltage disconnect
2025-08-15 add Low Voltage Disconnect, image, Amazon url
2025-08-17 clarified shunt regulator
2025-08-24 Gearmotor image corrected
    https://www.pololu.com/product/4753
    50:1 37Dx70L mm 12V 64 CPM Encoder 6mm D output shaft
2025-08-24 Revise motor details and images in README
    Updated motor specifications and images in README.
2025-08-24 Wheel image added
2025-08-24 Added 6mm D > 12mm hex wheel hub adapter
    https://banebots.com/t81-hub-6mm-shaft/
2025-08-24 LIDAR FHL-LD19
    Alternative to YDLidar X2 belt drive as replacements unavailable
2025-08-24 added wheel, wheel hub; alternative LIDAR
    Updated wheel, hub; lidar descriptions with additional images and links.
2025-08-24 Revise FHL-LD19 LIDAR description
    Updated description of FHL-LD19 LIDAR in README.
2025-08-30 LiPo battery low voltage screamer added
2025-09-01 Enhance README with wheel metrics and calculations
2025-11-11 Update Low Voltage Disconnect status in README
2025-11-11 Revise LED count and add mission video links
    Updated LED count and added links to mission videos.
2026-01-05 Fix image source for Emergency Stop Button
2026-01-05 DEMOTE Buck voltage converter reference in README
    Updated the README to replace the Buck voltage converter image and link with a note about it being replaced by the 51Pi power hat.
2026-01-05 Update and add Stormy Portraits
    To reflect hardware changes:
    New LIDAR
    Remove Buck Converter
2026-01-06 Revise product images and links in README
    Updated product images and links in the README file, including changes to CPU, Camera options, and Accessories sections.
2026-08-03 Add 38 hardware/tool photos and BOM pricing worksheet
    [BOM_pricing_worksheet.csv]
2026-08-03 Rewrite README as a subsystem-catalogued build guide
    - Add Documentation section pointing at companion Builder's Manual
    - Add rear-caster and motor-bracket WARNING to HARDWARE section
    - Add Structural stock (cast acrylic sheet)
    - Add Bus protection (fuse + holder + Schottky) and Battery
    maintenance (LiPo balance charger) subsections to Power
    - Fix headlights ASIN (B00SOK4702 -> B06ZYKWQZC)
    - Fix ferrule crimper ASIN (B09XJCZHPB -> B0G1TSPZ93)
    - Fix Powerwerks -> Powerwerx brand spelling
    - Reorder Camera table so OAK-D leads
    - Add IMU, Indicators, Networking sections
    - Expand Accessories into Connectors / Wire / Fasteners / Mounting
    / Labeling subsections with 40+ sourced items
    - Add Bill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
2026-08-03 Reconcile BOM: add Acer USB hub (B0CPSSD43L) to Networking; grand total 1874.46 -> 1890.45
    [BOM_pricing_worksheet.csv]
2026-08-03 Reorganize BOM: add Type column (Component/Supply/Tool), sort into three sections, add per-type subtotal rows and README summary
    [BOM_pricing_worksheet.csv]
2026-08-03 README: add bus bar source + protoboard photo; refine parts list
    - 12V power bus: add bus bar Amazon link (B097R5J66D) and photo,
    replacing 'from junk parts' note
    - Bus protection: add protoboard photo showing fuse holder, Schottky,
    and bus taps on a single board for improved connections
    - DuPont jumper connectors: rewrite as 'GPIO connections to RoboClaw,
    BNO085 IMU, Indicators PCB'
    - Silicone wire, Velcro fasteners, heat-shrink: tighten descriptions
    - Standoffs: clarify use of included shorter standoffs for PCIe HAT
    clearance
2026-08-03 README: alternative rear caster - Pololu 3/4in ball caster
    - Add Pololu 3/4in metal ball caster as candidate alternative to the
    Parallax omni-wheel rear caster, with product link, photo, and load
    rating (10 lb vs Stormy's measured 0.549 kg rear-caster load; total
    robot mass 3.269 kg)
    - Document two compensation approaches for the 0.83in height:
    rotate drive motors 180 deg to drop wheels ~1 cm, or a 1/4in
    acrylic riser mount on top of the lower plate
    - Add three measured bracket views (right, rear, top) with ruler,
    replacing the TODO for close-up photos
    - Convert exploded diagram and Stormy bottom view references from
    markdown link syntax to inline HTML img tags so they render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
2026-08-03 Add CorelDRAW 2018 CAD drawings for laser-cut acrylic plates
    - Stingray Bottom Plate.cdr
    - Stingray Top Plate.cdr
    - Stingray Side Panel Blank.cdr (blank example with fuse-holder hole)
    Replaces the TODO in the Structural stock section.
2026-08-04 Add JPEG previews for CAD plate drawings
    - Stingray Bottom Plate.jpg / Top Plate.jpg / Side Panel Blank.jpg:
    exports from the .cdr files so readers can see the layouts without
    CorelDRAW
    - README: replace bullet list with a 3-cell table showing each
    preview above its .cdr download link
    - .gitignore: ignore CorelDRAW Backup_of_*.cdr auto-backups
2026-08-14 README: add full schematic under hero image
    - images/Stormy Schematic 2026-08-12.png (KiCad 10.0 full schematic)
    - inserted directly under Stormy Portrait angle hero image
    - matches placement already in stingray-builders-manual
2026-08-14 Indicators: add CHANZON multicolor LED assortment
    - 3-across parts row (DAC, speaker, LEDs)
    - Amazon B08G4XCQSW; image images/LEDs Multicolor CHANZON.png
    - drop 'amber LED assortment' from TODO (now covered)
2026-08-14 Move headlights from Power to Indicators
    - Indicators parts table now 2x2: DAC/speaker on top, headlights/CHANZON LEDs below
    - Power table row 3: kill switch + DPDT, empty middle cell keeps column alignment
2026-09-20 system schematic updated
    Showing new power input circuit and BNO085
2026-09-20 Update schematic date and image source in README
    new power input circuit and BNO085
2026-09-20 Power Input Right Rear Panel images added
    schematic, CorelDraw CAD, front, back, diode, terminal strip, PowerPole
2026-09-20 Rename IMG_8948.png to Power Input rear.png
2026-09-20 Rename images/IMG_8950.png to Power Input front.png
2026-09-20 Power Input front image added
2026-09-20 Power Input Panel terminal strip image added
2026-09-20 Power Input Panel rear image added
    first try failed
2026-09-20 Revise Power Input Panel
    Updated the section on power input panel including new images and product links.
2026-09-21 Remove stray empty file at repo root; real image is images/Power Input front.png
2026-09-27 Power Input Side Panel updated with LED
    POWER ON green LED added to Bench port to indicate if Bench power is on
2026-09-27 Bench POWER ON LED added to schematic
2026-09-27 photo of Power Input Panel with LED illuminated
2026-09-27 Power Input Side Panel LED photo 50%
2026-09-27 Revise Power Input Panel with Bench POWER ON LED
2026-09-27 updated photos of Power Input Panel with LED
2026-09-27 images: prune 8 orphans not referenced in README
    Removed (each unreferenced anywhere in README.md; verified via
    - README.md (stray markdown file in images/, not an image)
    - 14AWG silicone power wire.jpg
    - BNO055_Adafruit_AbsOrientSensor.jpg (superseded by BNO085)
    - Plololu Gearmotor 4752.jpg (typo filename, obsolete part)
    - Stormy Logo Logo50pct.jpg (resize-experiment leftover)
    - Stormy Schematic 2026.09.20.png (superseded by 'Schematic LED' variant)
    - bus protection protoboard.png (pre-rewire, superseded by Power Input Panel)
    - stingray sage reflective background.png
2026-10-05 Batt input LED added to Power Input Panel
2026-10-05 CAD file of Power Input Panel 2 LEDs
2026-10-05 Update images in README.md for second Batt blue LED
2026-10-05 images: delete orphan Stormy Schematic LED.png (replaced by Schematic Power Input 2 LEDs.png)
2026-10-15 Update schematic image and add downloadable KiCad project
    Replace images/Schematic Power Input 2 LEDs.png with the full
    schematic (Schematic Full 2026-10-14.png), update the README
    reference and caption date, and add the editable KiCad 10.0
    project under kicad/ (backups excluded) with a README download link.
2026-10-17 Backfill handoff notes (10-11, 10-16, 10-17) + harden session rituals
    notes/ only had NOTES-2026-10-10, so each new session's OPEN read stale state and
    re-derived already-solved fixes (Force3DoF, scan-grid, XAUTHORITY auto-discover,
    nav2 filters:[]). Commit the stranded 10-11/10-16/10-17 write-ups and fix
    copilot-instructions.md: notes live in THIS repo's notes/, OPEN must read
    copilot-instructions.md + context.txt + the NEWEST note, and session-state copies
    are drafts that must be pushed here.
2026-10-18 CLOSE 2026-10-17: finalize handoff note (map cleanup in-progress + reconciliation + TODO)
    Recap/Remember/Push. Records the fresh-SLAM map-cleanup state (lidar grid, Force3DoF
    already on, coverage incomplete), the notes/context/repo reconciliation done today, and
    tomorrow's ordered TODO.
2026-10-19 Session 2026-10-19: first real-house RTAB-Map/Nav2/explore run; root cause loose right-wheel setscrew
    Handoff note + context.txt: real-robot explore recipe (stingray.hardware.launch.py,
    rtabmap compressed transport, nav2_params_mapping.yaml, explore.yaml use_sim_time fix),
    WiFi-compressed-image lesson, Nav2 indoor tuning (inflation 0.30, oak_points off), and the
    delocalization/erratic-drive incident whose ROOT CAUSE was a loose right-wheel setscrew
    (encoders read the motor, slipping wheel -> false odom -> RTAB-Map delocalized -> erratic drive).
    Logs showed no software/driver fault. Robot code is on articubot_one exploration ade00cc.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
2026-10-26 notes: OAK-D tilt wedge PETG fit test; widen nubs 24 -> 25 mm
    PETG fit test good (handedness correct). Nubs needed ~1 mm more spacing;
    moved each 0.5 mm out (NUB_Z_OFFSETS 7/-17 -> 7.5/-17.5). STEP+STL regenerated,
    watertight. Add NOTES-2026-10-26 and context.txt dated entry; robot-side
    2026-10-19 items unchanged/parked.
2026-10-26 notes+context: install wifi_logger_visualizer v2 (Mike Wimble) on Stingray
    New NOTES-2026-10-26-wifi-logger-v2-install.md: branch layout (pristine wimble-v2
    mirror + local/stingray-v2 override layer, old local/stingray preserved), override
    rationale, verified passive-launch, daily commands, parked wheel reminder, next=live run.
    context.txt: durable WiFi coverage-logging subsection (home AP MACs kept out of git).
2026-10-27 Dual MOSFET image added
2026-10-27 add images for DuaL MOSFET switches
2026-10-27 Replace old schematic image with new version
    https://github.com/JHPHELAN/stingray/blob/main/images/Schematic%20Full%2020261026.png
2026-10-27 Revise design journey with new Dual MOSFET switches
    Updated the design journey section with new information about the PCB revisions and MOSFET switches.
2026-10-27 notes: OAK-D tilt wedge FINALIZED (fit-tested perfect)
    Correct and complete the 2026-10-26 wedge note to the final state: FLIP_LR true
    (nubs un-mirrored, Z=17.5/42.5), 3rd heat-set insert restored (isosceles apex),
    tripod counterbore 6->9 mm for a fatter screw head. Capture two lessons: divergent
    wedge.py copies dropped the 3rd insert (now all byte-identical), and stale .3mf
    slicer projects embed old mesh (import the fresh STL into a new project; stale
    exports deleted). Add a terse OAK-D-on-tilt-wedge hardware line to context.txt.
2026-10-27 kicad: update Stingray schematic - Dual MOSFET power switches
    Upload the updated KiCAD source from HankRearden (KiCad 10.0 working copy):
    Stingray.kicad_sch reworked with the dual MOSFET high-power switches, plus the
    matching Stingray.kicad_pro settings. Matches the new schematic/images already on
    main.
2026-10-27 kicad: stop tracking .kicad_prl (per-user UI state)
    Add *.kicad_prl to .gitignore and untrack the two committed .prl files; they are
    KiCAD per-user project-local state, not design data. Local copies are kept.
2026-10-27 notes/context: record KiCAD schematic sync + .kicad_prl ignore
    Add a repo-housekeeping section to the 2026-10-26 handoff note (GitHub pull of the
    dual-MOSFET schematic/images, KiCAD source upload from KiCad 10.0 working copy, and
    *.kicad_prl gitignore). Add KiCAD as a durable HankRearden tool in context.txt with
    the project location and repo mapping.
2026-10-29 notes: OAK-D 25 deg tilt wedge added to the URDF (2026-10-28)
    New notes/NOTES-2026-10-28-oakd-wedge-urdf.md: wedge modeled in articubot_one
    (description/oakd_wedge.xacro + simplified assets/meshes/oakd_wedge.stl), geometry
    derivation, and the RViz-resolves-meshes-locally lesson. context.txt OAK-D line gets
    a stable pointer to the URDF wedge files.
2026-10-31 Document OAK-D 25deg tilt wedge; reorganize kicad/ into CAD/
    - README: new "OAK-D 25deg tilt wedge" section under Camera (before/after
    dock views, build photos, USB-cable swap with product link); repoint the
    KiCad project links from kicad/ to CAD/KiCAD/.
    - Reorg kicad/ -> CAD/ so the folder can hold multiple CAD types:
    CAD/KiCAD/ (moved project), CAD/CorelDraw/ (wedge .cdr),
    CAD/3D Print/ (wedge .step).
    - Add .gitattributes marking *.step/*.stp/*.cdr as binary (verbatim store).
    - Add 7 wedge / USB-cable images.
2026-10-31 Drop oversized USB cable photo; keep note + product link
    The USB 3.1 right-angle cable image was large and unnecessary. Removed the
    image and its README figure, folding the cable description and Amazon
    product link into the existing one-line note.
2026-10-31 README: add section anchors; move CorelDRAW .cdr into CAD/CorelDraw
    - Convert three bold pseudo-headings to real Markdown headings so GitHub
    gives them hover anchors: "Stormy full schematic", "Download the editable
    KiCad 10.0 project", and "CorelDRAW 2018 CAD drawings for laser cutting".
    - Move the laser-cut .cdr drawings from images/ to CAD/CorelDraw/ and
    repoint the README download links there (thumbnails stay in images/).
2026-10-31 Session close 2026-10-31: context.txt scope rule + today's NOTES
    - context.txt: add SCOPE rule (stable facts only; day-to-day -> NOTES-); update
    the stable CAD-folder paths for the kicad/ -> CAD/ reorg.
    - notes/NOTES-2026-10-31: record the OAK-D wedge footprint update, README wedge
    section, and CAD reorg; include a ready-to-run RTAB-Map hand-drive recipe so a
    fresh chat can pick it up.
2026-11-01 notes: RTAB-Map wedge re-run — pipeline fixed, odom truthful, GTSAM optimize failed
    Session note NOTES-2026-10-31-rtabmap-wedge-rerun-optimizer-fail.md:
    - compressed:=true on-Pi inserted broken decompress relays (depth expects a
    nonexistent compressedDepth topic) -> starved approx-sync. Fix: drop
    compressed:=true, feed raw /oak/rgb/image_rect + /oak/stereo/image_raw.
    - odometry verified truthful both directions before mapping.
    - map unusable: GTSAM indeterminant/underconstrained, all loop closures
    rejected, optimized graph empty. Next run: --Optimizer/Strategy 1 (g2o),
    fallback --Optimizer/GravitySigma 0.
    context.txt: added stable rule that on-Pi rtabmap omits compressed:=true.
    Co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
2026-11-01 notes: add OAK-D 25deg over-tilt finding + wedge-angle decision for tomorrow
    RGB bottom edge ~14deg above horizon (lens 95mm up); 25deg was sized to the
    wide stereo-depth VFOV so the narrow RGB aims too high. Captured the angle/
    floor-distance tradeoff table and the reprint path (wedge.py + oakd_wedge.xacro
    wedge_tilt + STL/STEP) so tomorrow's session sees it.
2026-11-01 README/context: OAK-D mounted flat; 25 deg wedge tried then removed
    The 25 deg tilt wedge over-tilted the OAK-D (RGB bottom edge ~14 deg above horizontal, blind to the near floor). Returned the camera to a flat mount, which geometrically already lands the floor at the depth ~0.20 m min range (0.20*sin25 ~= 8.5 cm ~= the 9 cm lens height).
    - README: replace the wedge build section with a short retrospective + a flat-vs-wedged floor-view comparison; drop the wedge-era USB cable note.
    - context.txt: OAK-D stable fact rewritten to the flat mount (pitch=0).
    - Remove 4 wedge build photos + CAD/3D Print/oakd_tilt_wedge_25deg.step + CAD/CorelDraw/01 OAK-D Center Plate Wedge.cdr (kept the dock wed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
2026-11-01 notes 2026-11-01: OAK-D flat, indicators beacon self-test, RTAB-Map g2o re-run aborted by right-wheel setscrew
    Handoff note + two durable context.txt facts (recurring right-wheel setscrew; OAK-D USB blue-port/reseat gotcha). Session: wedge removed/camera flat (917019c, 54f2915), indicators boot beacon self-test (e6139d5), PR #4 signed off, keepout via launchkeepout, RTAB-Map re-run with --Optimizer/Strategy 1 looked healthy but was aborted mid-drive by the loose right-wheel setscrew (odom lying); run abandoned, db not saved.
2026-11-02 RTAB-Map g2o re-run succeeded: office map keeper; correct right-wheel record
    The 2026-11-01 g2o re-run (Optimizer/Strategy 1) solved the pose graph that GTSAM
    could not: 298 WM / 804 LTM nodes, 125 GlobalClosures, optimized graph bounded (no
    1e7 blow-up), rtabmap-export --map succeeds. Office map is good enough to expand on.
    context.txt right-wheel block corrected: the first-11-01 abort was NOT the setscrew
    (wheels were tight, undiagnosed circling split out as a separate intermittent event).
2026-11-06 RTAB-Map multi-session expand: Study continue + hallway venture; loop-closure logging clarified
    Proved continue/expand mapping (delete_db_on_start:=false): the 11-01 map now spans Study +
    hallway across 4 fused sessions (708 WM nodes), verified by cross-session loop closures in the
    db. Clarified that accepted closures log at INFO (suppressed at the Pi WARN console) while only
    rejections show — watch closures via /rtabmap/info loop_closure_id or rtabmap_viz instead.
    context.txt gains stable facts: g2o optimizer, multi-session expand procedure, closure-logging
    visibility, rtabmap GUI viewers + X11-forwarding note. No robot-code changes.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
