JHPHELAN/stingray/images/OAK-D wedge profile.png

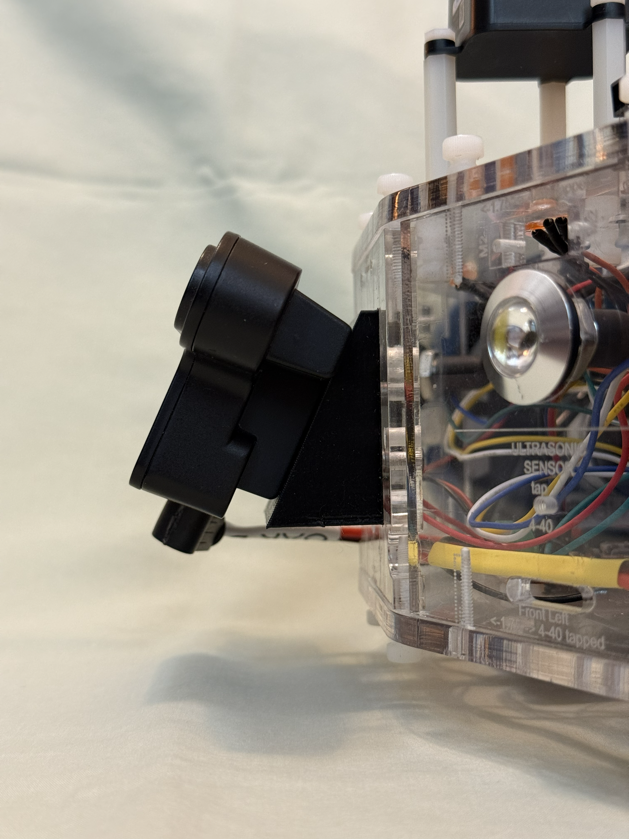
images/OAK-D wedge profile.png
