JHPHELAN/stingray/images/OAK-D wedge robot side.png

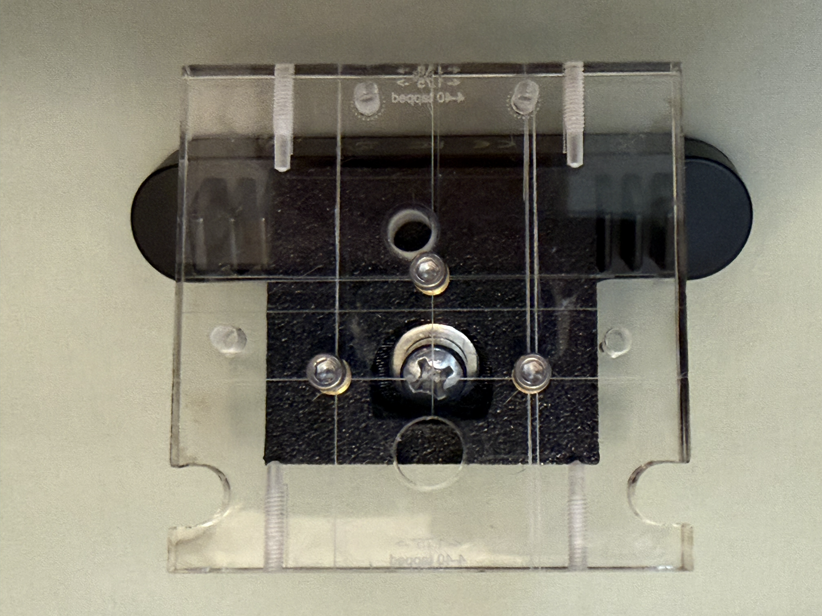
images/OAK-D wedge robot side.png
