JHPHELAN/stingray/images/Stormy Portrait Bottom.jpg

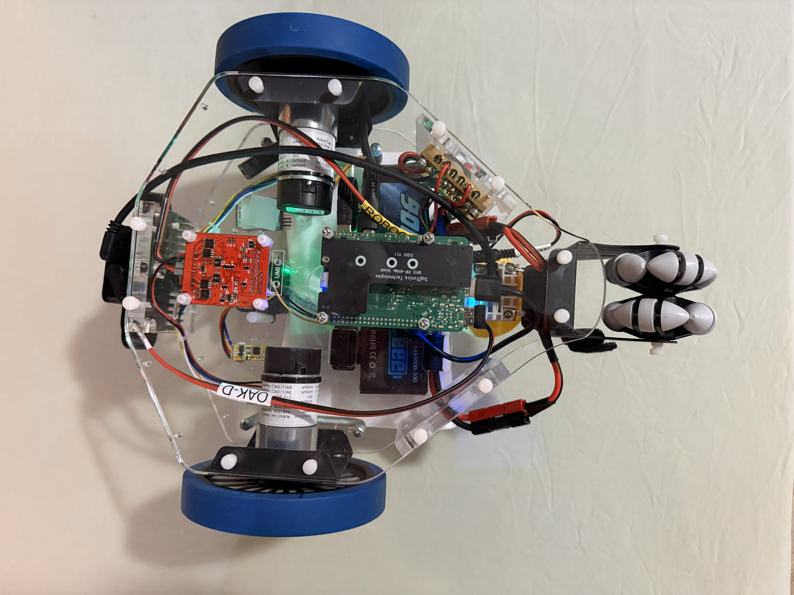
[picture p12: images/Stormy Portrait Bottom.jpg]
images/Stormy Portrait Bottom.jpg
